jdszza/valoryapsen/README.md

# APSEN — Sistema de Contagem de Medicamentos

> **Projeto de Engenharia Mecatrônica — 3º ano** · Valory · APSEN Farmacêutica

Célula automatizada que monta Ordens de Saída (OS) de medicamento e valida cada
dispensa por **três fontes independentes**. Roda hoje inteira em Docker, com os
sensores e atuadores simulados; os três firmwares que vão substituir os
simuladores já têm contrato e transporte prontos do lado Python.

| Onde está o quê | |
|---|---|
| **Como o sistema funciona e como rodá-lo** | este arquivo |
| **Por que cada decisão foi tomada** (e as armadilhas) | `CLAUDE.md` |
| **Contrato serial adapter ↔ firmware** | [`docs/PROTOCOLO_SERIAL.md`](docs/PROTOCOLO_SERIAL.md) |
| **As estações de visão reais** | [`vision/README.md`](vision/README.md) |
| **Painel de bancada e display de 7"** | [`docs/BANCADA.md`](docs/BANCADA.md) |

---

## Índice

- [Visão geral](#visão-geral)
- [Arquitetura](#arquitetura) — serviços, os dois transportes, o estado dos firmwares
- [A célula por dentro](#a-célula-por-dentro) — layout, câmeras, Triple Check, fluxo
- [As 10 ordens padrão](#as-10-ordens-padrão)
- [Subir a stack](#subir-a-stack)
- [Rodar tudo integrado, passo a passo](#rodar-tudo-integrado-passo-a-passo) — a célula montada, com placas e câmeras de verdade
- [Portas seriais na célula montada](#portas-seriais-na-célula-montada) — ⚠️ leia antes de ligar as placas
- [Operar](#operar) — console, modo apresentação, injeção, reset, pré-voo
- [Roteiro de demonstração](#roteiro-de-demonstração)
- [Testes](#testes)
- [Painel de bancada](#painel-de-bancada)
- [Interfaces e segredos](#interfaces-e-segredos)
- [Endpoints](#endpoints)
- [Estrutura do repositório](#estrutura-do-repositório)
- [Variáveis de ambiente](#variáveis-de-ambiente)
- [Concorrência e segurança](#concorrência-e-segurança)

---

## Visão geral

Uma mesa CNC percorre o corredor entre **duas fileiras de 4 dispensers**, frente
a frente, coletando os medicamentos de cada OS. **Três câmeras** validam a
célula: uma sobre cada fileira (lendo o QR/DataMatrix do produto carregado em
cada slot) e uma sobre a mesa de coleta — a **câmera da balança** —, que conta
visualmente as unidades dispensadas. Uma célula de carga HX711 sob a mesa pesa
cada lote.

Depois de cada dispensa, o **Triple Check** compara as três fontes (contagem do
dispenser, câmera da mesa, balança). **Uma divergência já trava o sistema** até
um supervisor liberar.

Comunicação 100% REST/HTTP + WebSocket — **sem MQTT**. MySQL para persistência,
Plotly Dash para as interfaces.

### Duas metades, que sobem separado

| Metade | O que é | Como sobe | Portas |
|---|---|---|---|
| **Célula** | central, 4 adapters, 4 simuladores, ERP, dashboard, manutenção | `docker compose up` | 8000, 8050, 8051 |
| **Painel de bancada** | Flask + SQLite + display ESP32 por USB serial | `python app.py` na máquina da bancada | 5000 |

O painel **não** está no compose de propósito: ele é dono de uma porta serial, e
container Linux não enxerga a COM do host. Ver [`docs/BANCADA.md`](docs/BANCADA.md).

---

## Arquitetura

```
ERP Simulator (dispara 1 das 10 ordens padrão, com os_id novo)
  │ POST /api/v1/ordens
  ▼
┌────────────────────────────────────────────────────────────────────┐
│                     Central Computer  :8000                        │
│   Orquestrador (orchestrator.py)                                   │
│   • fila de OS (1 por vez, teto MAX_FILA_OS)                       │
│   • atribuição de slots por categoria / residual                   │
│   • rota CNC em serpentina (duas fileiras)                         │
│   • carga → visão dispenser → CNC → dispensa → visão mesa →        │
│     peso → Triple Check                                            │
│   • trava de erro: bloqueia até supervisor/admin liberar           │
│   REST + MySQL + WebSocket /ws + console /console                  │
└──────┬────────────────┬─────────────────┬───────────────┬──────────┘
       │                │                 │               │
┌──────▼──────┐  ┌──────▼──────┐  ┌──────▼──────┐  ┌──────▼──────┐
│  Dispenser  │  │    CNC      │  │   Vision    │  │   Weight    │
│  Adapter    │  │   Adapter   │  │   Adapter   │  │   Adapter   │
│   :8100     │  │    :8101    │  │    :8102    │  │    :8103    │
└──────┬──────┘  └──────┬──────┘  └──────┬──────┘  └──────┬──────┘
       │ http | serial  │ http | serial   │ http          │ http | serial
┌──────▼──────┐  ┌──────▼──────┐  ┌──────▼──────┐  ┌──────▼──────┐
│  Dispenser  │  │    CNC      │  │   Vision    │  │   Weight    │
│  Simulator  │  │  Simulator  │  │  Simulator  │  │  Simulator  │
│   :8201     │  │    :8200    │  │    :8202    │  │    :8203    │
│  8 slots    │  │ mesa CNC    │  │ 3 câmeras   │  │ HX711       │
└─────────────┘  └─────────────┘  └─────────────┘  └─────────────┘

Dashboard  :8050  ←─ polling /estado ──────── Central
Manutenção :8051  ←─ JWT + REST + WS ──────── Central
MySQL      :3306  ←─ pymysql (pool) ───────── Central
Painel     :5000  ─ GET (espelho de mão única) → Central
                   └─ USB serial → display ESP32 7"
```

### Serviços Docker (13)

| Serviço | Porta | Função |
|---|---|---|
| `mysql` | 3306 | MySQL 8 — 11 tabelas, 96 medicamentos no seed |
| `central-computer` | 8000 | Orquestrador, API REST, WebSocket, console |
| `dispenser-adapter` | 8100 | Bridge central ↔ dispensers |
| `cnc-adapter` | 8101 | Bridge central ↔ mesa CNC |
| `vision-adapter` | 8102 | Bridge central ↔ câmeras (simulador ou estações reais) |
| `weight-adapter` | 8103 | Bridge central ↔ balança HX711 |
| `dispenser-simulator` | 8201 | Simula os 8 dispensers (mecânico, sem CV) |
| `cnc-simulator` | 8200 | Simula o firmware da mesa |
| `vision-simulator` | 8202 | Simula as 3 câmeras (rollback das estações reais) |
| `weight-simulator` | 8203 | Simula a célula de carga sob a mesa |
| `erp-simulator` | — | O ERP do hospital: dispara 1 das 10 ordens por ciclo |
| `dashboard` | 8050 | Monitoramento read-only (Dash) |
| `manut_web` | 8051 | Manutenção e operação, com JWT (Dash) |

O **`porta-adapter`** (:8104, a ponte central ↔ porta NR-12) **não** está nesta
tabela de propósito: ele não tem serviço no compose. Não existe porta simulada,
e na célula montada ele roda no host, dono da COM do ESP RECEPTOR da porta,
que ele só LÊ (`porta-adapter\iniciar_host.bat`; `docs/PROTOCOLO_SERIAL.md` §10). Sem porta na célula
(`PORTA_NR12_HABILITADA=0`, o default) ninguém fala com ele.

**Ordem de subida.** Todos os serviços de aplicação têm healthcheck (menos o
`erp-simulator`, que é worker de laço sem porta) e as dependências usam
`condition: service_healthy`. O grafo é
`mysql → central → adapters → erp-simulator`, com os simuladores entrando ao
lado do central. O central **não** depende dos adapters — seria ciclo, e ele
tolera adapter fora do ar.

**Profiles.** Os três adapters seriais e os quatro simuladores ficam atrás do
profile `simulado` (`COMPOSE_PROFILES=simulado` no `.env`): na célula montada,
em Windows, eles não sobem em container (o `porta-adapter` nunca sobe: não
está no compose) — ver
[Portas seriais na célula montada](#portas-seriais-na-célula-montada).

### Os adapters têm DOIS transportes

Cada adapter fala com a ponta de baixo por HTTP (o simulador) **ou** por serial
(o firmware), e quem escolhe é uma env var. O default é `http`:

| Variável | Default | |
|---|---|---|
| `<SUB>_TRANSPORTE` | `http` | `http` = simulador, `serial` = firmware |
| `<SUB>_SERIAL_URL` | vazia | vazia = varre as portas e detecta pelo ping da placa |
| `<SUB>_SERIAL_BAUD` | `115200` | |
| `<SUB>_ACK_TIMEOUT_S` | `2` | prazo do ACK, **não** da conclusão |

`<SUB>` é `DISPENSER`, `CNC` ou `WEIGHT`. O `vision-adapter` não entra: a visão
continua por HTTP. O `porta-adapter` (porta NR-12, :8104) também não: ele só
tem serial, porque não há porta simulada — `PORTA_SERIAL_URL` é obrigatória e
não existe `PORTA_TRANSPORTE`.

A **perna de cima não muda**: mesmos endpoints `/comandos/*`, mesmos modelos,
mesmo payload de evento indo ao central sem interpretação. Por isso trocar o
simulador por firmware não toca em `central-computer/`. Contrato completo em
[`docs/PROTOCOLO_SERIAL.md`](docs/PROTOCOLO_SERIAL.md); o transporte é o
`serial_link.py` (cópia idêntica nos três adapters de transporte selecionável,
com teste que cobra a igualdade). O `porta-adapter` não tem cópia: em campo a
porta NR-12 fala texto e ele só LÊ (`leitor_linhas.py`, §10 do protocolo).

Há uma **segunda porta** no dispenser-adapter: as 8 telas TFT
(`dispenser_tft`, `DISPENSER_TFT_*`), espelho do que cada slot está fazendo.
Com o default (`http`) não há tela e o adapter é o de sempre.

**Onde a porta é aberta depende do sistema operacional do mini PC.** Em Linux
a porta entra no container pelo `devices:` do compose — o bloco está escrito e
**comentado** nos três serviços. **A célula montada roda em Windows**, e lá o
Docker Desktop não repassa COM para container: os três adapters seriais — e o
`porta-adapter`, que nem tem serviço no compose — rodam **fora do Docker**, no host, abrindo a COM direto com pyserial — a ponte
RFC2217 foi avaliada e preterida. O porquê, e o passo a passo, estão em
[Portas seriais na célula montada](#portas-seriais-na-célula-montada) e em
[`docs/DEPLOY_WINDOWS.md`](docs/DEPLOY_WINDOWS.md).

### Os firmwares das placas

Três subsistemas têm placa própria, e **elas não estão no mesmo ponto**:

| Subsistema | Pasta | Estado | Manual |
|---|---|---|---|
| `dispenser` + `dispenser_tft` | `dispenser/` | fala as duas vozes | [`dispenser/README.md`](dispenser/README.md) · [primeiro ensaio](dispenser/PRIMEIRO_ENSAIO.md) |
| `weight` | `weight/` | fala as duas vozes | [`weight/README.md`](weight/README.md) · [primeiro ensaio](weight/PRIMEIRO_ENSAIO.md) |
| `cnc` | `cnc/` | fala as duas vozes | [`cnc/README.md`](cnc/README.md) |

**"Duas vozes" é o que faz as duas conversas caberem na mesma porta USB.** Toda
linha de máquina tem um `{`; toda linha sem `{` é log do operador, e o adapter
extrai o JSON a partir do primeiro `{` — então log e JSON podem sair **grudados**
na mesma linha, que é o que os firmwares realmente fazem no boot. Nada do que o
terminal de bancada imprimia foi removido: é isso que mantém cada placa
utilizável sozinha, com o Monitor Serial, no dia em que o resto da planta
estiver fora do ar.

**A mesa CNC ainda não tem a segunda voz**, e ligar `CNC_TRANSPORTE=serial`
nela não dá erro na subida — dá um adapter que se anuncia conectado e uma
planta que não anda. Ela fica no default (`http`, o `cnc_simulator`) até lá; o
firmware que existe hoje é máquina de bancada, e é com ele que se gravam as dez
receitas.

### Fontes de verdade

Cada campo do estado tem **um** dono, e a linha entre os dois é o que impede a
telemetria de desfazer o fluxo:

| Dono | Manda em | Campos |
|---|---|---|
| **Simulador** (ou firmware) | hardware e estoque | `medicamento`, `sku`, `categoria`, `quantidade` |
| **Orquestrador** | fluxo da OS | `status` da etapa, `os_id` em execução |

O evento `status` do dispenser é **telemetria periódica** (a cada 15 s, para
todos os slots) e só pode tocar na primeira linha da tabela. Quando ele
encostava no fluxo, desfazia o reset de fim de OS a cada ciclo. Quem move o
fluxo são os eventos de **transição**: `carregado`, `dispensado`, `limpeza_ok`,
`erro`.

O mesmo vale para os dois lados do status de uma OS: `_estado["os_ativa"]`
(memória, para o WebSocket) e `ordens.status` (banco, para quem consulta por
HTTP) contam a mesma história para públicos diferentes, e **os dois precisam ser
escritos** — toda saída de `_processar_os` fecha em status terminal
(`concluida`, `erro` ou `cancelada`).

---

## A célula por dentro

### Layout físico

```
             x=0     x=120   x=240   x=360
              │       │       │       │
   fileira    D1      D2      D3      D4        y = -150 mm
   esquerda   ▔▔      ▔▔      ▔▔      ▔▔
  ─ ─ ─ ─ ─ ─ ─ ─ ─ ─ ─ ─ ─ ─ ─ ─ ─ ─ ─ ─ ─ ─   y =    0 mm  ← corredor da CNC
   ●HOME      ▁▁      ▁▁      ▁▁      ▁▁
   (-120,0)   D5      D6      D7      D8        y = +150 mm
   fileira direita
```

Os pares frente a frente são D1↔D5, D2↔D6, D3↔D7 e D4↔D8 — consequência da
numeração: o slot `i` e o slot `i + NUM_SLOTS/2` compartilham o X.

**A geometria tem um dono só.** Passo (120 mm), afastamento (150 mm), HOME e
`NUM_SLOTS` são constantes no topo de `orchestrator.py`, e `POSICOES` é derivado
delas. O `cnc-simulator` não guarda cópia: recebe `posicao_x`/`posicao_y` em
cada comando e só valida a faixa do id.

**Rota em serpentina** — desce uma fileira em X crescente, volta pela outra em X
decrescente. O ciclo é fechado (HOME → slots → HOME) e todos os pontos estão na
borda de um polígono convexo, então a ordem do contorno *é* o trajeto ótimo:
medido por força bruta nos 255 subconjuntos de 8 slots, acerta o ótimo em
255/255, contra um nearest-neighbor 4,1% pior em média e 40,4% no pior caso.

### As três câmeras

| Câmera | `camera` | Cobre | Valida | Bloqueia? |
|---|---|---|---|---|
| Fileira esquerda | `dispenser_esq` | D1–D4 | SKU do produto carregado | **sim**, se o SKU não bate |
| Fileira direita | `dispenser_dir` | D5–D8 | SKU do produto carregado | **sim**, se o SKU não bate |
| Mesa (**a da balança**) | `mesa` | mesa de coleta | contagem das unidades | **sim**, via Triple Check |

As duas de dispenser emitem os **mesmos tipos de evento**; o que separa uma da
outra é o campo `camera`. Quem escolhe a câmera é o simulador, derivando o lado
do próprio `slot_id` — o central manda só o slot. Falha de leitura (a câmera não
conseguiu ler) é **não-bloqueante**: gera alarme e a OS continua.

`PROB_FALHA_LEITURA_DISPENSER` e `PROB_DIVERGENCIA_DISPENSER` valem para as
duas; o sufixo `_ESQ`/`_DIR` sobrescreve uma delas (para simular uma lente
suja). A da mesa é uma só.

**As câmeras reais** são três estações de visão no host (donas das webcams USB),
e cada câmera escolhe a sua fonte no vision-adapter (`VISAO_MESA_FONTE`,
`VISAO_DISPENSER_FONTE`: `simulador` ou `estacao`):

| Estação | Pasta | Porta | Como fala com o vision-adapter |
|---|---|---|---|
| mesa | `vision/visao_mesa` | 8212 | fala o mesmo contrato do simulador: o adapter só troca o endereço (`VISION_SIM_URL`) |
| dispensers, esquerda (D1–D4) | `vision/visao_esq` (cópia de `vision/visao`) | 8301 | não recebe comando: lê o catálogo da OS no adapter e publica o veredito; o adapter o traduz em `leitura_dispenser_*` |
| dispensers, direita (D5–D8) | `vision/visao_dir` (idem) | 8302 | idem |

O vision-simulator continua no compose como rollback: voltar a ele é tirar as
variáveis do `.env`. Detalhes em [`vision/README.md`](vision/README.md) e em
[`docs/DEPLOY_WINDOWS.md`](docs/DEPLOY_WINDOWS.md).

### Triple Check

| Fonte | O que mede | Evento divergente |
|---|---|---|
| Dispenser | quantidade contada mecanicamente | `dispensado` com `quantidade_dispensada` ≠ alvo |
| Câmera da mesa | contagem por visão | `leitura_mesa_divergencia` |
| Balança HX711 | delta de peso do slot, em g | `peso_divergencia` |

**Uma divergência já trava.** A OS é suspensa (não abortada), um alarme
`trava_ativada` vai ao banco, `trava.ativa` sai pelo WebSocket e só admin ou
supervisor libera. O limiar é 1 porque os dois erros não custam o mesmo: parar
uma OS boa custa uma liberação; deixar passar uma ruim custa medicamento errado
no leito. Ajustável por `TRIPLE_CHECK_MIN_DIVERGENCIAS` (1–3) — acima de 1, o
que passa por baixo vira o alarme `divergencia_abaixo_do_limiar`.

**Fonte que não mediu ≠ fonte que divergiu.** Timeout, `leitura_mesa_falha` e
`erro_sensor` entram como *fonte indisponível* e não contam para o limiar: elas
não contradizem nada, apenas deixam de confirmar. Contá-las transformaria os ~2%
de falha de leitura em trava por ruído — e trava por ruído é trava desligada em
campo.

**A exceção: câmera da mesa contando a MENOS, sozinha, não trava.** A câmera é
fixa num poste e olha a caixa de coleta inclinada, e a visão não distingue
caixinha escondida atrás da parede da caixa de caixinha que não caiu — não há
critério de oclusão na estação. Contar a menos só conta como divergência se o
dispenser ou a balança também acusarem no mesmo slot; sozinha, a OS segue e
fica o alarme `contagem_camera_abaixo`. Contar a **mais** continua travando:
caixinha a mais não se esconde — é unidade extra ou objeto estranho.

> **Operar este sistema exige supervisor disponível.** Com
> `PROB_ERRO_MECANICO=0.01`, uma OS que usa a célula inteira move ~70 unidades:
> medido em execução contínua, **2 de 5 OS travaram**. O orquestrador é um loop
> único — enquanto a trava não sai, nenhuma outra OS anda e a fila enche por
> trás. Isso é a regra funcionando, não defeito.

### Fluxo de uma OS

```
1.  ERP dispara 1 das 10 ordens padrão → POST /api/v1/ordens
2.  Central atribui slots (categoria / residual aproveitável)
3.  Central planeja a rota em serpentina
4.  tara da balança (zera para esta OS)
5.  carregar TODOS os slots (comandos em paralelo)
6.  escanear TODOS os slots com a câmera da fileira (em paralelo)
    ↳ SKU errado → trava + re-scan depois da liberação
    ↳ falha de leitura → alarme, segue
7.  para cada slot na rota, SEQUENCIALMENTE (a mesa é uma só):
      mover CNC → dispensar → câmera da mesa → pesar → Triple Check
8.  homing
9.  OS marcada como concluída no MySQL
10. broadcast WebSocket para dashboard, manutenção e console
```

Os passos 5 e 6 saem em `gather` porque são de SLOTS diferentes; o passo 7 é
sequencial porque a mesa é única — paralelizar ali mandaria a CNC a dois lugares
ao mesmo tempo.

---

## As 10 ordens padrão

As OS **não são sorteadas item a item**. Existem dez ordens fixas em
`central-computer/os_templates.py`; o acaso que sobrou é **qual delas** dispara.
Para quem observa a planta o comportamento continua imprevisível; para quem
apresenta, o conteúdo de cada OS é conhecido de antemão.

| Template | Ordem | Itens | Perfil |
|---|---|---|---|
| `OS-URO-01` | Urologia — ronda noturna | 2 | a mais curta |
| `OS-DOR-01` | Reumatologia / Dor — lote matinal | 3 | |
| `OS-VITAM-01` | Vitaminas — suplementação ambulatorial | 3 | |
| `OS-GASTRO-01` | Gastroenterologia — leito 118 | 4 | meia célula |
| `OS-SNC-02` | Neurologia — leito 207 (reposição) | 4 | reaproveita residual da SNC-01 |
| `OS-CARDIO-01` | Cardiologia — leito 302 | 5 | |
| `OS-SNC-01` | Neurologia — leito 204 | 5 | |
| `OS-LACTO-01` | Intolerância a lactose — kit flora | 6 | |
| `OS-INFECTO-01` | Infectologia — esquema antibiótico | 6 | |
| `OS-GERAL-01` | Carro de emergência — célula cheia | 8 | rota completa |

Os 39 medicamentos citados são itens reais do catálogo. Seis aparecem em mais de
uma ordem, então disparar `OS-SNC-01` e logo depois `OS-SNC-02` reencontra slots
já carregados e o passo 1 do `atribuir_slots` os usa sem limpar.

**Template fixo, `os_id` único a cada disparo** —
`{template_id}-{AAAAMMDDTHHMMSS}-{6 hex}`, por exemplo
`OS-SNC-01-20260814T221104-A3F291`. `ordens.os_id` é UNIQUE e o central recusa
reenvio com 409; sem o sufixo, a segunda vez que uma ordem padrão fosse
disparada seria rejeitada.

Editar as ordens é mexer só na lista `TEMPLATES` (nome do medicamento como está
no catálogo, quantidade entre 2 e 15). A validação roda no import, no boot do
central e no boot do gerador; `GET /api/v1/ordens/templates` serve as dez com o
diagnóstico junto.

---

## Subir a stack

### Pré-requisitos

- Docker Engine ≥ 24 e Docker Compose v2 (`docker compose version`, sem hífen)
- ~2 GB de RAM
- Python 3.10+ (só para os testes e para o painel de bancada)

### Quickstart

```bash
git clone <url-do-repo> && cd valoryapsen
```

Crie o `.env` (modelo abaixo) com as **cinco obrigatórias**, e então suba os
**13 serviços** da planta simulada:

```bash
docker compose --profile simulado up -d --build
```

(ou `make up`, que faz o mesmo). O `--profile simulado` é o que garante os 13
— sem ele só 7 sobem, o subconjunto que roda em container na célula montada
com hardware de verdade (ver
[Portas seriais na célula montada](#portas-seriais-na-célula-montada), mais
adiante — pode ignorar por enquanto).

A primeira vez leva alguns minutos (build + seed do MySQL). A resposta rápida
para "subiu certo?" é o **pré-voo**: http://localhost:8000/console/prevoo.

### O `.env` da raiz

O compose usa `${VAR:?...}` nas obrigatórias: faltando alguma, ele **recusa
subir** e diz qual. Nenhum segredo tem default.

```bash
python -c "import secrets; print(secrets.token_hex(32))"   # gere a SECRET_KEY
```

```bash
cat > .env <<'FIM'
# ── OBRIGATÓRIAS ─────────────────────────────────────────────────────────────
SECRET_KEY=                 # 64 hex; assina os JWT
MYSQL_ROOT_PASS=
MYSQL_PASS=
SEED_ADMIN_SENHA=           # senha inicial do admin no app de manutenção
SEED_MANUT_SENHA=           # senha inicial do técnico

# ── Planta SIMULADA (desenvolvimento, CI, demonstração) ──────────────────────
# Liga o profile dos adapters seriais e dos simuladores: com esta linha,
# `docker compose up` sobe os 13 serviços. No mini PC da célula montada ela
# fica DE FORA — lá os adapters seriais rodam no host (docs/DEPLOY_WINDOWS.md).
COMPOSE_PROFILES=simulado

# ── Banco ────────────────────────────────────────────────────────────────────
# Credenciais lidas UMA vez, na criação do volume mysql_data. Trocar depois
# exige `docker compose down -v` — que apaga os dados.
MYSQL_USER=apsen
MYSQL_DB=apsen_db

# "dev" tolera SECRET_KEY fraca (só avisa). Qualquer outro valor, inclusive
# vazio, IMPEDE o boot com segredo fraco.
APSEN_ENV=prod

# ── Célula ───────────────────────────────────────────────────────────────────
NUM_SLOTS=8

# Origens de browser autorizadas. `*` não é aceito no central.
CORS_ORIGINS=http://localhost:8050,http://localhost:8051

# ── Demonstração (opcionais) ─────────────────────────────────────────────────
MODO_APRESENTACAO=0         # 1 zera TODA falha aleatória dos simuladores
FATOR_VELOCIDADE=1.0        # 0.5 = dobro da velocidade, 2.0 = metade

# ── Console de operação (opcional) ───────────────────────────────────────────
# Vazia = console DESABILITADO (toda rota /console* responde 503). Senha
# PRÓPRIA, independente do login do app de manutenção. Sem default embutido.
CONSOLE_SENHA=
CONSOLE_SESSAO_HORAS=8
# Estado de boot do switch "Visão no Triple Check" (1 = a visão trava).
VISAO_TRIPLE_CHECK_PADRAO=1
FIM
```

### Esperar ficar saudável

```bash
docker compose ps                       # STATUS deve ler "healthy" em todos
docker compose logs -f central-computer
```

Está pronto quando aparecer:

```
MySQL conectado e schema verificado. Medicamentos OK.
[TEMPLATES] 10 ordens padrão válidas contra o catálogo.
Computador Central APSEN v3.1 iniciado.
```

### Atalhos do Makefile

`make help` lista todos.

| Comando | O que faz |
|---|---|
| `make up` | `docker compose --profile simulado up -d` (recusa se faltar o `.env`) |
| `make build` | build incremental |
| `make rebuild` | **`down -v`** + build sem cache + `up -d` — ⚠️ **APAGA O BANCO** |
| `make down` | derruba containers e rede, **mantém** o banco |
| `make restart` | recria os containers, mantém o banco |
| `make ps` / `make logs` | estado / log agregado |
| `make log-central`, `make log-erp`, … | log de um serviço |
| `make shell-central` / `make shell-mysql` | shell no container |
| `make config` | valida o compose sem subir |
| `make test` / `make lint` | suíte / pyflakes |

> **`make rebuild` não é um `make build` mais forte.** Ele começa com
> `docker compose down -v`, e o `-v` remove o volume `mysql_data` — catálogo,
> usuários, ordens e histórico vão junto. Para reconstruir sem perder o banco:
> `docker compose build --no-cache && docker compose --profile simulado up -d`.

### Rebuild: o que recriar depois de mudar o quê

A pergunta que decide é **se o banco pode ser perdido**.

| Mudou | Comando | Banco |
|---|---|---|
| Só código Python | `docker compose --profile simulado up -d --build` | preservado |
| Um serviço só | `docker compose up -d --build central-computer` | preservado |
| `requirements.txt` | `docker compose build --no-cache <serviço>` + `--profile simulado up -d` | preservado |
| `.env` (variável de runtime) | `docker compose --profile simulado up -d` | preservado |
| `.env` (credencial do MySQL) | `docker compose down -v` + `--profile simulado up -d --build` | **APAGADO** |
| Schema de versão antiga quebrado | `docker compose down -v` + `--profile simulado up -d --build` | **APAGADO** |
| Nome ou `container_name` | `docker compose down` + `--profile simulado up -d --build` | preservado |

`console.html`, `console_login.html` e `console_prevoo.html` são lidos do disco a
cada requisição: editá-los vale com `docker compose restart central-computer`.

### Derrubar

```bash
docker compose stop     # pausa; mantém banco e containers
docker compose down     # remove containers e rede, MANTÉM o banco
docker compose down -v  # remove tudo, inclusive o banco
```

### Profiles: planta simulada × célula montada

Os três adapters com porta serial (`dispenser`, `cnc`, `weight`) e os quatro
simuladores estão atrás do profile `simulado`. Com `COMPOSE_PROFILES=simulado`
no `.env` — a linha está no modelo acima —, `docker compose up` sobe os 13
serviços, como sempre. **Sem a linha**, sobem só os que rodam em container na
célula montada (mysql, central, vision-adapter, vision-simulator, erp-simulator,
dashboard e manut_web): no mini PC Windows os adapters seriais rodam fora do
Docker. Ver [Portas seriais na célula montada](#portas-seriais-na-célula-montada)
e [`docs/DEPLOY_WINDOWS.md`](docs/DEPLOY_WINDOWS.md).

### Problemas comuns

| Sintoma | Causa | O que fazer |
|---|---|---|
| `compose: variable is not set` | falta variável no `.env` | a mensagem diz qual — o `:?` é intencional |
| central sai no boot com `ConfiguracaoInsegura` | `SECRET_KEY` fraca fora de `APSEN_ENV=dev` | gerar chave de 64 hex |
| central em restart loop, log `SchemaInvalido` | banco de versão anterior | `docker compose down -v` e subir de novo |
| `MySQL não disponível (n/30)` | MySQL ainda subindo | normal no primeiro boot; ~30 s |
| dashboard em branco | central ainda não `healthy` | `docker compose ps` |
| `/console` responde 503 | `CONSOLE_SENHA` vazia | definir no `.env` e reiniciar o central |
| OS recusada com 429 | fila no teto (`MAX_FILA_OS=5`) | ver `/api/v1/trava` — quase sempre há trava ativa |
| container órfão depois de renomear serviço | `container_name` mudou | `docker compose down` antes, ou `up -d --remove-orphans` |

---

## Rodar tudo integrado, passo a passo

O [Quickstart](#quickstart) sobe a planta **simulada**: 13 containers, nenhum
hardware. Esta seção sobe a **célula montada**, com as placas e as câmeras de
verdade, no mini PC Windows da bancada. São 15 processos: 7 em container e 8 no
host, porque o Docker Desktop do Windows não repassa porta COM nem webcam para
container.

| # | Processo | Onde | Porta | Dono de |
|---|---|---|---|---|
| 1 | `mysql`, `central-computer`, `vision-adapter`, `vision-simulator`, `erp-simulator`, `dashboard`, `manut_web` | Docker | 3306, 8000, 8102, 8202, —, 8050, 8051 | — |
| 2 | dispenser-adapter | host | 8100 | COM dos mecanismos + COM das telas TFT |
| 3 | cnc-adapter | host | 8101 | COM da mesa |
| 4 | weight-adapter | host | 8103 | COM da balança |
| 5 | porta-adapter | host | 8104 | COM do ESP RECEPTOR da porta NR-12 (só leitura) |
| 6 | painel de bancada | host | 5000 | COM do display de 7" |
| 7 | estação de visão da mesa | host | 8212 | webcam da mesa |
| 8 | estações de visão dos dispensers (esq, dir) | host | 8301, 8302 | webcams das duas fileiras |

O detalhe e o porquê de cada escolha estão em
[`docs/DEPLOY_WINDOWS.md`](docs/DEPLOY_WINDOWS.md). Aqui fica a ordem de fazer.
A **parte A** se faz uma vez, na montagem; a **parte B**, toda vez que a célula
for ligada.

### Parte A — preparação, uma vez por máquina

**A1. Instale no mini PC:**

- Docker Desktop, marcando *Start Docker Desktop when you sign in*;
- Python 3.11, com *Add python.exe to PATH*;
- Git;
- VS Code com PlatformIO, só se for gravar firmware nesta máquina.

**A2. Clone o repositório** num caminho sem espaços (os `.bat` e os venvs
preferem assim):

```bat
cd C:\
git clone <url-do-repo> apsen
cd C:\apsen
```

**A3. Grave os firmwares.** Cada placa tem o seu manual, com o passo a passo de
gravação e o primeiro boot:

| Placa | Manual |
|---|---|
| mecanismos dos dispensers + 8 telas TFT (duas placas) | [`dispenser/README.md`](dispenser/README.md) |
| mesa CNC | [`cnc/README.md`](cnc/README.md), seção "Passo a passo — do zero até a mesa andando" |
| balança HX711 | [`weight/README.md`](weight/README.md) |
| porta NR-12 (ESP da porta + ESP receptor) | [`porta/README.md`](porta/README.md) |
| display de 7" | [`docs/BANCADA.md`](docs/BANCADA.md) |

**A4. Descubra e FIXE a COM de cada placa.** Ligue as placas uma de cada vez,
abra o monitor serial a 115200 e leia o ping: `{"cmd":"ping","sub":"cnc"}` é a
mesa, `"sub":"weight"` a balança, `"sub":"dispenser"` os mecanismos,
`"sub":"dispenser_tft"` as telas; o display manda `{"cmd":"ping"}` sem `sub`.
A porta NR-12 não tem ping: a COM dela é a do ESP **receptor**, que mostra o
banner `=== RECEPTOR Serial2` ao resetar e as linhas `EVT:...` da porta ao passar
uma tag.
Fixe o número no Gerenciador de Dispositivos (*Portas (COM e LPT)* →
*Propriedades* → *Configurações de Porta* → *Avançado…* → *Número da Porta
COM*) e anote na tabela de [`docs/DEPLOY_WINDOWS.md`](docs/DEPLOY_WINDOWS.md),
seção "A tabela de COM por placa". **Feche o monitor serial** depois: no Windows
a porta é de um processo só.

**A5. Escreva cada COM no `.bat` do seu processo**, na primeira linha editável.
É o único lugar onde ela se escreve (o `.env` da raiz é do compose e esses
processos não o leem):

| Arquivo | Linha |
|---|---|
| `dispenser-adapter\iniciar_host.bat` | `DISPENSER_SERIAL_URL` e `DISPENSER_TFT_SERIAL_URL` |
| `cnc-adapter\iniciar_host.bat` | `CNC_SERIAL_URL` |
| `weight-adapter\iniciar_host.bat` | `WEIGHT_SERIAL_URL` |
| `porta-adapter\iniciar_host.bat` | `PORTA_SERIAL_URL` (sem default: vazia, o `.bat` avisa e sai) |
| `painel_operador\iniciar_backend.bat` | `APSEN_DISPLAY_PORTA` |

**A6. Crie os ambientes Python** — um por processo do host, porque cada um tem
as suas dependências (e os dois OpenCV da visão não convivem no mesmo venv):

```bat
for %d in (dispenser-adapter cnc-adapter weight-adapter porta-adapter) do (cd C:\apsen\%d && python -m venv .venv && .venv\Scripts\pip install -r requirements.txt)

cd C:\apsen\painel_operador\backend
python -m venv .venv
.venv\Scripts\pip install -r requirements.txt

cd C:\apsen\vision\visao
python -m venv .venv
.venv\Scripts\pip install -r requirements.txt

cd C:\apsen\vision\visao_mesa
python -m venv .venv
.venv\Scripts\pip install -r requirements.txt -r integracao_apsen\requirements.txt
```

O venv da estação da mesa precisa dos **dois** requirements: sem o segundo, o
servidor dela morre no import. E venv copiado de outra máquina não serve (ele
aponta para o Python de lá): apague a pasta `.venv` e recrie.

**A7. Guarde os segredos do painel no ambiente do Windows.** Gere cada um com
`python -c "import secrets; print(secrets.token_hex(32))"`:

```bat
setx APSEN_SECRET <chave gerada>
setx APSEN_API_TOKEN <outra chave gerada>
```

O `setx` só vale para janelas abertas **depois** dele. A liberação da trava pelo
painel é opcional e precisa de mais duas — `PAINEL_CENTRAL_USER` e
`PAINEL_CENTRAL_SENHA`, uma conta com role `supervisor` criada no app de
manutenção (aba Usuários) depois do passo B1.

**A8. Crie o `.env` da raiz** a partir do [modelo](#o-env-da-raiz), com duas
diferenças para a célula montada:

```bash
# NÃO coloque COMPOSE_PROFILES=simulado aqui: com ele os adapters e os
# simuladores sobem em container por cima dos do host, e a célula física fica
# parada com o dashboard todo verde.

# O central alcança os adapters do HOST por este nome:
DISPENSER_ADAPTER_URL=http://host.docker.internal:8100
CNC_ADAPTER_URL=http://host.docker.internal:8101
WEIGHT_ADAPTER_URL=http://host.docker.internal:8103
# A porta NR-12: o adapter dela também roda no host, e a célula passa a nascer
# PARADA até o estado da porta ser provado (porta muda é porta aberta) — o
# ritual de subida: tag → 10 s → tag (porta/README.md).
PORTA_ADAPTER_URL=http://host.docker.internal:8104
PORTA_NR12_HABILITADA=1

# As três câmeras reais (deixe estas linhas de fora até a parte A10 passar):
VISION_SIM_URL=http://host.docker.internal:8212
VISAO_MESA_FONTE=estacao
VISAO_DISPENSER_FONTE=estacao
VISAO_MESA_POSICOES=<medido na bancada, ex.: 1,2,3,4,5,6,7,8>

# Para usar o console e o pré-voo:
CONSOLE_SENHA=<uma senha>
```

**A9. Libere o firewall** para os containers alcançarem o host. Num prompt de
**Administrador**:

```bat
netsh advfirewall firewall add rule name="APSEN adapters e estacoes" dir=in action=allow protocol=TCP localport=8100,8101,8103,8104,8212,8301,8302 profile=private
```

**A10. Calibre e configure a visão.** É trabalho físico, com procedimento
próprio em [`docs/BANCADA_VISAO.md`](docs/BANCADA_VISAO.md):

1. Crie `vision\visao_mesa\integracao_apsen\.env` com os valores de
   [`docs/DEPLOY_WINDOWS.md`](docs/DEPLOY_WINDOWS.md) (".env da estação da
   mesa"): `ADAPTER_URL=http://127.0.0.1:8102`, `PORTA=8212`, `HOST=0.0.0.0`,
   `ACEITAR_INJECAO=0`, `VALIDADE_OS_H=24`, `T_ASSENTAMENTO_S=1.0`.
2. Calibre a mesa (M1–M5): fundo em modo `"caixa"`, `suavizacao` e
   `frames_validade` em 0, e meça `VISAO_MESA_POSICOES`.
3. Rode `vision\iniciar_dispensers.bat esq` uma vez para criar a pasta e
   feche; idem `dir`. Em cada pasta (`vision\visao_esq`, `vision\visao_dir`):
   `python src\camera.py` (grava a câmera por nome) e `python src\calibrar.py`
   (zonas 1–4 na esquerda, **5–8** na direita), e ponha no
   `config\parametros.json` o `backend.url` do lado —
   `http://127.0.0.1:8102/estacoes/esq` ou `.../estacoes/dir`.
4. Confira tudo de uma vez — os dois scripts dizem o que falta, com o que
   fazer, e saem com erro enquanto faltar algo:

```bat
vision\visao_mesa\.venv\Scripts\python vision\conferir_mesa.py
vision\visao\.venv\Scripts\python vision\conferir_dispensers.py esq
vision\visao\.venv\Scripts\python vision\conferir_dispensers.py dir
```

Enquanto a visão não estiver calibrada, a célula roda com as câmeras
SIMULADAS: basta deixar as linhas da visão fora do `.env` (A8). O resto da
célula não depende delas.

### Parte B — ligar a célula, toda vez

A ordem importa: os processos do host falam com o central, e o central precisa
estar de pé primeiro. Abra **uma janela por processo** — o log de cada porta
fica visível, e "fechou a janela" é um sintoma que qualquer um lê.

**B1. Containers.** Com o Docker Desktop aberto:

```bat
cd C:\apsen
set COMPOSE_PROFILES=
docker compose up -d --build
docker compose ps
```

O `set COMPOSE_PROFILES=` zera o profile `simulado` mesmo que ele tenha ficado no
`.env` (é o que o `make up-bancada` faz): sem isso, os adapters e os simuladores
subiriam em container por cima dos do host. O `--build` só é preciso na
primeira vez e depois de atualizar o código. Espere
os 7 serviços em `healthy` (no primeiro boot, ~1 min: o MySQL cria o banco e o
central semeia o catálogo).

**B2. Os quatro adapters**, cada um na sua janela:

```bat
C:\apsen\dispenser-adapter\iniciar_host.bat
C:\apsen\cnc-adapter\iniciar_host.bat
C:\apsen\weight-adapter\iniciar_host.bat
C:\apsen\porta-adapter\iniciar_host.bat
```

Cada um mostra a COM e o transporte ao subir. Confira que acharam a placa:
`http://localhost:8100/health` (e `8101`, `8103`, `8104`) — `serial` com
`"conectado": true`. No da porta, `checks.estado-porta` começa em
`"desconhecido — passe a tag"` — a porta não tem heartbeat e não responde a
pergunta nenhuma. Faça o ritual de subida (passe a tag, espere os 10 s, passe a
tag de novo): `"link_ok": true` e a célula faz homing e libera. Até lá, o
central mantém a célula parada.

**B3. O painel de bancada:**

```bat
C:\apsen\painel_operador\iniciar_backend.bat
```

Web em http://localhost:5000; o display de 7" sai de OFFLINE em alguns
segundos.

**B4. As três estações de visão** (pule se a visão ainda está simulada):

```bat
C:\apsen\vision\iniciar_mesa.bat
C:\apsen\vision\iniciar_dispensers.bat esq
C:\apsen\vision\iniciar_dispensers.bat dir
```

Cada `.bat` roda o seu conferidor e para em vermelho se algo estiver errado.
Passando, a estação fica num laço: se cair, ela registra a queda e sobe de novo
em 5 s.

**B5. Confira que os containers enxergam o host.** Um teste por porta — se der
timeout, é o firewall (A9):

```bat
docker compose exec central-computer python -c "import urllib.request;print(urllib.request.urlopen('http://host.docker.internal:8101/ping',timeout=3).read())"
docker compose exec vision-adapter python -c "import urllib.request;print(urllib.request.urlopen('http://host.docker.internal:8212/ping',timeout=3).read())"
```

**B6. Pré-voo.** Abra http://localhost:8000/console/prevoo (senha do
`CONSOLE_SENHA`). **Tudo verde é a condição para a primeira OS.** Cada item
vermelho ou amarelo diz o que fazer; o bloco **Visão** cobre as três estações,
a identidade da câmera da mesa e as posições medidas.

### Parte C — a primeira OS

1. Abra o dashboard em http://localhost:8050: ele mostra a bancada nas duas
   fileiras, a CNC no corredor e as três câmeras.
2. No console (http://localhost:8000/console), pause o gerador automático se
   quiser escolher as ordens, e dispare uma das dez ordens padrão.
3. Acompanhe: carregamento dos slots → conferência de SKU pelas câmeras dos
   dispensers → tara → para cada slot, mesa → dispensa → foto da mesa →
   pesagem → Triple Check → HOME. O painel (:5000) e o display espelham a OS.
4. **Se travar:** a faixa vermelha diz o slot e o motivo. Confira a bancada e
   libere — pelo console, pelo app de manutenção (http://localhost:8051, login
   `admin` com o `SEED_ADMIN_SENHA`) ou pelo display, com nome e PIN de
   supervisor.

Os detalhes de cada tela estão em [Operar](#operar), e um roteiro pronto de
apresentação em [Roteiro de demonstração](#roteiro-de-demonstração).

### Parte D — desligar

Na ordem inversa: **Ctrl+C** em cada janela do host (estações de visão,
painel, adapters — nas estações, responda **S** ao "Terminate batch job") e
depois `docker compose stop`. O banco fica preservado. **Nunca**
`docker compose down -v` sem querer apagar o banco.

### Subir sozinho no boot

Com tudo funcionando à mão, automatize a parte B pelo Agendador de Tarefas do
Windows (uma tarefa por `.bat`, gatilho *Ao iniciar a sessão*, na ordem
acima). Ver [`docs/DEPLOY_WINDOWS.md`](docs/DEPLOY_WINDOWS.md), seção "Subir no
boot".

### Quando uma parte não está pronta

| Situação | O que fazer |
|---|---|
| Visão ainda não calibrada | tire do `.env` as linhas `VISION_SIM_URL` e `VISAO_*_FONTE`, recrie o vision-adapter (`docker compose up -d vision-adapter`) e pule B4: as câmeras ficam simuladas |
| Só a câmera da mesa pronta | deixe `VISAO_DISPENSER_FONTE` fora do `.env` (ou `simulador`); e, sem câmeras de dispenser nenhuma, `VISAO_SKU_HABILITADA=0` pula a conferência de SKU |
| Nenhuma placa disponível (demonstração em outra máquina) | use a planta simulada: `COMPOSE_PROFILES=simulado` no `.env`, sem as linhas `*_ADAPTER_URL`, e **não** rode os `.bat` dos adapters ([Quickstart](#quickstart)) |

### Problemas da célula integrada

| Sintoma | Causa provável | O que fazer |
|---|---|---|
| adapter do host não sobe: porta 810x ocupada | o adapter de **container** está de pé | tire `COMPOSE_PROFILES=simulado` do `.env` e rode `set COMPOSE_PROFILES=` e `docker compose up -d --remove-orphans` |
| `/health` do adapter com `"conectado": false` | COM errada, monitor serial aberto, ou placa sem energia | confira o ping no monitor serial e **feche-o** antes de subir o adapter |
| `ACCESS_DENIED` numa COM "livre" | processo duplicado | `tasklist \| findstr python` e feche o que sobrou |
| central não alcança o adapter (pré-voo vermelho em 810x) | firewall, ou `*_ADAPTER_URL` faltando no `.env` | A9 e A8; teste com o comando de B5 |
| dashboard verde e a célula física parada | `COMPOSE_PROFILES=simulado` no `.env` do mini PC | tire a linha e suba de novo |
| display OFFLINE | monitor serial aberto na COM do display, ou `APSEN_DISPLAY_PORTA` errada | feche o monitor; confira o `.bat` do painel |
| célula parada com "LINK DA PORTA PERDIDO" | porta-adapter parado (ficou parado depois de cadastrar tag?), USB da porta solta, ou `PORTA_SERIAL_URL` errada | suba `porta-adapter\iniciar_host.bat` e confira `http://localhost:8104/health` (bloco `porta`, `"link_ok": true`) |
| log do dispenser-adapter: "firmware das telas antigo: ainda repassa a porta" | a placa das telas foi gravada antes de a porta ganhar USB própria | regrave `dispenser/telas_tft`; o evento é descartado até lá |
| estação de visão não sobe, conferidor vermelho | configuração da estação | faça o que o conferidor diz — ver A10 |
| pré-voo: "Quem responde pela câmera da mesa" vermelho | `VISION_SIM_URL` e `VISAO_MESA_FONTE` desencontrados no `.env` | corrija e `docker compose up -d vision-adapter` |

---

## Portas seriais na célula montada

> **Só se aplica a quem tem hardware de verdade.** Testando a planta simulada
> (o caminho da seção anterior, `docker compose --profile simulado up`)? Pule
> para [Operar](#operar) — nada aqui muda o comportamento com o simulador.

> ⚠️ **No mini PC, toda placa tem que ter o número da COM fixado e a variável
> de porta preenchida. A varredura automática é só para desenvolvimento sem
> hardware.** Seis portas, cada uma com o seu dono — nenhuma é descoberta por
> varredura, e o `porta-adapter` nem sobe sem a dele.

| Placa | Subsistema | Variável | Processo (no host) | Manual da placa |
|---|---|---|---|---|
| mecanismos dos 8 dispensers | `dispenser` | `DISPENSER_SERIAL_URL` | dispenser-adapter | [`dispenser/README.md`](dispenser/README.md) |
| as 8 telas TFT | `dispenser_tft` | `DISPENSER_TFT_SERIAL_URL` | dispenser-adapter (a segunda porta do mesmo processo) | [`dispenser/README.md`](dispenser/README.md) |
| mesa CNC | `cnc` | `CNC_SERIAL_URL` | cnc-adapter | [`cnc/README.md`](cnc/README.md) |
| balança HX711 | `weight` | `WEIGHT_SERIAL_URL` | weight-adapter | [`weight/README.md`](weight/README.md) |
| display de 7" | — | `APSEN_DISPLAY_PORTA` | painel_operador | [`docs/BANCADA.md`](docs/BANCADA.md) |
| ESP da porta NR-12 | `porta` | `PORTA_SERIAL_URL` (**obrigatória**) | porta-adapter (:8104) — USB PRÓPRIA no mini PC | [`porta/README.md`](porta/README.md) |

> **A porta NR-12 tem USB própria e adapter próprio.** A ESP dela (RC522 + dois
> fins de curso; cada porta é presa por um ímã simples, sem fechadura elétrica)
> é uma placa dedicada, como a balança e a CNC: o dono da COM dela é o
> `porta-adapter` (host, :8104), e ela não passa pela placa das telas — travar
> ou regravar as telas não cega a vigia da porta. Na mesma USB andam as duas
> vozes de sempre: JSON (`{`) é a máquina; linha sem `{` é a bancada — os
> comandos `R`, `S`, `C`, `L`, `E` do Monitor Serial. **Para cadastrar tag,
> pare o porta-adapter antes**: no Windows a COM abre em um programa por vez
> (e, com ele parado, a célula para — link perdido é porta aberta). Contrato em
> [`docs/PROTOCOLO_SERIAL.md`](docs/PROTOCOLO_SERIAL.md) §9.
>
> **A placa das telas TFT é só telas.** Não há mais fio entre as duas ESPs, e
> GPIO16/17 das duas ficaram livres.

> **A mesa CNC entra por aqui como as outras.** O firmware
> (`cnc/receitas_manuais`) fala as duas vozes desde a frente do ciclo por
> relógio: ele atende `mover`, `homing` e `estado_celula`, é endereçado por
> `dispenser_alvo` e REPORTA a posição alcançada. O que ficou pendente é de
> bancada — medir os prazos do cronograma e gravar as dez receitas —, e está no
> fim de [`cnc/README.md`](cnc/README.md).

### Onde escrever o número da COM

**Na primeira linha editável do `.bat` daquele processo.** São cinco `.bat`,
um por processo do host, todos no mesmo molde: abra, troque o número da COM,
salve, rode.

| Processo | Placa | Arquivo | Variável |
|---|---|---|---|
| dispenser-adapter | mecanismos dos 8 dispensers | [`dispenser-adapter/iniciar_host.bat`](dispenser-adapter/iniciar_host.bat) | `DISPENSER_SERIAL_URL` |
| " | as 8 telas TFT | o **mesmo** arquivo, a linha de baixo | `DISPENSER_TFT_SERIAL_URL` |
| cnc-adapter | mesa CNC | [`cnc-adapter/iniciar_host.bat`](cnc-adapter/iniciar_host.bat) | `CNC_SERIAL_URL` |
| weight-adapter | balança HX711 | [`weight-adapter/iniciar_host.bat`](weight-adapter/iniciar_host.bat) | `WEIGHT_SERIAL_URL` |
| porta-adapter | porta NR-12 | [`porta-adapter/iniciar_host.bat`](porta-adapter/iniciar_host.bat) | `PORTA_SERIAL_URL` |
| painel de bancada | display de 7" | [`painel_operador/iniciar_backend.bat`](painel_operador/iniciar_backend.bat) | `APSEN_DISPLAY_PORTA` |

Cada arquivo tem no topo o bloco *a única linha que você precisa editar*. Fora
a COM, ele já liga o transporte serial, aponta o `CENTRAL_URL` para
`http://localhost:8000` — `central-computer:8000` é nome DNS da rede Docker e
**não resolve no host**, a mesma armadilha do `BACKEND_URL` — e sobe o processo
na mesma porta HTTP que o compose publicava, para que o central, o dashboard e
o pré-voo não notem diferença. **Rodar o `.bat` é tudo que a bancada faz.**

Quem preferir não editar arquivo exporta a variável antes: os `.bat` só aplicam
o próprio default quando ela vem vazia (`if "%VAR%"=="" set VAR=...`).

```bat
set WEIGHT_SERIAL_URL=COM9
weight-adapter\iniciar_host.bat
```

Duas coisas que o `.bat` **não** é:

* **não é o `.env` da raiz.** O `.env` alimenta o **compose**, e na célula
  montada esses processos rodam fora do Docker — ninguém lê o `.env`
  deles. Escrever `CNC_SERIAL_URL=COM5` lá, no Windows, não chega a processo
  nenhum e **não dá erro**: o adapter do host sobe varrendo as portas, como se
  a variável estivesse vazia. (No caminho Linux, com o `devices:` do compose
  descomentado, aí sim quem lê é o container, e o lugar é o `.env`.)
* **não é o `setx` do Windows.** Ele continua valendo para segredos que não
  entram em arquivo versionado — `APSEN_SECRET`, `APSEN_API_TOKEN` —, e o
  `.bat` do painel checa os dois antes de subir.

**Se a porta HTTP do adapter estiver ocupada**, o adapter de *container* está de
pé: `docker compose stop <adapter>`, ou tire o `COMPOSE_PROFILES=simulado` do
`.env`.

**Por que a porta fixa é obrigatória.** Com a variável vazia, cada adapter
varre todas as portas procurando a sua placa, e em cada candidata gasta
`PROBE_ASSENTAR_S` (1,5 s) + `PROBE_ESPERA_S` (8 s) = **até 9,5 s**; o painel faz
o mesmo em `find_display_port`, e repete a cada 3 s, para sempre. A competição
não é por uma porta compartilhada — cada placa tem a sua. Ela existe porque,
**durante a busca, cada processo abre as portas dos outros** para descobrir se a
placa dele está ali: enquanto o dispenser-adapter segura por 9,5 s a COM da CNC
só para conferir, o cnc-adapter toma `ACCESS_DENIED` na própria porta. A conta é
**5 processos × até 9,5 s por porta sondada**, e o resultado não é um erro: é um
boot não-determinístico de dezenas de segundos, em que uma placa às vezes
simplesmente não é achada no ciclo. Fixar a porta elimina a varredura, e sem
varredura não há competição. A sondagem continua abrindo com **DTR/RTS
desligados** (nessa placa esses sinais são o circuito de reset do ESP32-S3) e
confirmando pelo ping — fixar o número não dispensa conferir a placa.

**Fixar a COM no Windows.** Gerenciador de Dispositivos → *Portas (COM e LPT)*
→ *Propriedades* → *Configurações de Porta* → *Avançado…* → *Número da Porta
COM*. O Windows deixa **entradas fantasma** de portas já usadas (aparecem como
"em uso"): *Exibir → Mostrar dispositivos ocultos* para vê-las e apagá-las.
Qual placa é qual: o ping de cada uma carrega o `sub` (`{"cmd":"ping","sub":"cnc"}`);
o display manda `{"cmd":"ping"}` sem `sub`.

**Só um processo pode abrir a porta — e agora são seis.** O lembrete que
[`docs/BANCADA.md`](docs/BANCADA.md) já traz para o display vale para as seis:
o Serial Monitor do PlatformIO aberto em qualquer uma delas derruba quem deveria
estar com ela, e o sintoma é só "desconectado" no `/health` do adapter (ou
`OFFLINE` no display). Feche-o antes de subir os processos.

**Onde cada processo roda, e o resto do deploy** — o que fica em container, as
variáveis de cada adapter no host (`CENTRAL_URL=http://localhost:8000`, e o
central os alcança por `http://host.docker.internal:81xx`), o profile
`simulado` do compose e como subir tudo no boot — está em
[`docs/DEPLOY_WINDOWS.md`](docs/DEPLOY_WINDOWS.md).

---

## Operar

### Console de operação — http://localhost:8000/console

A mesa de onde se escolhe **qual** das dez ordens entra e **quando**. Existe para
a hora da apresentação, quando o sorteio do ERP — que é o que dá naturalidade à
planta rodando sozinha — passa a atrapalhar quem precisa mostrar um caso
específico.

| Ação | Detalhe |
|---|---|
| Listar as 10 ordens | nome, categoria, itens, quantos slots ocupa |
| Disparar qualquer uma | um clique, sem confirmação — `os_id` novo a cada disparo |
| Pausar / retomar o automático | assume o controle sem competir com o ERP |
| Estado ao vivo | OS ativa, fila, trava (com motivo e slot) e os 8 dispensers |
| Liberar a trava | **com confirmação** |
| **Visão no Triple Check** | switch no topo, um clique — desligado, as câmeras não travam a OS |
| **Armar uma falha** | tipo + slot; dispara uma vez e se desarma sozinha |
| **Resetar a planta** | **com confirmação** |
| **Semear histórico** | **com confirmação** — dado de DEMONSTRAÇÃO |
| **Pré-voo** | tela à parte, em `/console/prevoo` |

**Acesso.** Rota discreta (fora do Swagger), senha `CONSOLE_SENHA` do `.env` —
própria do console, independente do JWT do app de manutenção. Sessão em cookie
`HttpOnly` assinado por HMAC, válida por `CONSOLE_SESSAO_HORAS` e restrita ao
path `/console`; trocar a senha invalida na hora as sessões abertas. Cinco erros
em um minuto bloqueiam a origem por um minuto.

> **Sem `CONSOLE_SENHA` o console não existe**: toda rota `/console*` responde
> **503** com a instrução de definir a variável. Não há senha default embutida —
> ela estaria versionada aqui e abriria o disparo de OS para quem lesse o
> repositório.

O disparo manual **é** o `POST /api/v1/ordens`: o console monta o corpo com
`os_templates.instanciar` e chama a mesma função do endpoint, então 409, 429 e
503 chegam à tela porque é o mesmo código respondendo.

**A pausa é um flag que o ERP consulta** (`GET /api/v1/gerador`), não um
`docker stop`: o container segue de pé e volta a produzir no instante em que o
console despausa. Não é persistida — restart do central retoma o automático.
Pausar **não** bloqueia o disparo manual.

**O switch "Visão no Triple Check" tira a visão do veredito numa emergência.**
Desligado, a câmera da mesa, as câmeras dos dispensers e as fotos VAZIA/FINAL
continuam medindo e registrando, mas o que disserem vira o alarme
`visao_ignorada` em vez de travar; balança, dispenser e porta NR-12 continuam
decidindo como sempre. Vale no próximo veredito, não libera trava já ativa
(desligue → libere pelo botão de sempre) e não é persistido: todo boot nasce em
`VISAO_TRIPLE_CHECK_PADRAO`.

### Modo apresentação

Dois controles globais no `.env`, válidos para o central e os quatro simuladores
de uma vez. São env vars: `docker compose --profile simulado up -d` basta, sem rebuild.

```bash
MODO_APRESENTACAO=1     # planta determinística: nenhuma falha aleatória
FATOR_VELOCIDADE=2.0    # metade da velocidade, para narrar cada etapa
```

`MODO_APRESENTACAO=1` zera **probabilidade de falha**, não aleatoriedade em
geral: erro mecânico, falhas e divergências das 3 câmeras, erro do HX711 e o
`RUIDO_G` da balança vão a zero; confiança da leitura, jitter de temperatura e
horas de uso continuam variando (é textura, não falha). O que ele **não**
desliga é a detecção — a balança segue divergindo quando a quantidade que caiu
na mesa não bate com a esperada.

`FATOR_VELOCIDADE` multiplica todo `T_*`, **divide** `VEL_MM_S` (velocidade é o
inverso de tempo) e escala os `TIMEOUT_*` do central por `max(1, fator)` —
desacelerar sem isso abortaria a OS por `timeout_carregamento` culpando o
dispenser, que fez exatamente o que se pediu. `INTERVALO_OS` do ERP não escala:
é a cadência com que se *quer* ordens.

### Injeção de falha sob demanda

Sem ela, o Triple Check só aparece quando o sorteio colabora. No console você
arma **um** gatilho (tipo + slot); ele dispara na próxima ocorrência aplicável e
se desarma sozinho.

| Tipo | Efeito | Trava? |
|---|---|---|
| `sku_dispenser` | a câmera da fileira lê um SKU que não bate | **sim** — e entra no laço de re-scan |
| `falha_leitura_dispenser` | a câmera não consegue ler | não — alarme, a OS continua |
| `divergencia_mesa` | a câmera da balança conta uma a mais | **sim** |
| `divergencia_peso` | o HX711 mede fora da tolerância | **sim** |
| `falha_mecanica_dispenser` | o dispenser solta uma unidade a menos | **sim**, pela balança |

O último é o mais completo de mostrar: a falha é FÍSICA e a balança a detecta
sozinha — uma unidade de 15 já é 6,7% contra 5% de tolerância. A trava nasce de
um erro real, não de um sensor mentindo.

**Funciona com `MODO_APRESENTACAO` ligado** — o modo desliga o acaso, a injeção
liga o que você escolheu; são controles independentes. Nada persiste, e o log
diz de forma inequívoca quando a falha foi provocada (o evento carrega
`falha_injetada: true`).

### Reset rápido

O botão **Resetar** devolve a bancada ao estado de boot em segundos, sem
`down -v`: esvazia a fila (as OS que esperavam são **canceladas** no banco),
libera a trava, desarma a injeção, manda `cmd_limpar` nos 8 slots e **espera
confirmação**, zera a balança e leva a CNC para HOME. Apagar o histórico é opção
à parte, e o default é **preservar**. Catálogo, usuários e log de manutenção
nunca são apagados.

> **Recusa (409) enquanto houver OS em execução.** Resetar por cima mandaria
> limpar um slot que está dispensando, zeraria a balança no meio de uma pesagem
> e abortaria a OS por uma divergência que ninguém provocou. Com a trava ativa,
> libere-a primeiro — o botão está ao lado.

### Histórico de demonstração

> ⚠️ **Dado fabricado.** Nada disto aconteceu na planta.

O botão **Semear** cria N ordens concluídas nos últimos D dias, com dispensas,
alarmes já resolvidos e curvas de temperatura — para o dashboard não abrir vazio
numa instalação nova. Tudo coerente: as OS saem das dez ordens padrão, o SKU vem
do catálogo real, os horários caem no turno e a duração cresce com o número de
slots. **Todo `os_id` semeado começa com `DEMO-`**, então dado de demonstração e
operação real nunca se confundem. Nunca roda sozinho — só pela rota do console.

### Pré-voo — http://localhost:8000/console/prevoo

A tela que se lê cinco minutos antes de apresentar. Responde "pronto" ou "N itens
impedem a apresentação" em cima, e a lista item a item abaixo.

| Grupo | Itens |
|---|---|
| Serviços | os 13 do compose — 11 sondados em `/ping`, o central por dentro, o ERP como informação |
| Banco | MySQL conectado, schema completo, catálogo populado, os 8 slots |
| Ordens | as 10 ordens válidas contra o catálogo; ocupação da fila |
| Célula | trava, posição da CNC, OS em execução, alarmes abertos |
| Modo | apresentação ou realista, fator de velocidade, falha armada, clientes WS |

**Todo item vermelho ou amarelo diz o que fazer** — é o que separa a tela de um
relatório. **Amarelo não derruba o veredito**: modo apresentação ligado ou CNC
fora de HOME são informações, não impedimentos. Responde em ~2 s mesmo com
serviço morto (as sondas correm em paralelo), que é justamente quando ela mais
importa.

### Tela de necessidades — primeira aba de :8051

A lista do que precisa de alguém agora, em ordem de **impacto**:

| # | O quê | Por quê aqui |
|---|---|---|
| 1 | trava do Triple Check | bloqueia a produção **agora** — o loop é único |
| 2 | fila no teto | a planta já está recusando ordens com 429 |
| 3 | alarmes abertos, agrupados por fonte | já falhou, ninguém fechou |
| 4 | componentes acima do limiar | vai falhar, ainda não falhou |
| 5 | dispensers com resíduo parado | estoque imobilizado |
| 6 | OS em erro nas últimas horas | já acabou — é diagnóstico |

Cada linha tem um botão que leva à aba onde se resolve. Os limiares (65 °C, 80%
de desgaste) são os mesmos com que as outras abas já pintam de vermelho. Com o
banco fora, a tela **avisa que a lista está incompleta** em vez de dizer que está
tudo em dia.

---

## Roteiro de demonstração

**1. Está vivo?**

```bash
curl http://localhost:8000/ping
curl http://localhost:8000/estado        # cnc, 8 dispensers, visão, peso, trava
curl http://localhost:8000/api/v1/fila   # {"tamanho":0,"capacidade":5,...}
```

**2. Uma OS de ponta a ponta.** O ERP posta sozinho a cada 90 s. Para não
esperar, abra o `/console`, escolha uma das 10 e dispare, com o dashboard aberto
em outra aba. Por curl:

```bash
curl -X POST http://localhost:8000/api/v1/ordens \
  -H "Content-Type: application/json" \
  -d '{"os_id":"OS-TESTE-001","descricao":"Teste manual","categoria":"snc",
       "medicamentos":[{"medicamento":"ALOIS 10MG","sku":"ALOIS 10MG CX C/7 CP","categoria":"snc","quantidade":5}]}'
```

Contrato: `200` aceita · `409` `os_duplicada` · `429` `fila_cheia` · `503`
`persistencia_indisponivel`.

```bash
docker compose logs -f central-computer | grep ORCH
curl http://localhost:8000/os/OS-TESTE-001
```

**3. A trava do Triple Check.** É o comportamento mais importante de mostrar.
Arme a falha no console (não espere o sorteio) e acompanhe:

```bash
curl http://localhost:8000/api/v1/trava     # {"ativa":true,"os_id":...,"motivo":...}
```

Liberar, pelos dois portões — o botão do console (com confirmação) ou o JWT:

```bash
TOKEN=$(curl -s -X POST http://localhost:8000/auth/login \
  -H "Content-Type: application/json" \
  -d '{"username":"admin","senha":"<SEED_ADMIN_SENHA>"}' \
  | python -c "import sys,json;print(json.load(sys.stdin)['token'])")

curl -X POST http://localhost:8000/api/v1/admin/liberar-trava \
  -H "Authorization: Bearer $TOKEN"
```

A OS retoma de onde parou. A role que libera é `admin` **ou** `supervisor`
(lida do banco a cada requisição, nunca do token); a gestão de usuários
continua só `admin`. Quando a chamada vem por uma conta de serviço — o painel
de bancada e o display de 7" autenticam o supervisor por PIN e falam com o
central com a conta deles —, o corpo opcional `{"em_nome_de": "<nome>"}` faz o
`liberado_por` gravado virar `"<conta> (em nome de <nome>)"`, e a liberação
entra em `log_manutencao` com esse nome. Sem o campo, grava só o username.

---

## Testes

Não precisam de Docker, MySQL, uvicorn nem porta serial: importam os módulos por
caminho e substituem as bordas.

```bash
python -m pip install -r tests/requirements-dev.txt
python -m pytest tests/ -q
```

O `tests/` é parte do comando, não detalhe: o repositório não tem `pytest.ini`,
e `pytest` sem argumento também coleta os testes próprios das estações de visão
(`vision/visao/tests/`), que importam `cv2` e `qrcode` — fora de
`tests/requirements-dev.txt` e fora desta suíte.

Vale conhecer os que vigiam invariantes em vez de comportamento — são eles que
pegam a regressão que nenhum outro pega:

| Teste | O que ele impede |
|---|---|
| `test_schema.py` | query referenciando tabela/coluna que o DDL não tem (varre por AST) |
| `test_db_pool.py` | função de banco voltando a abrir conexão fora do pool |
| `test_compose.py` | healthcheck removido, ciclo de dependência, porta duplicada, `devices:` ativo |
| `test_orchestrator.py` | banco chamado no event loop; serpentina pior que a permutação ótima |
| `test_adapters.py` | os quatro `_post_central` divergindo na política de retry |
| `test_serial_link.py` | serial bloqueando o event loop; as 3 cópias de `serial_link.py` divergindo |
| `test_protocolo_serial.py` | contrato do display divergindo entre C++, backend e simulador |
| `test_protocolo_placas.py` | contrato serial divergindo entre `docs/`, adapters e placas falsas |
| `test_balanca_serial.py` | firmware da balança divergindo do adapter (lê o `.ino` por texto; validado por mutação) |
| `test_dispenser_firmware.py` | as 2 cópias de `apsen_serial.h` divergindo; evento de bancada vazando para o central |
| `test_seguranca.py` | rota conferindo JWT sem revalidar no banco |
| `test_limites.py` | `?limite=` cru indo para o `LIMIT` do MySQL |

---

## Painel de bancada

`painel_operador/` — a tela de 7" com touch que o **operador de chão de fábrica**
usa, ao lado da célula, mais uma interface web. Lista as ordens, mostra o estoque
de cada dispenser, autentica por PIN, registra histórico e abre desvios.

**O espelho é de mão única.** O painel **lê** do central (`/os/historico`,
`/os/{os_id}`, `/dispensers/estado`, sem autenticação) e **não comanda** a
célula. O caminho de escrita óbvio seria `PUT /ordens/{os_id}/status`, e ele é
exatamente o errado: só grava a coluna do banco, sem falar com o orquestrador —
um botão "Iniciar" ali mudaria a linha enquanto a célula faz outra coisa. Um
espelho que escreve é um espelho que mente.

**A única exceção é liberar a trava do Triple Check**, feita por um Supervisor
autenticado por PIN (na web ou no display de 7"). Ela é deliberada, mora
sozinha em `backend/central_comandos.py` — nada mais nesse arquivo escreve no
central — e sai por uma conta de serviço própria
(`PAINEL_CENTRAL_USER`/`PAINEL_CENTRAL_SENHA`), nunca pelo login do operador.
Sem essas duas variáveis, só essa liberação fica desligada; o resto do painel
sobe normalmente.

Ele roda **fora do Docker**, porque é dono de uma porta USB, e
`PAINEL_CENTRAL=0` desliga a integração inteira: a bancada precisa funcionar com
o central desligado — em feira, em treinamento e no dia em que o Docker não sobe.

```bash
cd painel_operador/backend
python app.py          # :5000
```

Instalação, gravação do display ESP32-S3, protocolo serial, PIN, banco SQLite e
as armadilhas conhecidas estão em **[`docs/BANCADA.md`](docs/BANCADA.md)**.

---

## Interfaces e segredos

| Interface | URL | Acesso |
|---|---|---|
| Dashboard | http://localhost:8050 | público |
| Manutenção e operação | http://localhost:8051 | JWT |
| Console de operação | http://localhost:8000/console | `CONSOLE_SENHA` |
| Pré-voo | http://localhost:8000/console/prevoo | `CONSOLE_SENHA` |
| API + Swagger | http://localhost:8000/docs | REST/WS |
| Painel de bancada | http://localhost:5000 | PIN (hash) |
| API do painel | http://localhost:5000/api/* | `X-API-Token` |

**Usuários seed do app de manutenção:** `admin` (`SEED_ADMIN_SENHA`) e `manut1`
(`SEED_MANUT_SENHA`). Criados só na primeira inicialização do banco. **Troque as
duas após o primeiro login**, pela aba Usuários — elas ficam em claro no `.env`.

### Segredos

Nada de segredo entra no repositório. O compose lê tudo do `.env` (ignorado pelo
git) e **falha ao subir** se faltar algo.

| Variável | Para quê |
|---|---|
| `SECRET_KEY` | assina os JWT. 64 hex |
| `MYSQL_ROOT_PASS`, `MYSQL_PASS` | banco (lidas na criação do volume) |
| `SEED_ADMIN_SENHA`, `SEED_MANUT_SENHA` | senhas iniciais do app de manutenção |
| `APSEN_ENV` | `prod` (default) recusa segredo fraco; `dev` só avisa |
| `CONSOLE_SENHA` | console de operação. **Opcional** — vazia = console desabilitado (503) |
| `APSEN_SECRET` | sessão do painel de bancada. **Sem default** — sem ela o painel não sobe |
| `APSEN_API_TOKEN` | header `X-API-Token` das rotas `/api/*` do painel. **Sem default** — ausente, elas respondem 503 e o resto do painel sobe |

O central **se recusa a subir** com `SECRET_KEY` default, vazia ou com menos de
32 caracteres, a não ser com `APSEN_ENV=dev`. O valor default antigo está no
histórico público deste repositório: com ele qualquer pessoa forja um token
`role=admin` e libera a trava do Triple Check.

---

## Endpoints

```
GET  /ping                               health check (é o que o compose usa)
GET  /health                             diagnóstico: upstreams e, nos adapters,
                                         o estado da porta serial
GET  /estado                             estado completo em memória
GET  /os/ativa | /os/historico | /os/{id}
GET  /medicamentos                       catálogo (96 medicamentos)
GET  /dispensers/estado                  os 8 slots, no banco
GET  /alarmes                            alarmes ativos/resolvidos
WS   /ws                                 push de estado em tempo real

POST /api/v1/ordens                      nova OS — 409 os_duplicada
                                         | 429 fila_cheia | 503 persistencia_indisponivel
GET  /api/v1/fila                        ocupação da fila (backpressure)
GET  /api/v1/gerador                     flag de pausa do ERP
GET  /api/v1/ordens/templates            as 10 ordens + diagnóstico
GET  /api/v1/trava                       estado da trava
POST /api/v1/eventos/{dispenser|cnc|visao|peso}    eventos vindos dos adapters

POST /auth/login | GET /auth/me
POST /api/v1/admin/liberar-trava         admin/supervisor
GET  /manutencao/necessidades            lista priorizada (agregado)
GET  /manutencao/alarmes | PUT /manutencao/alarmes/{id}/resolver
POST /manutencao/dispensers/{id}/limpar
GET  /manutencao/log
GET  /api/v1/visao/historico
GET  /api/v1/relatorio/os/{os_id}?formato=csv|xlsx
```

### Contrato de entrada de uma OS

`POST /api/v1/ordens` é a única porta de entrada de ordem — o disparo manual do
console chama a mesma função. A regra é **nenhuma OS entra na fila sem linha no
banco**: a fila é o que dispensa medicamento, o banco é o que registra o que foi
dispensado, e aceitar uma sem a outra produz os dois piores resultados do
sistema.

| Status | Corpo | Quando | O gerador retenta? |
|---|---|---|---|
| `200` | `{"aceita": true, "posicao_fila": N}` | aceita e enfileirada | — |
| `409` | `{"erro": "os_duplicada", "os_id": ...}` | `os_id` já registrado (`INSERT IGNORE` não inseriu) | **não** — reenviar daria 409 para sempre, e reprocessar seria dose dobrada no leito |
| `429` | `{"erro": "fila_cheia", "os_id": ...}` | `MAX_FILA_OS` OS já esperando. **Nada é persistido** — a recusa vem ANTES do INSERT | **não** — a próxima OS já nasce com `os_id` novo |
| `503` | `{"erro": "persistencia_indisponivel", "os_id": ...}` | banco fora do ar; a OS **não** entra na fila | **não** — encheria o log enquanto o banco está fora |
| `422` | `{"erro": "os_personalizada_invalida", "problemas": [...]}` ou `{"erro": "dispenser_id_nao_permitido"}` | OS personalizada que não passa em `os_personalizada.validar`, ou `dispenser_id` num item de OS que não é personalizada. Nada é persistido | **não** — o mesmo corpo seria recusado de novo |

Os corpos seguem a forma `{"erro": ..., "os_id": ...}` e por isso são
`JSONResponse`: `HTTPException` embrulharia tudo em `detail`. A declaração
executável está no `responses=` do endpoint, em `central-computer/main.py`, e sai
no Swagger; `tests/test_api_ordens.py` prende os quatro casos.

#### OS personalizada (`template_id: "PERS"`)

Montada à mão no console: o operador escolhe **medicamento, dispenser e
quantidade** por linha. Entra pela mesma porta, na mesma fila e com o mesmo
teto; não vira modelo salvo.

```json
{
  "os_id": "PERS-20261021T143000-A1B2C3",
  "template_id": "PERS",
  "descricao": "Ordem personalizada",
  "categoria": "personalizada",
  "medicamentos": [
    {"medicamento": "ALOIS 10MG", "sku": "<do catálogo>", "categoria": "<do catálogo>",
     "quantidade": 4, "dispenser_id": 3}
  ]
}
```

- `template_id == "PERS"` é o que a marca; nenhuma ordem padrão usa esse id.
- 1 a 8 linhas (nunca mais que `NUM_SLOTS`), quantidade 1..10, nenhum dispenser
  e nenhum medicamento repetido, todo medicamento no catálogo. A conferência é
  de `receber_ordem` (`os_personalizada.validar`), antes da fila e do INSERT;
  catálogo fora é `503 catalogo_indisponivel`.
- `os_id` sai de `os_templates.novo_os_id("PERS")`; `sku`/`categoria` saem do
  catálogo no central.
- O slot é o do item (`orchestrator.atribuir_slots_fixos`); a ORDEM das paradas
  é da serpentina (`planejar_rota`). O `mover` vai com `receita: ""` — a placa
  acha a parada pelo `dispenser_alvo` e loga `-`.
- Em qualquer outra OS, item com `dispenser_id` é `422 dispenser_id_nao_permitido`:
  quem escolhe o slot é o central.

> Entre **não dispensar** e **dispensar sem rastro**, um sistema de medicação
> escolhe não dispensar. Com o banco fora, a OS dispensada não teria linha em
> `ordens`/`os_itens`: `atualizar_item_os` e `atualizar_status_ordem` não
> achariam o que atualizar e o relatório sairia vazio.

O console tem rotas próprias, **fora do Swagger** e atrás do cookie de sessão:

```
GET  /console | /console/login | /console/prevoo
POST /console/login | /console/logout
POST /console/api/disparar               chama o MESMO receber_ordem do POST /api/v1/ordens
POST /console/api/disparar-personalizada idem, com a OS montada linha a linha (PERS)
POST /console/api/gerador                pausa/retoma o ERP
POST /console/api/liberar-trava
GET  /console/api/injecao                tipos + gatilho armado
POST /console/api/injecao | /console/api/injecao/desarmar
POST /console/api/reset                  409 com OS em execução
POST /console/api/seed                   histórico de DEMONSTRAÇÃO
GET  /console/api/prevoo                 o relatório item a item
```

---

## Estrutura do repositório

```
valoryapsen/
├── README.md               # este arquivo
├── CLAUDE.md               # decisões de arquitetura e armadilhas
├── docs/
│   ├── PROTOCOLO_SERIAL.md # contrato adapter ↔ firmware (uma linha JSON por mensagem)
│   ├── BANCADA.md          # painel de bancada + display ESP32
│   └── DEPLOY_WINDOWS.md   # o mini PC da célula: o que roda onde, COM por placa, boot
├── central-computer/
│   ├── main.py             # FastAPI, handlers de evento, rotas do console
│   ├── orchestrator.py     # fila, atribuição de slots, rota, Triple Check, trava
│   ├── database.py         # MySQL — DDL, pool, seeds (fonte única do schema)
│   ├── os_templates.py     # as 10 ordens padrão
│   ├── os_personalizada.py # a OS montada no console: validação e corpo (puro)
│   ├── console.py          # senha, sessão HMAC, flag de pausa
│   ├── injecao.py          # gatilho de falha (um por vez, check-and-pop)
│   ├── necessidades.py     # a lista priorizada (pura)
│   ├── prevoo.py           # o relatório de pré-voo (puro)
│   ├── seed_demo.py        # histórico fabricado (puro)
│   ├── config.py  auth.py  console*.html
├── dispenser-adapter/      # :8100 — main.py + serial_link.py
├── cnc-adapter/            # :8101 — main.py + serial_link.py
├── weight-adapter/         # :8103 — main.py + serial_link.py
├── vision-adapter/         # :8102 — só HTTP; ponte com as estações reais + etiquetas.json
├── vision/                 # as estações de visão reais (código de fora, não editado aqui)
├── dispenser_simulator/    # :8201 — os 8 dispensers
├── cnc_simulator/          # :8200 — a mesa
├── vision-simulator/       # :8202 — as 3 câmeras
├── weight-simulator/       # :8203 — o HX711
├── erp-simulator/          # o ERP que emite as OS (sem porta)
├── dashboard/              # Dash read-only :8050
├── manut_web/              # Dash manutenção e operação :8051
├── dispenser/              # FIRMWARE — mecanismos + telas TFT (2 placas)
├── cnc/                    # FIRMWARE — mesa CoreXY, receitas na NVS
├── weight/                 # FIRMWARE — balança 4 × HX711
├── painel_operador/        # FORA do Docker — backend Flask + firmware do display
├── mysql/init.sql          # só charset/collation; o schema vem do database.py
├── tests/                  # pytest — sem Docker, sem MySQL, sem porta física
│   └── fakes/              # placas falsas: o firmware, por socket://
├── docker-compose.yml  Makefile  .gitignore
```

**O schema tem uma fonte só, e é o `database.py`.** O `init.sql` roda uma vez na
criação do volume; o `init_db()` roda em todo startup. Objeto que existisse só no
`init.sql` sumiria num `down` sem `-v` — e o código seguiria consultando o que
não existe.

---

## Variáveis de ambiente

> `MODO_APRESENTACAO` e `FATOR_VELOCIDADE` **mandam por cima**: com o modo
> ligado, toda probabilidade desta tabela vale zero, inclusive os overrides
> `_ESQ`/`_DIR` e o `RUIDO_G`.

### Central e simuladores (`.env` + `docker-compose.yml`)

| Variável | Padrão | Serviço |
|---|---|---|
| `MODO_APRESENTACAO` | `0` — `1` zera TODA falha aleatória | central + 4 simuladores |
| `FATOR_VELOCIDADE` | `1.0` (faixa 0.1–10) | central + 4 simuladores |
| `NUM_SLOTS` | `8` (par, 2 fileiras) | todos |
| `SECRET_KEY` / `APSEN_ENV` | obrigatória / `prod` | central |
| `CORS_ORIGINS` | `http://localhost:8050,http://localhost:8051` | central |
| `AUTH_CACHE_TTL_S` | `30` s de cache da revalidação de token | central |
| `MYSQL_POOL_MAX` | `8` conexões guardadas (1–64) | central |
| `CONSOLE_SENHA` / `CONSOLE_SESSAO_HORAS` | vazia (desabilita) / `8` h | central |
| `TRIPLE_CHECK_MIN_DIVERGENCIAS` | `1` (1–3) | central |
| `VISAO_SKU_HABILITADA` | `1` — `0` não manda o comando de SKU; os slots seguem sem conferência de produto | central |
| `VISAO_TRIPLE_CHECK_PADRAO` | `1` — estado de boot do switch "Visão no Triple Check" do console; `0` nasce com a visão informativa (não trava). Não é persistido: todo restart volta a este valor | central |
| `VISAO_MESA_POSICOES` | `1,2,3,4,5,6,7,8` — slots em que a câmera da mesa vê a caixa inteira; fora deles não há foto e o slot é conferido junto com o próximo visível. `HOME` na lista registra que ela vê a caixa inteira no HOME (premissa da conferência da caixa) | central |
| `VISAO_CAIXA_VAZIA` | `1` — confere a caixa de coleta no HOME: vazia antes da OS, cheia (contagem absoluta) depois; `0` pula as duas fotos | central |
| `VISAO_CAIXA_VAZIA_REPETIR_S` | `10` s entre as re-fotos enquanto a caixa não esvazia (vírgula aceita) | central |
| `TIMEOUT_CNC_CENTRO` | `30` s esperando a mesa chegar ao centro; a OS só conclui com ela lá | central |
| `VISION_SIM_URL` | `http://vision-simulator:8202` — na célula, a estação da mesa: `http://host.docker.internal:8212` | vision-adapter |
| `VISAO_MESA_FONTE` / `VISAO_DISPENSER_FONTE` | `simulador` — `estacao` = câmera real (descarta a telemetria simulada dela; nos dispensers, liga a ponte com as estações) | vision-adapter |
| `VISAO_DISP_ESQ_URL` / `_DIR_URL` | `http://host.docker.internal:8301` / `:8302` | vision-adapter |
| `VISAO_DISP_INTERVALO_CATALOGO_S` | `2` s — TEM de ser igual ao `backend.intervalo_catalogo` das estações | vision-adapter |
| `VISAO_DISP_ASSENTAMENTO_S` / `VISAO_DISP_PRAZO_S` | `2` s de folga depois do catálogo novo valer / `20` s de teto para emitir a leitura | vision-adapter |
| `VISAO_ETIQUETAS_ARQ` | `/app/etiquetas.json` — nome do central → QR/ArUco impressos | vision-adapter |
| `MAX_FILA_OS` | `5` OS esperando | central |
| `PORTA_NR12_HABILITADA` | `0` — `1` diz que a célula TEM porta NR-12: o central nasce parado até o estado dela ser provado (ritual: tag → 10 s → tag) | central |
| `PORTA_PARADA_MAX_S` | `3` (faixa 0,5–4) — quanto se espera a CNC e os dispensers confirmarem a parada (em campo a porta já autorizou sozinha: sem confirmação, é alarme) | central |
| `PORTA_JANELA_LIBERACAO_MS` | `10000` — janela do `porta_liberar` do firmware JSON (`porta_nr12`); em campo a janela é a gravada na porta (10 s) | central |
| `PORTA_SILENCIO_MAX_S` | `15` — nada da porta por esse tempo = link perdido (a célula para) | central |
| `PORTA_TIMEOUT_HOMING_S` | `90` — teto do homing da retomada | central |
| `PORTA_ADAPTER_URL` | `http://porta-adapter:8104` — na célula real, `http://host.docker.internal:8104` (o adapter roda no host) | central |
| `PORTA_SERIAL_URL` | **obrigatória** — a COM do ESP RECEPTOR da porta (só leitura); vazia, o serviço recusa subir | porta-adapter |
| `PORTA_SERIAL_BAUD` | `115200` | porta-adapter |
| `PORTA_ESTADO_REENVIO_S` | `5` — com o link ok, o `estado` sintetizado é reenviado ao central nesse intervalo (a porta não tem heartbeat) | porta-adapter |
| `PORTA_ESPERA_SENSORES_S` | `0.3` — quanto o `porta_aberta` espera a linha dos fins de curso que diz QUAL porta abriu | porta-adapter |
| `TIMEOUT_CARREGAMENTO` / `_POSICIONAMENTO` / `_DISPENSA` | `180` / `120` / `120` s | central |
| `TIMEOUT_VISAO_DISPENSER` / `_VISAO_MESA` / `_PESO` | `30` / `30` / `15` s | central |
| `BROADCAST_MIN_INTERVALO_MS` | `500` ms entre broadcasts periódicos | central |
| `CNC_AMOSTRAGEM_MOVENDO` | `0` (não grava trajetória; N = 1 em N) | central |
| `RETENCAO_DIAS` / `EXPURGO_INTERVALO_HORAS` | `30` d / `24` h | central |
| `<SUB>_TRANSPORTE` | `http` (`serial` = firmware) | dispenser/cnc/weight-adapter |
| `<SUB>_SERIAL_URL` / `_BAUD` / `_ACK_TIMEOUT_S` | vazia / `115200` / `2` s | dispenser/cnc/weight-adapter |
| `T_CARGA_UNID` / `T_DISPENSA_UNID` | `0.3` / `0.5` s por unidade | dispenser-sim |
| `PROB_ERRO_MECANICO` | `0.01` | dispenser-sim |
| `PROB_FALHA_LEITURA_DISPENSER` / `PROB_DIVERGENCIA_DISPENSER` | `0.02` — as duas fileiras | vision-sim |
| `T_SCAN_DISPENSER` | `1.5` s — as duas fileiras | vision-sim |
| `..._ESQ` / `..._DIR` | herdam o valor acima; sobrescrevem UMA câmera | vision-sim |
| `PROB_FALHA_LEITURA_MESA` / `PROB_DIVERGENCIA_MESA` / `T_SCAN_MESA` | `0.02` / `0.02` / `2.0` s | vision-sim |
| `TOLERANCIA_PERC` | `5.0` % | weight-sim |
| `PROB_ERRO_SENSOR` / `T_LEITURA` / `T_TARA` / `RUIDO_G` | `0.01` / `1.5` s / `0.5` s / `2.0` g | weight-sim |
| `VEL_MM_S` / `HOME_X` / `HOME_Y` | `80` mm/s / `-120` / `0` | cnc-sim |
| `INTERVALO_OS` | `90` s entre OS | erp-simulator |
| `ESPERA_FILA_CHEIA` / `MAX_ESPERAS_FILA` | `20` s / `15` esperas | erp-simulator |
| `RELOAD_CATALOGO_MIN` / `ESPERA_PAUSA` | `30` min / `10` s | erp-simulator |

### Painel de bancada (fora do Docker)

| Variável | Padrão | Para quê |
|---|---|---|
| `CENTRAL_URL` | `http://localhost:8000` | onde o central atende (a porta **publicada** — não o nome DNS do Docker) |
| `CENTRAL_TIMEOUT_S` / `CENTRAL_SYNC_S` | `3` / `5` s | teto de cada requisição / intervalo do espelho |
| `PAINEL_CENTRAL` | `1` | `0` desliga a integração inteira |
| `APSEN_DB` | `backend/apsen.db` | caminho do banco |
| `APSEN_SECRET` | **sem default** | chave de sessão; ausente ou fraca, o painel não sobe |
| `APSEN_API_TOKEN` | **sem default** | token das rotas `/api/*`; ausente, elas respondem 503 |
| `PAINEL_CENTRAL_USER` / `PAINEL_CENTRAL_SENHA` | **sem default** | conta de serviço (role `supervisor` no central) com que o painel libera a trava do Triple Check; ausentes, só a liberação fica desligada — ver `central_comandos.py` |
| `APSEN_DISPLAY_PORTA` | vazia (varre) | a COM do display de 7", **obrigatória na célula montada** — definida, abre só ela e não varre; ver [Portas seriais na célula montada](#portas-seriais-na-célula-montada) |
| `APSEN_DEBUG` | `0` | `1` liga o Werkzeug e **força o bind em 127.0.0.1** |
| `APSEN_HOST` / `APSEN_PORTA` | `0.0.0.0` / `5000` | |
| `APSEN_RELOADER` | `0` | deixe desligado com o display conectado |

---

## Concorrência e segurança

**Event loop nunca bloqueado.** Todo I/O de MySQL passa por `asyncio.to_thread`,
e o serial dos adapters roda numa thread leitora dedicada por porta — as duas
regras têm varredura por AST na suíte. Snapshot de estado é `copy.deepcopy` sob
o lock: a cópia rasa deixava os dicionários aninhados vivos durante a
serialização, fora do lock.

**Autenticação.** JWT + bcrypt, com **revalidação no banco a cada requisição**
(cache de `AUTH_CACHE_TTL_S`): o token não é a palavra final, usuário desativado
perde acesso na hora e a `role` que vale é a do banco. `SECRET_KEY` default
impede o boot. CORS é lista explícita, não `*`. `?limite=` passa por clamp antes
do `LIMIT`.

**Console e painel.** O console tem senha própria e sessão HMAC `HttpOnly`, e
fica inteiro desabilitado sem `CONSOLE_SENHA` — sem senha default embutida. No
painel de bancada, `APSEN_SECRET` sem default (o processo recusa subir), rotas
`/api/*` atrás de `X-API-Token`, PIN de operador em hash e conferido pelo
backend (o display não guarda credencial, nem no cartão SD), e `debug` só com
`APSEN_DEBUG=1` — e aí escutando apenas em `127.0.0.1`.

**Infra.** Healthcheck em todos os serviços de aplicação, `depends_on` por
`condition: service_healthy` (ordem de start não é prontidão), pool de conexões
MySQL com verificação de conexão ociosa, e retry com o **mesmo critério** nos
dois sentidos da ponte: retenta 5xx, 408 e 429; recusa determinística (409, 422)
não é retentada.

**Segurança operacional.** Triple Check com trava garante intervenção humana em
qualquer divergência; toda saída do ciclo de uma OS fecha em status terminal e
devolve os slots ao pool; OS não entra na fila sem linha no banco (entre não
dispensar e dispensar sem rastro, um sistema de medicação escolhe não
dispensar).
