jdszza/valoryapsen/docs/DEPLOY_WINDOWS.md

# Deploy no mini PC Windows da célula

> Como a célula montada sobe no mini PC HP com Windows: o que roda em container,
> o que roda no host, qual COM é de quem, as variáveis de cada processo, como
> subir no boot e as armadilhas que já custaram horas. O contrato de cada porta
> está em [PROTOCOLO_SERIAL.md](PROTOCOLO_SERIAL.md); o painel de bancada, em
> [BANCADA.md](BANCADA.md); o resumo e o porquê, no README, seção
> "Portas seriais na célula montada".

> **Antes de ligar as seis placas pela primeira vez: no mini PC, toda placa
> tem que ter o número da COM fixado no Windows e a variável de porta
> preenchida. A varredura automática é só para desenvolvimento sem hardware.**
> O porquê está na seção [Por que a porta fixa é obrigatória](#por-que-a-porta-fixa-é-obrigatória).

## O desenho

```
mini PC HP (Windows) ─┬─ COM_A  dispenser      (os 8 mecanismos)     ┐
                      ├─ COM_B  dispenser_tft  (as 8 telas TFT)      │ dispenser-adapter  (host)
                      ├─ COM_C  cnc            (a mesa)                 cnc-adapter        (host)
                      ├─ COM_D  weight         (a balança HX711)        weight-adapter     (host)
                      ├─ COM_E  display de 7"  (a bancada)              painel_operador    (host)
                      └─ COM_F  receptor da porta NR-12 (só leitura)    porta-adapter      (host) :8104

câmeras (USB) ─┬─ webcam da mesa          estação da mesa          (host) :8212
               ├─ webcam fileira esq.    estação dispensers esq   (host) :8301
               └─ webcam fileira dir.    estação dispensers dir   (host) :8302
                  as três falam HTTP com o vision-adapter, que fica em container
alimentação: fonte externa. O USB do mini PC carrega SÓ dados.
```

Seis portas, cada uma com o seu dono — o dispenser-adapter é dono de duas, e
cada um dos outros, de uma. Nenhum processo varre. A porta NR-12 tem USB
PRÓPRIA (COM_F) e não passa pela placa das telas: travar ou regravar as telas
não cega a vigia da porta, e vice-versa. Em campo, desde 22/10/2026, **COM_F é a
USB do ESP RECEPTOR**, que repassa as linhas de texto da ESP da porta; o
porta-adapter só lê (`PROTOCOLO_SERIAL.md` §10).

## O que roda onde

O Docker Desktop do Windows **não repassa porta COM para container**. Quem
precisa de uma COM roda fora do Docker — é a mesma decisão que o painel de
bancada já tinha, pelo mesmo motivo (BANCADA.md: *"Ele é dono de uma porta
serial USB, e um container Linux não enxerga a COM do host — isso é decisão,
não pendência"*).

| Processo | Onde | Por quê |
|---|---|---|
| `mysql`, `central-computer`, `dashboard`, `manut_web`, `erp-simulator` | container | não tocam em porta nenhuma |
| `vision-adapter`, `vision-simulator` | container | a visão é HTTP; o simulador continua subindo como rollback das câmeras reais |
| estação da mesa (`vision/visao_mesa`) | **host** | dona da webcam da mesa — o Docker Desktop não repassa USB |
| estações dos dispensers, esquerda e direita (`vision/visao`, duas pastas) | **host** | donas das duas webcams das fileiras |
| `dispenser-adapter` (duas COM: mecanismos + telas TFT) | **host** | dono de COM_A e COM_B |
| `cnc-adapter` | **host** | dono de COM_C |
| `weight-adapter` | **host** | dono de COM_D |
| `porta-adapter` | **host** | dono de COM_F (o receptor da porta), só leitura. Não tem serviço no compose: não há porta simulada |
| `painel_operador` (backend + display) | **host** | dono de COM_E, como já era |

No compose isso é o **profile** `simulado`: os três adapters seriais e os quatro
simuladores estão atrás dele. Com `COMPOSE_PROFILES=simulado` no `.env` (a
máquina de desenvolvimento e a demonstração), `docker compose up` sobe a planta
simulada inteira, como sempre. **No mini PC, deixe `COMPOSE_PROFILES` fora do
`.env`** (ou vazio): sobe só o que roda em container.

```bash
docker compose up -d --build        # no mini PC: 7 serviços, os de container
```

### A alternativa preterida: ponte RFC2217

Manter tudo em container e expor cada COM como socket TCP por uma ponte RFC2217
no host (`<SUB>_SERIAL_URL=rfc2217://host.docker.internal:400x`) foi avaliado
e descartado. O custo some do código — de dentro do adapter as duas montagens
são a mesma chamada — e é por isso que precisa ficar escrito:

1. **mais um processo por porta para supervisionar** — três pontes, cada uma
   podendo morrer sozinha, e nenhuma delas é serviço do compose;
2. **latência a mais** em todo comando e todo evento, num canal que já concorre
   com telemetria;
3. **"cabo caiu" e "ponte morreu" produzem o mesmo sintoma** — os dois viram
   "socket fechado", e quem lê o log não sabe se vai olhar o cabo ou reiniciar
   um processo do host;
4. **a perda da exclusividade de abertura.** No Windows a COM é exclusiva de um
   processo — o segundo a tentar toma `ACCESS_DENIED`, que é o erro certo. Dois
   processos abrem o mesmo socket TCP sem erro nenhum, e o resultado é o que o
   item 1 do contrato serial existe para impedir: duas partes escrevendo na
   mesma linha, bytes intercalados no meio de um JSON, e o outro lado
   descartando a linha inteira em silêncio.

## A tabela de COM por placa

Preencha ao montar a célula e **fixe os números no Windows** (ver abaixo).
Sem isto, a próxima troca de porta USB renumera tudo.

| Placa | Subsistema (`sub` do ping) | COM fixada | Variável (processo do host) |
|---|---|---|---|
| mecanismos dos 8 dispensers | `dispenser` | COM_A = `COM__` | `DISPENSER_SERIAL_URL` (dispenser-adapter) |
| as 8 telas TFT | `dispenser_tft` | COM_B = `COM__` | `DISPENSER_TFT_SERIAL_URL` (dispenser-adapter) |
| mesa CNC | `cnc` | COM_C = `COM__` | `CNC_SERIAL_URL` (cnc-adapter) |
| balança HX711 | `weight` | COM_D = `COM__` | `WEIGHT_SERIAL_URL` (weight-adapter) |
| display de 7" | (ping sem `sub`) | COM_E = `COM__` | `APSEN_DISPLAY_PORTA` (painel_operador) |
| ESP RECEPTOR da porta NR-12 | (sem ping: banner `=== RECEPTOR Serial2`) | COM_F = `COM__` | `PORTA_SERIAL_URL` (porta-adapter) — **obrigatória**: vazia, o serviço não sobe |

Qual placa está em qual COM: abra **uma** porta de cada vez com o monitor
serial do PlatformIO a 115200 e leia o ping — `{"cmd":"ping","sub":"cnc"}` é
a mesa; o display manda `{"cmd":"ping"}` sem `sub`. **O receptor da porta não
tem ping**: com o porta-adapter PARADO, o Monitor Serial na COM dele mostra o
banner `=== RECEPTOR Serial2` ao resetar o receptor, e as linhas `EVT:...` da
porta ao passar uma tag (`[aviso] Nenhum byte recebido` = confira TX17→RX16 e o
GND comum). **Feche o monitor antes de subir os processos** (ver Armadilhas).

### Fixar a COM no Windows

Gerenciador de Dispositivos → *Portas (COM e LPT)* → botão direito na porta →
*Propriedades* → aba *Configurações de Porta* → *Avançado…* → *Número da Porta
COM*. Escolha um número, e o mesmo conversor USB-serial mantém o número mesmo
trocando de tomada USB (o Windows amarra o número ao par VID/PID + serial do
conversor).

Duas armadilhas conhecidas dessa tela:

- **Entradas fantasma.** O Windows deixa registradas as portas de dispositivos
  já usados (aparecem como "em uso" na lista de *Número da Porta COM*). Para
  ver e apagar: no Gerenciador de Dispositivos, *Exibir → Mostrar dispositivos
  ocultos*; ou `set devmgr_show_nonpresent_devices=1` antes de abri-lo.
- **Conversores idênticos.** Placas com o mesmo chip (CH340, CP2102) têm o
  mesmo VID/PID; é por isso que a detecção **nunca** casa por VID/PID e sim
  pelo `sub` do ping — e é por isso que o número fixado tem que ser conferido
  contra o ping uma vez, na montagem.

## Por que a porta fixa é obrigatória

Com `<SUB>_SERIAL_URL` vazia, o `serial_link._conectar` de cada adapter **varre
todas as portas** procurando a sua placa, e em cada candidata gasta
`PROBE_ASSENTAR_S` (1,5 s) + `PROBE_ESPERA_S` (8 s) = **até 9,5 s**. O painel
faz o mesmo em `find_display_port` / `_probe_port`, e o `serial_worker` repete
a varredura a cada 3 s, para sempre.

A competição não é por uma porta compartilhada — cada placa tem a sua. A
competição existe porque, **durante a busca, cada processo abre as portas dos
outros** para descobrir se a placa dele está ali. Enquanto o dispenser-adapter
segura por 9,5 s a COM da CNC só para conferir, o cnc-adapter toma
`ACCESS_DENIED` na própria porta. Com cinco processos e seis portas isso não dá
erro: dá **boot não-determinístico de dezenas de segundos**, em que uma placa
às vezes simplesmente não é achada no ciclo.

A conta: 5 processos × até 9,5 s por porta sondada × até 5 portas cada = a
janela em que qualquer um deles pode estar segurando a porta de outro. Fixar a
porta elimina a varredura, e sem varredura não há competição.

O que NÃO muda com a porta fixa: a abertura continua com **DTR/RTS desligados**
antes de abrir (nessa placa esses sinais são o circuito de reset do ESP32-S3) e
a confirmação continua sendo o **ping** — fixar o número não dispensa conferir
que há a placa certa do outro lado.

## As variáveis de cada processo do host

Os adapters no host **não leem o `.env` da raiz** — ele é do compose. Cada um
recebe o ambiente do `.bat` (ou da tarefa agendada) que o inicia.

### Comum aos adapters

| Variável | Valor no mini PC | Por quê |
|---|---|---|
| `CENTRAL_URL` | `http://localhost:8000` | a porta **publicada** do central. `central-computer:8000` é nome DNS da rede Docker e não resolve no host (a mesma armadilha do `BACKEND_URL`) |
| `<SUB>_TRANSPORTE` | `serial` | o firmware, não o simulador |
| `<SUB>_SERIAL_URL` | `COMx` (a fixada) | **obrigatória** na célula montada |
| `<SUB>_SERIAL_BAUD` | `115200` | |
| `<SUB>_ACK_TIMEOUT_S` | `2` | prazo do ACK, não da conclusão |

`<SUB>` é `DISPENSER`, `CNC` ou `WEIGHT`; o dispenser-adapter leva também
`DISPENSER_TFT_TRANSPORTE=serial` e `DISPENSER_TFT_SERIAL_URL=COM_B`. O
porta-adapter só tem transporte serial — não existe `PORTA_TRANSPORTE` — e leva
`PORTA_SERIAL_URL=COM_F` — a COM do RECEPTOR (sem default no `.bat`: vazia, ele
avisa e sai) — e `PORTA_SERIAL_BAUD=115200`. Não há ACK nem heartbeat do lado
da porta: `PORTA_ACK_TIMEOUT_S` e `PORTA_HEARTBEAT_MAX_S` saíram com o firmware
de campo.

E o **central alcança os adapters do host** por `host.docker.internal`, o nome
que o Docker Desktop dá à máquina hospedeira. No `.env` do mini PC:

```bash
DISPENSER_ADAPTER_URL=http://host.docker.internal:8100
CNC_ADAPTER_URL=http://host.docker.internal:8101
WEIGHT_ADAPTER_URL=http://host.docker.internal:8103
PORTA_ADAPTER_URL=http://host.docker.internal:8104
PORTA_NR12_HABILITADA=1
# VISION_ADAPTER_URL fica no default: o vision-adapter continua em container.
```

O `central-computer` lê essas variáveis do ambiente (`config.py`); o compose as
declara com os nomes DNS de sempre como default, e o `.env` as sobrescreve.
`PORTA_NR12_HABILITADA=1` faz o central nascer com a célula PARADA até o estado
da porta ser provado — porta que nunca falou é porta aberta. Como a porta não
tem heartbeat nem responde a pergunta, a prova é o **ritual de subida**: passe a
tag (a porta libera), espere os 10 s (ou abra e feche), passe a tag de novo
(rearme) — a célula faz homing e retoma.

### Como subir cada adapter no host

**Uma vez por adapter**, crie o ambiente:

```bat
cd C:\apsen\cnc-adapter
python -m venv .venv
.venv\Scripts\activate
pip install -r requirements.txt
```

**Depois disso, só o `.bat`.** Cada processo do host tem o seu, com a COM na
primeira linha editável — e é o único lugar onde o número da porta se escreve
(README da raiz, [Onde escrever o número da COM](../README.md#onde-escrever-o-número-da-com)):

| Processo | Arquivo | Porta HTTP |
|---|---|---|
| dispenser-adapter (2 COM) | `dispenser-adapter\iniciar_host.bat` | 8100 |
| cnc-adapter | `cnc-adapter\iniciar_host.bat` | 8101 |
| weight-adapter | `weight-adapter\iniciar_host.bat` | 8103 |
| porta-adapter | `porta-adapter\iniciar_host.bat` | 8104 |
| painel de bancada | `painel_operador\iniciar_backend.bat` | 5000 |

O `.bat` já liga o transporte serial, aponta o `CENTRAL_URL` para a porta
publicada do central e sobe o uvicorn na mesma porta HTTP que o compose
publicava: nada muda para o central, o dashboard ou o pré-voo.

> ⚠️ **O `cnc-adapter` sobe, mas a mesa ainda não obedece.** O firmware
> (`cnc/receitas_manuais`) fala só com humano — não entende JSON. Com `serial`
> e a COM fixada o adapter abre a porta e se dá por conectado (URL fixa não
> passa pela sondagem por ping), mas nenhum comando é executado e o ACK nunca
> vem: `/comandos/mover` falha no `CNC_ACK_TIMEOUT_S` e a OS aborta com a placa
> aparecendo saudável no `/health`. O próprio `.bat` avisa isso ao subir. Para
> rodar a planta agora, `set CNC_TRANSPORTE=http` antes de chamá-lo.
> Ver [`../cnc/README.md`](../cnc/README.md).

### As três estações de visão

Rodam no host pelo mesmo motivo dos adapters: são donas de um dispositivo USB.
Todas falam com o vision-adapter (container) pela porta **publicada**,
`http://127.0.0.1:8102`, e o vision-adapter fala com elas por
`host.docker.internal`.

| Processo | Arquivo | Porta HTTP |
|---|---|---|
| estação da mesa | `vision\iniciar_mesa.bat` | 8212 |
| estação dispensers esquerda (D1–D4) | `vision\iniciar_dispensers.bat esq` | 8301 |
| estação dispensers direita (D5–D8) | `vision\iniciar_dispensers.bat dir` | 8302 |

**Nunca `vision\iniciar_visao.bat`**: ele sobe a estação na porta 8000, que é a
do central. E a estação da mesa sobe pelo `vision\iniciar_mesa.bat`, não pelo
`iniciar_estacao.bat` que veio dentro dela (que continua lá, intocado): o novo
roda `vision\conferir_mesa.py` antes de subir e reergue a estação se ela cair.

**Estação da mesa — o venv.** O `vision\visao_mesa\.venv` precisa dos DOIS
requirements — o da visão (opencv-contrib, numpy) e o da integração (fastapi,
uvicorn, requests). Sem o segundo, `python -m integracao_apsen.servidor` morre
no import:

```bash
cd vision\visao_mesa
python -m venv .venv
.venv\Scripts\activate
pip install -r requirements.txt -r integracao_apsen\requirements.txt
```

Venv criado em OUTRA máquina não serve: ele aponta para o Python de lá. O
`conferir_mesa.py` diz isso com a causa; apague a pasta e recrie.

**Estação da mesa — `vision\visao_mesa\integracao_apsen\.env`** (não versionado;
o `conferir_mesa.py` reprova se faltar ou se algum valor abaixo estiver
diferente):

```bash
ADAPTER_URL=http://127.0.0.1:8102
# 8212, e não a 8202 do default: a 8202 é publicada pelo vision-simulator, que
# continua no ar como rollback.
PORTA=8212
HOST=0.0.0.0
# Espera depois de o comando chegar, para a mesa parar de balançar. Comece com
# 1.0 e suba se os eventos vierem com falha "fora de foco" (ver o procedimento
# de bancada M3 em docs/BANCADA_VISAO.md).
T_ASSENTAMENTO_S=1.0
FRAMES_POR_CAPTURA=5
# SEMPRE 0. Ligado, a estação devolveria uma contagem SEM medir nem registrar o
# total, e a foto do slot seguinte veria os dois slots juntos — a trava cairia no
# slot errado. Com a câmera real, quem injeta a falha da demonstração é o
# vision-adapter, reescrevendo o evento verdadeiro.
ACEITAR_INJECAO=0
# O acumulado da OS vive só na memória da estação e expira neste prazo desde a
# última foto. Com o default (2 h), uma trava esperando supervisor no almoço
# apaga a conta, e a foto seguinte compararia a caixa INTEIRA com um slot.
VALIDADE_OS_H=24
```

**Estações dos dispensers.** `iniciar_dispensers.bat <esq|dir>` cria, na
primeira vez, `vision\visao_esq\` ou `vision\visao_dir\` como cópia de
`vision\visao\`; a cada execução espelha só o código (`src\`), sem tocar na
calibração (`config\`) nem no banco de eventos (`dados\`). O Python é o do
`vision\visao\.venv`, criado uma vez. Antes de operar, em cada pasta:
`python src\camera.py`, `python src\calibrar.py` com as zonas numeradas pelo
slot REAL (direita: 5 a 8), e conferir em `config\parametros.json`:
`backend.ativo=true`, `backend.intervalo_catalogo=2` e o `backend.url` **do
lado** — `http://127.0.0.1:8102/estacoes/esq` numa pasta,
`http://127.0.0.1:8102/estacoes/dir` na outra. A estação monta a URL como
`{backend.url}/api/visao/catalogo`, e é pela rota do lado que o vision-adapter
PROVA que aquela estação buscou o catálogo da OS corrente (o relógio sozinho só
supõe). O intervalo tem de ser igual ao `VISAO_DISP_INTERVALO_CATALOGO_S` do
vision-adapter.

O `.bat` roda `vision\conferir_dispensers.py <lado>` antes de subir e para, em
vermelho, se as zonas não foram calibradas nesta bancada (idênticas às do
modelo, ou numeradas fora do lado), se ninguém escolheu a câmera, se a câmera é
a mesma de outra estação ou se o `backend` está diferente do acima. A câmera é
a que o `camera.py` gravou, **por nome**: `CAMERA_ESQ`/`CAMERA_DIR` no `.bat`
ficam vazios, e preenchê-los é escape manual — um número ali vai direto para o
índice, e índice de webcam USB muda com a ordem de enumeração.

**O `.env` da raiz, na célula montada** (o do compose; não versionado):

```bash
VISION_SIM_URL=http://host.docker.internal:8212
VISAO_MESA_FONTE=estacao
VISAO_DISPENSER_FONTE=estacao
# Slots em que a câmera da mesa vê a caixa INTEIRA — medido na bancada
# (procedimento M4 em docs/BANCADA_VISAO.md). Sem a linha, todos.
VISAO_MESA_POSICOES=<medido na bancada>
```

Voltar ao simulador é tirar essas linhas: os defaults são os de antes.

### Consequências no compose

- os três adapters seriais e os quatro simuladores estão atrás do profile
  `simulado` — na célula montada, **não sobem** em container;
- o `erp-simulator` declara a dependência deles com `required: false`: com o
  profile ligado ela vale como sempre; sem o profile, o compose só avisa e sobe
  o ERP. Quem garante que os adapters do host já estão de pé quando a primeira
  OS sai é a ordem de boot do host (abaixo);
- o `/console/prevoo` continua sondando `:8100`, `:8101` e `:8103` — no host,
  agora —, e, com `PORTA_NR12_HABILITADA=1`, também o porta-adapter, no
  endereço de `PORTA_ADAPTER_URL` (`:8104`). É a tela que diz se os processos
  do host subiram;
- o `porta-adapter` não está no compose em profile nenhum: não há porta
  simulada, e ele só existe no host.

## Subir no boot

Nove processos precisam subir sozinhos, e **antes** de o compose emitir a
primeira OS. Na ordem:

1. Docker Desktop (inicia com o Windows; marque *Start Docker Desktop when you
   sign in*) e `docker compose up -d` — os containers com `restart:
   unless-stopped` voltam sozinhos;
2. os quatro adapters do host — `dispenser-adapter`, `cnc-adapter`,
   `weight-adapter` e `porta-adapter\iniciar_host.bat` (com a COM_F em
   `PORTA_SERIAL_URL`). Enquanto o porta-adapter não sobe, o central mantém a
   célula parada: link perdido é porta aberta — subi-lo depois do Docker é a
   ordem natural, e nenhuma OS começa antes do `porta_link_ok`. Com o
   adapter no ar, o estado da porta ainda é DESCONHECIDO: faça o ritual de
   subida (tag → 10 s → tag) para a célula fazer homing e liberar;
3. o painel de bancada (`painel_operador\iniciar_backend.bat`);
4. as três estações de visão (`vision\iniciar_mesa.bat`,
   `vision\iniciar_dispensers.bat esq` e `vision\iniciar_dispensers.bat dir`).
   Depois do Docker: as dos dispensers buscam o catálogo no vision-adapter, e
   sem ele sobem com o catálogo local de reserva até a primeira busca dar certo.
   O vision-adapter não espera por elas para servir: o `lifespan` só loga a
   espera, em segundo plano.

**As três estações se reerguem sozinhas.** Os dois `.bat` da visão rodam a
estação num laço: se ela sair — falha de câmera, ESC na janela, qualquer
código —, a linha vai para o log de reinícios e ela sobe de novo em 5 s:

| estação | log de reinícios |
|---|---|
| mesa | `vision\visao_mesa\dados\reinicios.log` |
| dispensers esq / dir | `vision\visao_<lado>\logs\reinicios.log` |

Reiniciar a estação da mesa com OS rodando custa uma conferência, não uma trava:
o vision-adapter nota que ela perdeu o acumulado da OS e marca a foto seguinte
como `ressincronizar`. Para encerrar uma estação de vez: Ctrl+C na janela e
responda S.

Use o **Agendador de Tarefas** (uma tarefa por processo, gatilho *Ao iniciar a
sessão*, *Executar somente quando o usuário estiver conectado*, com o `.bat` de
cada um e o diretório de trabalho certo), ou um único `.bat` na pasta *Inicializar*
que chame os cinco em janelas separadas (`start "cnc-adapter" cmd /k ...`).
Janela separada é melhor que serviço do Windows aqui: o log de cada porta fica
visível, e "fechou a janela" é um sintoma que qualquer um da bancada lê.

`restart: unless-stopped` não existe para processo do host: um adapter que morra
**não volta sozinho** (as estações de visão voltam — o laço do `.bat` é o
supervisor delas). Enquanto não houver supervisor de processo, o sintoma no
pré-voo é `:810x` vermelho — e o `.bat` com `cmd /k` deixa o traceback na tela.

## Firewall: o container alcançando o host

O central e o vision-adapter, em container, alcançam os processos do host por
`host.docker.internal`, e para o Windows isso é tráfego de **entrada** nas
portas do host. Nenhuma regra estava documentada para os adapters
(`:8100`, `:8101`, `:8103`, `:8104`), então a mesma regra cobre as estações
(`:8212`, `:8301`, `:8302`). Como Administrador:

```bat
netsh advfirewall firewall add rule name="APSEN adapters e estacoes" dir=in action=allow protocol=TCP localport=8100,8101,8103,8104,8212,8301,8302 profile=private
```

Teste de dentro do container (um por porta — troque `8212` por `8301`/`8302`):

```bash
docker compose exec vision-adapter python -c "import urllib.request;print(urllib.request.urlopen('http://host.docker.internal:8212/ping',timeout=3).read())"
```

As estações dos dispensers não têm `/ping`: para elas o caminho é
`/api/saude`. Se o teste der timeout com a regra criada, confira o perfil da
interface `vEthernet (WSL)` em *Configurações → Rede*: o Windows às vezes a
classifica como **pública**, e a regra acima vale só para o perfil privado.

## Armadilhas conhecidas

**Só um processo pode abrir a porta — e agora são seis portas.** O Serial
Monitor do PlatformIO (ou do Arduino IDE, ou um `simulador_serial.py`
esquecido) aberto em qualquer uma delas derruba quem deveria estar com ela, e o
sintoma é só "desconectado" no `/health` do adapter (ou `OFFLINE` no display).
Feche todos antes de subir os processos; para regravar um firmware, derrube o
processo dono daquela COM primeiro.

**Cadastrar tag da porta é na USB DA PORTA, com notebook.** Em campo a COM_F é
a do ESP RECEPTOR, e o cadastro (`R`/`S`/`C`/`L`) é feito pelo Monitor Serial
na USB da ESP da PORTA, na bancada — o mini PC e o porta-adapter não
participam (`porta/README.md`). (Com o firmware anterior, `porta_nr12`, os
comandos iam pela mesma USB que o adapter usava, e cadastrar exigia pará-lo.)

**A porta parada travada é um ponto cego.** A ESP da porta não tem linha de
vida: travada, ou com o fio TX2→RX2 rompido, ela fica tão muda quanto uma porta
fechada que ninguém tocou, e nada avisa. Antes de começar, um teste de tag
confirma que o caminho está vivo.

**`ACCESS_DENIED` numa porta que "está livre".** Quase sempre é processo
duplicado: fechar a janela nem sempre mata o Python. `tasklist | findstr python`
antes de procurar bug.

**O número da COM mudou sozinho.** Ou a porta não foi fixada, ou a placa foi
ligada por outro conversor. Confira o ping com o monitor serial e fixe de novo.

**`CENTRAL_URL=http://central-computer:8000` no host.** Não resolve: é nome da
rede Docker. No host é `http://localhost:8000`. O mesmo vale ao contrário: o
central em container só alcança o host por `host.docker.internal`.

**`APSEN_RELOADER=1` com hardware.** O reloader do Flask roda dois processos, e
os dois disputam COM_E. Nunca na bancada.

**`COMPOSE_PROFILES=simulado` no `.env` do mini PC.** Sobe os simuladores e os
adapters em container por cima dos do host: o central passa a mandar comando
para `dispenser-adapter:8100` (o container, que fala com o simulador) e a
célula física fica parada com tudo "verde" no dashboard. No mini PC a variável
fica de fora.
