jdszza/valoryapsen/docs/PROTOCOLO_SERIAL.md

# Protocolo serial APSEN — adapters ↔ firmware

Este arquivo é o CONTRATO que os três firmwares vão implementar, e é contra ele
que `tests/test_protocolo_placas.py` compara o código Python dos dois lados (os
adapters e as placas falsas de `tests/fakes/`). Firmware que discorde daqui não
falha com erro: ele fica mudo, e o sintoma chega como OS abortada por timeout
num slot que o operador vai procurar na bancada.

Uma porta por firmware, uma linha JSON por mensagem:

| adapter | firmware | porta | subsistema (`sub`) | código |
|---|---|---|---|---|
| `dispenser-adapter` | os 8 dispensers (mecanismos)| uma | `dispenser` | [`dispenser/servos_hub/`](../dispenser/README.md) |
| `dispenser-adapter` | as 8 telas TFT | uma (a SEGUNDA porta do mesmo adapter) | `dispenser_tft` | [`dispenser/telas_tft/`](../dispenser/README.md) |
| `cnc-adapter` | a mesa CNC | uma | `cnc` | — |
| `weight-adapter` | a balança HX711 | uma | `weight` | [`weight/balanca2_3/`](../weight/README.md) |
| `porta-adapter` | a porta NR-12 (RC522 + fins de curso; porta presa por ímã) | uma — USB do ESP RECEPTOR, só leitura (seção 10) | — (texto, não JSON) | [`porta/nr12_oficial/` + `porta/receptor_esp32/`](../porta/README.md) |

Três dos quatro firmwares estão escritos. A balança foi a primeira
(`weight/balanca2_3/`, manual em `weight/README.md`) e as duas placas do
dispenser vieram depois (`dispenser/`, manual em `dispenser/README.md`). **A
mesa CNC continua sem código no repositório**, e para ela este documento segue
sendo o que alguém vai ler para escrevê-la.

O contrato **não mudou** quando o firmware apareceu: ele deixou de ser promessa,
que é coisa diferente. Quem confronta as cópias é `tests/test_protocolo_placas.py`
(documento × adapter × placa falsa) e, do lado do firmware,
`tests/test_balanca_serial.py` e `tests/test_dispenser_firmware.py`.

O `vision-adapter` **não** entra: a visão continua por HTTP. E `dispenser` e
`dispenser_tft` são **duas portas físicas do mesmo adapter**: acionar os 8
mecanismos, desenhar 8 telas e manter a serial não cabe num ESP só, e quem já
vê todo comando que desce e todo evento que sobe do slot é o dispenser-adapter
— ver a seção 6. A porta NR-12 é o caso oposto, e de propósito: placa própria,
USB própria e adapter próprio (`porta-adapter`, HTTP 8104), para que travar ou
regravar a placa das telas não cegue a vigia da porta — ver a seção 9.
**Em campo, desde 22/10/2026, a porta não fala este contrato**: ela fala linhas
de texto, decide a tag sozinha e o PC só LÊ — ver a seção 10, que é o contrato
da porta de hoje. A seção 9 descreve o firmware JSON anterior.

---

## 1. Enquadramento

* **Uma linha JSON por mensagem**, terminada em `\n`. Nada de framing binário.
* **Teto de 1024 bytes por linha**, nos dois sentidos. O firmware lê para um
  buffer fixo; linha maior é DESCARTADA de propósito e logada — nunca partida em
  duas, porque meia linha é JSON inválido e a mensagem sumiria sem rastro. O
  teto sai da ORIGEM do dado: a maior mensagem do contrato é o evento `peso_ok`
  (~450 B com todos os campos).
* **Lixo antes do `{` não mata a mensagem.** O firmware imprime log e JSON no
  mesmo Serial e eles saem grudados (`Iniciando HX711...{"cmd":"ping",...}`).
  Os dois lados extraem o JSON a partir do primeiro `{`; o que vier antes é log.
* **Linha sem JSON válido é log**, nunca exceção.
* `115200` baud, 8N1.
* Codificação UTF-8 (nomes de medicamento têm acento).

## 2. Mensagens de serviço — iguais nos três subsistemas

| direção | mensagem | quando |
|---|---|---|
| placa → adapter | `{"cmd":"ping","sub":"<subsistema>"}` | no boot e periodicamente |
| adapter → placa | `{"resp":"pong","epoch":<unix>,"sessao":<unix>}` | resposta ao ping |
| adapter → placa | `{"cmd":"<nome>","cmd_id":<n>,"sessao":<unix>,...campos}` | comando |
| placa → adapter | `{"resp":"ok","cmd_id":<n>}` | ACK positivo |
| placa → adapter | `{"resp":"erro","cmd_id":<n>,"msg":"..."}` | ACK negativo |
| placa → adapter | `{"evento":{...payload...}}` | resultado e telemetria |

**Quem inicia o ping é sempre a placa.** É assim que a porta é identificada: com
`<SUB>_SERIAL_URL` vazia, o adapter varre as portas e aceita a primeira que
emitir o ping DAQUELE `sub`. A detecção **não** usa VID/PID — o VID/PID de um
conversor USB-serial é o mesmo em placas de fabricantes diferentes, e casar por
ele acha a placa errada, que aqui significa mandar `dispensar` para a balança.

O `epoch` do pong é como a placa acerta o relógio sem NTP.

`sessao` é o epoch de BOOT do processo do adapter, e ela não muda enquanto ele
vive. Ver "`sessao` — o contador nasce de novo, e a placa precisa saber".

### ACK não é conclusão

O ACK diz que a placa **aceitou** o comando, não que o executou. Um `mover` leva
segundos; um `dispensar` leva mais. O resultado chega **depois**, como `evento`
assíncrono, e é ele que o orquestrador espera (`aguardar_evento`).

* prazo de ACK: curto e configurável (`<SUB>_ACK_TIMEOUT_S`, default **2 s**);
  é só dele que o endpoint `/comandos/*` depende para responder;
* prazo de CONCLUSÃO: continua no orquestrador (`TIMEOUT_CARREGAMENTO`,
  `TIMEOUT_DISPENSA`, `TIMEOUT_PESO`, ...), e não muda com o transporte.

### `cmd_id` — todo comando leva, e repetição é IGNORADA pela placa

O adapter gera um inteiro **monotônico por porta**, a partir de 1. A placa guarda
o último `cmd_id` executado **por subsistema** e, ao receber um `cmd_id` menor ou
igual, responde o ACK de novo **sem executar**.

Com ACK perdido, a reação natural de qualquer camada é reenviar — e reenviar
`dispensar` é dose dobrada no leito. O `serial_link.py` não reenvia nada, nem por
engano nem por configuração, mas o `cmd_id` existe para que a ponta de lá
sobreviva a um reenvio de qualquer origem (um restart do adapter, um operador
repetindo a ação, uma versão futura que decida retentar). É a parte do protocolo
que não dá para acrescentar depois sem trocar as duas pontas ao mesmo tempo.

### `sessao` — o contador nasce de novo, e a placa precisa saber

O `cmd_id` é monotônico **dentro de uma sessão do adapter**: ele nasce em 1 a
cada `LinkSerial` novo. A regra de idempotência acima, sozinha, transforma isso
num modo de falhar: um restart de 2 a 5 s do processo (o `.bat` da bancada
reinicia sozinho) faz o contador voltar a 1 com a placa ainda em
`ultimoCmdId = 47`, e **todo comando até 47 recebe ACK POSITIVO sem executar**.

Com o ciclo por relógio o sintoma mudou de lugar: não é só timeout — o central
segue o cronograma e dispara o `dispensar` de um `mover` que a mesa nunca fez.

Por isso o adapter manda `sessao` — o epoch de boot do processo dele — no pong
**e em todo comando**. A placa guarda a última que viu e, quando ela MUDA, zera
`ultimoCmdId`.

Três detalhes que são contrato, não implementação:

* **a comparação é de DIFERENÇA, não de ordem.** Relógio do host que ande para
  trás (NTP, fuso, máquina sem RTC) continua sendo uma sessão nova, que é o que
  importa;
* **`sessao` ausente ou zero significa "ainda não sei"**, e a primeira que a
  placa vê é adotada sem zerar nada. Zerar na primeira faria todo boot da placa
  descartar o primeiro comando legítimo;
* **a adoção vem ANTES da checagem de idempotência**, no caminho do comando. O
  pong também a carrega, mas o primeiro comando depois de um restart pode chegar
  antes do primeiro pong — e é justamente ele que não pode ser respondido como
  repetido.

A heurística anterior continua no firmware como rede de segurança: silêncio de
mais de `SESSAO_SILENCIO_MS` (10 s) sem pong também zera o contador. Ela cobre o
adapter que ficou fora por muito tempo; o que ela **não** cobre é o restart
rápido, que é o comum — 2 s de queda não chegam perto de três pings perdidos.

### Telemetria periódica não pode encher o canal

O dispenser emite status dos 8 slots a cada 15 s e a balança tem leitura
contínua. Num canal de 115200 baud compartilhado com os ACKs que o adapter está
esperando, despejo periódico compete com o caminho crítico. Portanto:

* a placa manda **transição na hora** e periódico com intervalo configurável;
* o adapter **descarta telemetria repetida idêntica** (comparação ignorando
  `ts`) em vez de encaminhá-la ao central — mesma regra que o central já aplica
  no broadcast do WebSocket. Os tipos sujeitos ao filtro são `telemetria`,
  `status`, `movendo` e `retornando`; transição nunca é filtrada.

### `injetar_falha`

Atravessa o adapter **sem interpretação**, até a placa — exatamente como já
atravessa até o simulador. É o que mantém a demonstração de falhas do console
funcionando com hardware real. A placa trata o valor num ramo isolado, antes de
qualquer sorteio, e valor desconhecido é ignorado **com aviso**.

---

## 3. `dispenser` — os 8 dispensers

**Firmware escrito:** `dispenser/servos_hub/servos_hub.ino` (ESP32 + PCA9685 +
8 servos + 8 TCRT5000). O [`dispenser/README.md`](../dispenser/README.md) é o
manual dele — as duas vozes na mesma porta, a contagem por IR, o terminal de
calibração que continua valendo e os pontos a confirmar na bancada. O que está
aqui é o contrato; o que está lá é a placa.

### Comandos (adapter → placa)

| `cmd` | campos | efeito |
|---|---|---|
| `carregar` | `dispenser_id`, `medicamento`, `sku`, `categoria`, `quantidade`, `os_id` | carrega o slot |
| `dispensar` | `dispenser_id`, `os_id`, `injetar_falha` (opcional), `quantidade` (opcional) | dispensa a carga do slot — `quantidade` só na RETOMADA depois de um `parar` |
| `limpar` | `dispenser_id`, `solicitado_por` | esvazia o slot |
| `parar` | `motivo` (opcional) | a dispensa em curso termina a unidade atual e para (porta NR-12, §9) |

### Eventos (placa → adapter, dentro de `{"evento":{...}}`)

| `tipo` | campos principais |
|---|---|
| `carregado` | `dispenser_id`, `os_id`, `medicamento`, `sku`, `categoria`, `quantidade_total`, `quantidade_residual`, `via_residual`, `ts` |
| `dispensado` | `dispenser_id`, `os_id`, `medicamento`, `quantidade_dispensada`, `quantidade_alvo`, `falha_mecanica`, `motivo_falha`, `quantidade_residual`, `falha_injetada`, `ts` |
| `limpeza_ok` | `dispenser_id`, `medicamento_limpo`, `solicitado_por`, `ts` |
| `dispensado_parcial` | `dispenser_id`, `os_id`, `medicamento`, `quantidade_confirmada`, `quantidade_pedida`, `quantidade_residual`, `ts` |
| `erro` | `dispenser_id`, `os_id`, `codigo_erro`, `descricao`, `ts` |
| `telemetria` | `dispenser_id`, `componente`, `tipo_leitura`, `valor_c`, `unidade`, `ts` |
| `status` | `dispenser_id`, `status`, `os_id`, `medicamento`, `quantidade`, ... `ts` |

**`limpeza_ok` NÃO carrega `os_id`**, e isso é contrato, não esquecimento:
limpeza é operação de slot, não de OS. A chave de espera do orquestrador é
`limpeza:{dispenser_id}`, sem prefixo de OS (ver CLAUDE.md, "Eventos de limpeza
não têm `os_id`").

`erro` com `codigo_erro: "limpeza_em_operacao"` é a recusa de limpar um slot que
está carregando ou dispensando.

### `parar` — termina a unidade, para, e diz quantas caíram

É o comando da porta NR-12 aberta (§9): o central para a célula inteira, e o
dispenser que estiver no meio de uma dispensa **termina a unidade atual e
para** — o braço completa o ciclo e o pulso do IR daquela unidade é esperado no
prazo de sempre. Parar o braço no meio deixaria uma caixa presa na boca do
dispenser, contada por ninguém.

* com dispensa em curso: ACK na hora, e depois `dispensado_parcial` com
  `quantidade_confirmada` (o que o IR contou) e `quantidade_pedida`. O slot
  **continua da OS**, PRONTO, com o restante como alvo;
* sem dispensa em curso: **só o ACK** — não há o que parar;
* `cmd_id` repetido: ACK de novo, sem executar, como todo comando.

`parar` é aceito COM slot em operação, ao contrário dos outros três: ele quase
sempre chega no meio de um `dispensar`, pelo `serialPoll` de dentro do laço. Se
a última unidade já tinha saído quando ele chegou, a dispensa termina normal e o
que sai é o `dispensado` de sempre.

Na retomada, o central manda `dispensar` com `quantidade` = pedida − confirmada.
`dispensado_parcial` **não é falha**: não vira alarme, e o Triple Check do slot
compara o TOTAL das duas partes.

---

## 4. `cnc` — a mesa CNC

**Firmware escrito:** `cnc/receitas_manuais/receitas_manuais.ino` (ESP32 +
CoreXY). O [`cnc/README.md`](../cnc/README.md) é o manual dele — as duas vozes
da porta, as receitas de bancada, os trajetos medidos e o que falta conferir na
bancada. O que está aqui é o contrato; o que está lá é a placa.

**O central agenda, a mesa avisa, ninguém espera o aviso.** É a frase que
resume o modelo, e ela inverte o que este documento dizia antes. O ciclo
`mover` → `dispensar` não é mais um handshake: o central calcula QUANDO cada
peça acontece e dispara na hora marcada, tenha o evento chegado ou não. O
evento da placa serve para **registrar** — a posição medida, a contagem — e, no
máximo, para **cancelar**. Ver "Por que o relógio e não a confirmação", abaixo.

### Comandos (adapter → placa)

| `cmd` | campos | efeito |
|---|---|---|
| `mover` | `dispenser_alvo`, `os_id`, `receita`, `ciclo_atual`, `total_ciclos` | move a mesa até o slot |
| `homing` | `os_id`, `posicao_x` (opcional), `posicao_y` (opcional) | volta ao HOME |
| `estado_celula` | `trava_ativa`, `trava_slot_id` (opcional), `os_id` (opcional), `trava_resumo` (opcional) | trava do Triple Check |
| `parar` | `motivo` (opcional) | para o movimento em curso ONDE ESTÁ, sem homing (porta NR-12, §9) |
| `centro` | `os_id` | leva a mesa ao centro operacional — fim de OS, depois da conferência final da caixa |

**`centro` é a voz de máquina do `C` humano, e a posição é uma só.** O terminal
de bancada já tinha `C` (e `CENTRO`), que vai ao centro operacional gravado na
NVS (`CENTRO_X_MM`/`CENTRO_Y_MM`, ajustado por `NOVOCENTRO`). O comando de
máquina chama a MESMA função de movimento (`ir_ao_centro()`): dois centros — um
para o humano, outro para o central — concordariam só até o primeiro
`NOVOCENTRO`. O nome no JSON é `centro`, e não a letra, pela regra de todo o
vocabulário de máquina (`mover`, `homing`, `parar`): a letra é do humano, e as
duas vozes se separam pelo `{`, não pelo nome.

Ele segue as regras do `mover`, campo a campo:

* **ACK idempotente** — `cmd_id` repetido responde ACK de novo e NÃO move
  (§2): o central pode reenviar `centro` pelo console ("reenviar centro"), e um
  reenvio por ACK perdido não pode virar dois movimentos;
* **recusa antes do ACK** — `travado` com a trava ativa, `sem_homing` sem
  homing bem-sucedido nesta energização (centro sem referência é um ponto que
  não existe), `fora_do_envelope` se o centro gravado caiu fora dos limites,
  `limit_disparado` com fim de curso já acionado. ACK negativo E evento `erro`,
  sempre os dois. Mesa já andando: só ACK negativo, como o `mover`;
* **`parar` vale no meio** — o mesmo passo do `sync_move` confere a flag: a mesa
  fica onde parou, sem origem, e nenhum evento sai;
* **chegada é `posicionado` com `destino: "centro"`** e `dispenser_alvo: 0` (não
  existe dispenser 0); falha depois do ACK é `erro` com `dispenser_alvo: 0` e o
  `codigo_erro` do vocabulário fechado abaixo;
* **NÃO emite `concluido`.** `concluido` é o fim de um homing, e a mesa no centro
  não está no HOME. Quem decide que a OS acabou é o central, ao receber a
  chegada ao centro (CLAUDE.md, "A caixa é conferida duas vezes no HOME").

**`parar` é o caminho de parada da trava SEM o retorno ao HOME.** A flag é
conferida no mesmo passo do `sync_move` que confere a trava, e o ACK sai na
hora — é ele que o central espera para autorizar a porta. Interrompido, o
`mover` não emite evento (quem parou foi o central) e a placa **perde a
origem**: `ja_fez_homing` vai a `false`, e todo `mover` seguinte é recusado com
`sem_homing` até o homing que o central manda na RETOMADA, com a porta fechada
e rearmada. Mover a mesa até o HOME com alguém com a mão na célula seria o
contrário do que a porta existe para garantir. Com a mesa parada, `parar` é só o
ACK.

**A coordenada NÃO vem no comando — o endereço é o dispenser.** O roteiro é
medido na bancada e gravado na placa, waypoint a waypoint, indexado pelo
DISPENSER; o firmware valida a faixa (`1 <= dispenser_alvo <= NUM_SLOTS`) e vai
ao waypoint dele. Em troca, é a placa que REPORTA onde parou, no `posicionado`,
e é essa medida que o central registra.

O waypoint é por dispenser e não por posição na receita porque a rota é decidida
no central em tempo de execução (serpentina) e muda quando um slot sai da OS:
"vá ao ponto 3" seria outro dispenser no dia seguinte, a mesa iria ao lugar
errado, e o sintoma chegaria como divergência de SKU num slot só —
indistinguível de uma falha mecânica.

`receita` é a letra A–J do slot da NVS **ou vazia** (OS personalizada, montada
no console): ela diz QUAL ordem está em execução, vai para o log da placa (vazia
sai como `-`), e **não** é usada para achar a posição. Vazia é "OS sem receita",
nunca uma letra emprestada de outra ordem — o log mentiria qual roteiro rodou.

### Eventos (placa → adapter)

| `tipo` | campos principais |
|---|---|
| `posicionado` | `os_id`, `dispenser_alvo`, `destino`, `posicao_x`, `posicao_y`, `ciclo_atual`, `total_ciclos`, `ts` |
| `concluido` | `os_id`, `posicao_x`, `posicao_y`, `ts` |
| `erro` | `os_id`, `dispenser_alvo`, `codigo_erro`, `descricao`, `ts` |
| `telemetria` | `componente`, `tipo_leitura`, `valor`, `unidade`, `ts` |

Os três primeiros são transição, e os três viram linha em `cnc_eventos` no
central (CLAUDE.md, "Só transição vira linha").

`destino` diz para ONDE a mesa foi: `"dispenser"` na chegada de um `mover`,
`"centro"` na do `centro`. Ele existe nos dois para o `posicionado` ter UMA forma
só — o central roteia pela chave, e um evento com dois formatos é um campo que
some sem erro do lado que não o esperava. `dispenser_alvo: 0` acompanha o
`centro` (no `posicionado` e no `erro`) porque não existe dispenser 0.

**`estado_celula` PRODUZ evento na mesa**, e é a diferença dela para a placa das
telas, onde o mesmo comando só pinta. A tabela acima não dizia isso, e o
silêncio custou dois defeitos que ficaram de pé com a suíte verde.

Na transição para TRAVADA, e só na transição:

| a mesa estava… | o que sai |
|---|---|
| andando | `erro` com `codigo_erro: travado`, e depois o retorno ao HOME |
| parada | só o retorno ao HOME |

Com um `mover` em curso, quem emite o `erro` é o próprio comando interrompido —
é lá que se sabe qual OS e qual dispenser esperavam a chegada. A mesa vai ao HOME
nos dois casos porque é onde o supervisor espera encontrá-la para mexer na
bancada.

**O retorno ao HOME segue a regra do `homing`:** falhou, sai `erro` com
`homing_falhou` e **não** sai `concluido`. Um `concluido` ali afirmaria que a
mesa está no HOME quando ela está onde o eixo travou — e, pior que no `cmdHoming`,
`ja_fez_homing` fica `false` e todo `mover` seguinte é recusado com `sem_homing`:
o supervisor libera a trava e a OS SEGUINTE aborta com um erro que aponta para o
lugar errado.

**O `concluido` do retorno leva o `os_id` da OS que travou**, e quem decide o
que fazer com isso é o central: ele NÃO fecha OS travada (CLAUDE.md, a guarda em
`_handle_evento_cnc`). A mesa reporta o que ela fez; ela não diz o que a OS
virou.

A LIBERAÇÃO não produz evento nenhum e não refaz homing: a mesa já está no HOME
desde a ativação, e um segundo homing custaria segundos no exato momento em que
o supervisor acabou de liberar a produção.

**Nada de periódico durante o movimento — no SERIAL.** `movendo` e `retornando`
continuam existindo no `cnc_simulator`, que fala HTTP e alimenta a trajetória
ao vivo do dashboard; o FIRMWARE não os emite, e a diferença não é
esquecimento. Uma linha de ~200 B a 115200 baud custa ~17 ms, o curso mais
longo da célula dura ~2,0 s, e o central dispara o `dispensar` por relógio:
cada linha emitida no caminho empurra a chegada real para **depois** da hora
agendada — ou seja, comprimido caindo com a mesa ainda em trânsito. Por HTTP,
com uma conexão por evento, esse custo não existe.

| `tipo` | campos principais | quem emite |
|---|---|---|
| `movendo` | `os_id`, `dispenser_alvo`, `posicao_x`, `posicao_y`, `passo`, `total_passos`, `progresso_pct`, `ts` | só o `cnc_simulator` (HTTP) |
| `retornando` | `os_id`, `posicao_x`, `posicao_y`, `ts` | só o `cnc_simulator` (HTTP) |

### `codigo_erro` — vocabulário FECHADO

Todo evento `erro` da mesa carrega um destes, e nenhum outro. A lista é fechada
porque quem lê o outro lado é código: o central agrupa alarme por `codigo_erro`,
e a tela de necessidades manda o técnico à peça a partir dele. Um código
inventado na hora não dá erro em lugar nenhum — vira uma linha que ninguém sabe
ler.

| `codigo_erro` | comando | quando |
|---|---|---|
| `dispenser_invalido` | `mover` | `dispenser_alvo` fora de 1..`NUM_SLOTS` |
| `fora_do_envelope` | `mover`, `centro` | o waypoint calibrado (ou o centro gravado) caiu fora dos limites da mesa |
| `sem_homing` | `mover`, `centro` | origem nunca estabelecida — mande `homing` antes |
| `limit_disparado` | `mover`, `centro` | fim de curso acionado, antes ou durante o movimento |
| `travado` | `mover`, `centro` | trava do Triple Check ativa |
| `homing_falhou` | `homing` | um dos eixos não achou o fim de curso no prazo |
| `receita_desconhecida` | `mover` | **só o `cnc_simulator`** — a receita não está entre as gravadas |

`receita_desconhecida` é o único código que não vem do firmware, e a exceção
está aqui em vez de escondida: a placa ACEITA qualquer `receita` (ela é log, não
endereço — quem acha a posição é o waypoint do dispensador), enquanto o
simulador a valida para encenar, na demonstração, a ordem cujo roteiro ninguém
gravou. Os dois lados emitem `dispenser_invalido` para a mesma condição.

**Recusa é ACK negativo E evento `erro`, sempre os dois** — e eles vão para
leitores diferentes. O ACK negativo vira 502 no adapter e chega ao orquestrador
como `cmd_mover` falso: é ele que cancela o cronograma ANTES da hora do
`dispensar`. O evento vira alarme e linha de histórico, com o código que diz
onde ir. Só o ACK deixaria a recusa sem rastro; só o evento deixaria o central
seguindo o relógio até despejar medicamento numa mesa que não chegou.

A única falha que acontece DEPOIS do ACK positivo é o fim de curso disparando
com a mesa andando — aí não há ACK a corrigir, e o evento é o aviso. Tudo que
dá para conferir antes é conferido antes, por isso.

`homing` que estoura o prazo **não** emite `concluido`: emite `erro` com
`homing_falhou` e a placa fica sem origem, recusando todo `mover` seguinte. Um
`concluido` ali afirmaria que a mesa está no HOME, e ela está onde o eixo
travou.

### Por que o relógio e não a confirmação

O modelo anterior era um handshake: o `dispensar` só saía depois de o
`posicionado` chegar, e o ciclo só fechava com o `dispensado`. Ele foi trocado,
e o que se ganhou é previsibilidade — o tempo de uma OS passa a ser a soma de um
cronograma que o central calcula, em vez de depender de quantos eventos se
perderam no caminho.

**O que custa, e este parágrafo existe para que o custo não seja redescoberto
daqui a seis meses:**

* **Um `dispensado` que não chega não para nada na hora.** O prazo vence, o
  ciclo é marcado `sem_confirmacao`, e a OS segue para o próximo slot. Quem
  reconcilia é o Triple Check no fim de cada ciclo, onde o dispenser entra como
  **fonte que não mediu** — não como fonte que divergiu. Com limiar 1, basta
  uma das outras duas discordar para a OS travar.
* **A ausência do `posicionado` não cancela nada.** É a parte que quem mexer
  aqui vai querer "consertar", pondo um `await` de volta no meio do ciclo — e
  isso é o handshake de volta. Um evento perdido no encaminhamento (o
  `_post_central` do adapter desiste depois de 3 tentativas) chega ao central
  idêntico à mesa parada. Tratar os dois como iguais aborta OS com o hardware
  intacto, que é o custo que o modelo antigo pagava.
* **O que veta é só um `erro` EXPLÍCITO**, ou o ACK negativo do `mover`. São as
  duas únicas defesas antes do `dispensar`, e é por isso que o firmware recusa
  com ACK negativo em vez de apenas emitir evento.
* **O cronograma tem de acompanhar a máquina.** `DISPENSA_S_POR_UNIDADE` no
  central e o `(qty + 1) × 1000 ms` do `WP()` no firmware descrevem o MESMO
  mecanismo físico visto de dois lugares. Ajustar um só faz o central cortar a
  dispensa no meio: a OS termina "completa" com menos comprimido no leito, que
  é o pior desfecho possível desta frente.

---

## 5. `weight` — a balança HX711

**Firmware escrito:** `weight/balanca2_3/balanca2_3.ino`
(ESP32 + 4 × HX711), o primeiro desta célula a sair do papel. O
[`weight/README.md`](../weight/README.md) é o manual dele — tabela de eventos,
comandos aceitos pela serial, os dois comandos que o PC **não** pode mandar, e
o aviso do DTR. O que está aqui é o contrato; o que está lá é a placa.

A balança é uma **balança de bancada antes de ser um periférico da célula**:
ela conta por peso, calibra canal a canal e sempre foi configurada pelo Monitor
Serial. Daí a seção ter duas famílias de mensagem, e a linha entre elas ser o
destino: o que é da OS sobe ao central, o que é da bancada para no adapter.

### Comandos (adapter → placa)

| `cmd` | campos | efeito |
|---|---|---|
| `tara` | `os_id` | zera a balança |
| `pesar` | `os_id`, `slot_id`, `quantidade_esperada`, `quantidade_real`, `peso_unitario_g`, `injetar_falha` (opcional) | lê o peso e calcula o desvio |

**O comando leva DUAS quantidades, e confundi-las inverte o teste:**
`quantidade_esperada` é o alvo da OS (base do peso ESPERADO, e portanto do
desvio); `quantidade_real` é o que o dispenser reportou ter soltado (base do peso
que a mesa efetivamente ganha). A divergência emerge da diferença entre as duas —
é o que uma célula de carga mede na vida real. `quantidade_real` ausente cai na
esperada, preservando o contrato antigo.

**`tara` move o zero LÓGICO da mesa, e não toca no hardware.** O offset do HX711
é calibração, gravada na NVS, e só muda com o operador presente — é o
`tara_canais` da bancada. Tarar o hardware no meio de uma OS levaria junto o
peso que já estava na mesa, e a balança passaria a mentir para sempre, sem erro
em lugar nenhum.

**O `pesar` espera a mesa parar antes de medir** (até 3 s), e essa espera cabe
DEPOIS do ACK: o relógio que corre nela é o `TIMEOUT_PESO` do orquestrador
(15 s), nunca o `ack_timeout_s` (2 s). É a razão de o ACK existir separado.

### Comandos de bancada (só no serial)

Estes **não estão em `_ROTAS_SIM`** e **não existem no `weight-simulator`** —
são da PLACA, e só existem quando há placa. Uma entrada em `_ROTAS_SIM`
prometeria as duas pernas, e a perna HTTP daria 404 no transporte que é o
default. O adapter os expõe em `POST /bancada/*` e responde **503** com o
transporte `http`.

Eles existem porque, com `WEIGHT_TRANSPORTE=serial`, o adapter é o **dono** da
porta: ninguém mais abre o Monitor Serial. Sem eles, definir o peso unitário
passaria a exigir parar o adapter.

| `cmd` | campos | efeito | equivale a digitar |
|---|---|---|---|
| `peso_unitario` | `valor_g` | define o peso de uma unidade e grava na NVS | `g<valor>` |
| `tara_recipiente` | — | mede o pote vazio e o desconta da contagem | `k` |
| `tara_canais` | — | zera os offsets do HX711 (**calibração**, grava na NVS) | `t` |
| `contar` | — | espera estabilizar e conta por peso | `x` |
| `config` | — | publica a configuração gravada | `C` |
| `stream` | `on` (bool, ausente = liga) | liga/desliga o stream periódico de peso | `j` |

**O PC nunca manda `u` nem `c0`..`c3`.** Esses dois são interativos: o firmware
bloqueia em `readSerialLine()` por até 15 s esperando alguém digitar, e durante
esse tempo a placa não lê comando nem responde ACK. O equivalente não
bloqueante de `u` é `peso_unitario`; calibrar canal é operação de bancada, com
peso padrão na mão, e não tem equivalente remoto de propósito.

### Eventos (placa → adapter)

| `tipo` | campos principais |
|---|---|
| `tara_ok` | `os_id`, `peso_tara_g`, `ts` |
| `peso_ok` | `os_id`, `slot_id`, `quantidade_esperada`, `quantidade_real`, `peso_unitario_g`, `peso_esperado_g`, `peso_medido_g`, `peso_acumulado_g`, `desvio_g`, `desvio_pct`, `tolerancia_pct`, `dentro_tolerancia`, `falha_injetada`, `ts` |
| `peso_divergencia` | os mesmos campos do peso_ok acima |
| `erro_sensor` | `os_id`, `slot_id`, `descricao`, `ts` |
| `telemetria` | `componente`, `temperatura_c`, `peso_atual_g`, `ts` |
| `boot` | `fw`, `canais_ativos`, `uw_g`, `ts` |
| `peso` | `total_g`, `canais_g`, `sat`, `estavel`, `ts` |
| `contagem` | `total_g`, `liquido_g`, `exata`, `contagem`, `status`, `aceite`, `ts` |
| `cfg` | `uw_g`, `tara_g`, `tol_g`, `min`, `max`, `sreads`, `sthres_g`, `ts` |
| `estado` | `estado`, `ts` |
| `tara_balanca` | `alvo`, `valor_g`, `ts` |
| `erro_balanca` | `msg`, `cmd`, `ts` |

`peso_ok` é a maior mensagem do contrato e é ela que dimensiona
`MAX_LINHA_BYTES`.

**Os cinco primeiros sobem ao central. Os sete últimos PARAM no adapter** e
saem por `GET /balanca` (`_EVENTOS_BANCADA` em `weight-adapter/main.py`). O
central não tem endpoint para eles e não decide nada com eles; despejá-los em
`/api/v1/eventos/peso` misturaria duas conversas num histórico que hoje é só de
pesagem de OS — e como o evento atravessa sem interpretação, o central gravaria
o buraco sem erro. É a mesma divisão que a seção 6 faz com os eventos das telas.

O corolário é o que torna a lista verificável: um `tipo` fora de
`_EVENTOS_BANCADA` **é** encaminhado. Esquecer de acrescentar um evento novo
falha para o lado visível — uma linha estranha no central —, nunca para o mudo.

**`boot` é o único evento que muda o comportamento do adapter.** Ele marca a
tara como não confiável (`/balanca`, `tara_confiavel`), e o motivo é o item 7
deste documento ao contrário: abrir a porta **não** reinicia a placa, porque
DTR/RTS saem desligados antes do `open()`. Então um `boot` que chega aqui é um
boot que ninguém pediu — queda de energia, botão de reset, ou outro processo
abrindo a porta —, e o `setup()` da balança **tara sozinho** depois de 5 s: se
havia peso na mesa, a tara levou o peso junto. Não bloqueia nada; quem decide é
quem lê. Um `POST /comandos/tara` aceito devolve a confiança, porque é
exatamente o ato que o boot invalidou.

**Vocabulário fechado**, e ele é do firmware:

* `estado` ∈ `IDLE`, `AWAITING_TARA`, `AWAITING_DEPOSIT`, `TRANSIENT`,
  `COUNTING`, `DONE` (o `CountState` do sketch);
* `status` da contagem ∈ `OK`, `UNDER_TOLERANCE`, `OVER_TOLERANCE`, `UNSTABLE`,
  `INVALID_WEIGHT`, `NO_UNIT_WEIGHT` (o `CountResult`);
* `alvo` da tara ∈ `canais` (hardware) ou `recipiente` (o pote).

Nome divergente aqui não dá erro: dá uma tela que nunca sai de "desconhecido".

**`canais_g` traz `null` no canal inativo**, e não zero — zero é uma leitura, e
a bancada tem um canal desligado de propósito. Pela mesma razão todo float é
protegido contra `NaN`/`inf` na origem: emiti-los como `nan` faria o
`json.loads` do adapter descartar a linha INTEIRA, e um campo estragado levaria
junto os quinze que estavam certos.

**Só o stream é periódico**, a 5 Hz. `contagem`, `cfg`, `estado` e
`tara_balanca` saem na transição, como manda a seção 2 — e `estado` sai de
`setCountState()`, o único lugar do firmware que atribui `countState`.

---

## 6. `dispenser_tft` — as 8 telas TFT

**A segunda placa do dispenser-adapter, numa segunda porta.** Acionar os 8
mecanismos, desenhar 8 telas e manter a serial não cabe num ESP só: são DUAS
placas, em DUAS portas — `dispenser` (os mecanismos, a seção 3, sem mudança) e
`dispenser_tft` (as telas). O dono das duas é o **mesmo** `dispenser-adapter`,
com dois `LinkSerial` (`DISPENSER_TFT_TRANSPORTE`, `DISPENSER_TFT_SERIAL_URL`,
`DISPENSER_TFT_SERIAL_BAUD`, `DISPENSER_TFT_ACK_TIMEOUT_S`). Não entra serviço
novo: este adapter é um tradutor, e já vê todo comando que desce e todo evento
que sobe do slot — ou seja, já tem em mãos tudo que as telas precisam mostrar.
Um tft-adapter separado obrigaria o central a mandar a mesma informação duas
vezes, e duas cópias divergem.

Com `DISPENSER_TFT_TRANSPORTE=http` (o default) não há tela nenhuma e o
adapter se comporta exatamente como antes desta placa existir.

**Firmware escrito:** `dispenser/telas_tft/telas_tft.ino`. Ele compartilha com
a placa dos mecanismos o núcleo do protocolo (`apsen_serial.h`, cópia idêntica
nas duas pastas, com teste cobrando a igualdade) e não implementa nada além do
que esta seção descreve. O painel é o da bancada — oito ST7735 de 128×160 —
e cada slot carregado mostra a **imagem da caixa** do medicamento; ver
[`dispenser/README.md`](../dispenser/README.md).

**O `slot` continua levando o NOME, e a placa o traduz para o número da
imagem.** A tabela nome → número é `dispenser/telas_tft/catalogo_imagens.h`,
ao lado de `imagens.h`: a ordem das imagens é um fato daquela pasta, e um
campo `imagem` calculado no adapter seria um segundo lugar guardando o mesmo
fato — divergir ali não dá erro, dá a caixa de outro medicamento na tela. A
comparação ignora maiúsculas e espaços, e só isso; nome sem imagem vira tela
de texto, nunca uma caixa aproximada.

### Comandos (adapter → placa)

| `cmd` | campos | efeito |
|---|---|---|
| `slot` | `dispenser_id`, `medicamento`, `sku`, `categoria`, `quantidade_alvo`, `quantidade_dispensada`, `quantidade_residual`, `status`, `os_id` | redesenha a tela do slot |
| `estado_celula` | `trava_ativa`, `trava_slot_id`, `os_id`, `trava_resumo`, `pausa_porta` (opcional), `pausa_resumo` (opcional) | há trava na célula, e de que slot é; e se a porta NR-12 parou a célula (§9) |

**`slot` sai na transição, e só nela:** ao aceitar `carregar`/`dispensar`/
`limpar` (estado que o adapter acabou de comandar) e ao receber `carregado`,
`dispensado`, `limpeza_ok` e `erro` da placa dos mecanismos — antes de
encaminhá-los ao central. Não há laço periódico: o canal é 115200 e a regra de
não competir com o caminho crítico é a da seção 2.

**`estado_celula` vai SÓ para esta placa.** A placa dos mecanismos não tem
tela e não precisa saber da trava — quem para a dispensa é o orquestrador, não
ela. `trava_slot_id` pode vir nulo (trava sem slot), mas a chave vem sempre.

**`trava_resumo` tem TETO DE 48 CARACTERES** e sai da CATEGORIA da divergência
("divergência de peso", "contagem divergente", "SKU errado", "dispenser
divergente"), nunca da string formatada. O motivo completo do central passa de
240 caracteres e **não viaja**: mandá-lo acoplaria o formato de mensagem do
central à largura de uma tela e criaria um segundo ponto de truncamento para
algo cosmético. O motivo completo é do display de 7" e da web, onde o
supervisor decide; a tela do slot responde uma pergunta só: *é este slot?*

**Falha da placa das telas NUNCA muda o caminho do dispenser.** Não recusa
comando, não atrasa ACK, não impede o encaminhamento do evento ao central. O
adapter loga e segue. Tela errada é cosmética; dispensa atrasada não é.

**Esta placa não carrega mais a porta NR-12.** A porta tem USB e adapter
próprios (§9): a placa das telas não tem UART com ela, não repassa linha
nenhuma, não responde o ping dela e não vigia o heartbeat dela. Um `porta_*`
que chegue aqui é um comando como qualquer outro fora desta tabela — **ACK
negativo** `comando desconhecido`. O que fica é só a FAIXA da pausa
(`pausa_porta`/`pausa_resumo` no `estado_celula`): é o central avisando as
telas de que a célula parou, não a porta passando por esta placa.

### Tabela de pintura

É o que o firmware das telas implementa, e nada além disso:

| estado recebido | a tela do slot mostra |
|---|---|
| `trava_ativa=false`, medicamento com imagem | a caixa do medicamento, tela cheia; faixa **D{n} ERRO** se `status=erro` |
| `trava_ativa=false`, sem imagem | texto: D{n} · status · nome (ou **VAZIO**) · dispensada/alvo |
| `trava_ativa=true` e `trava_slot_id` == meu id | fundo vermelho + **AGUARDE SUPERVISOR** + `trava_resumo` |
| `trava_ativa=true` e outro slot | a mesma tela, com a faixa **PARADO — D{n}** no topo |
| `pausa_porta=true` (e não é a trava DESTE slot) | o conteúdo esmaecido, com a faixa vermelha `pausa_resumo` no topo |

`pausa_resumo` é a faixa do central (`MAQUINA PARADA - PORTA FRENTE ABERTA`,
`PORTAS FECHADAS - PASSE A TAG PARA RETOMAR`, `LINK DA PORTA PERDIDO`), em
ASCII e no mesmo teto de 48 do `trava_resumo`. Os dois campos da pausa só vêm
quando há pausa, ou no aviso da retomada (`pausa_porta: false`); ausentes, a
placa trata como "sem pausa" — e o aviso de trava sem porta sai byte a byte
como antes.

### Eventos (placa → adapter, dentro de `{"evento":{...}}`)

| `tipo` | campos principais |
|---|---|
| `telemetria` | `telas_ok`, `brilho_pct`, `ts` |
| `erro` | `dispenser_id`, `codigo_erro`, `descricao`, `ts` |

**Nenhum dos dois vai ao central.** Ele não tem endpoint de tela e não decide
nada com isso; despejá-los em `/api/v1/eventos/dispenser` misturaria duas
placas num histórico que hoje é de uma. Ficam no adapter: log e `/health`, que
passa a publicar o estado das DUAS portas, separadas por subsistema
(`serial` e `serial_tft`), no formato de `link.estado()`.

---

## 7. Execução: onde a porta é aberta

O código **não sabe** em qual sistema operacional está: ele chama
`serial.serial_for_url()`, que aceita `/dev/ttyUSB0`, `COM4`, `socket://h:p`,
`rfc2217://h:p` e `loop://` com a mesma API.

* **A célula montada roda num mini PC Windows.** O Docker Desktop não repassa
  porta COM para container, então os adapters seriais rodam **fora do
  Docker**, no host, abrindo a COM direto com pyserial — como o painel de
  bancada já fazia, pelo mesmo motivo. No compose os três que têm simulador
  (e os simuladores que substituem) estão atrás do profile `simulado`; o
  `porta-adapter` nem entra no compose, porque não há porta simulada. **Toda placa tem a COM fixada
  no Windows e a `<SUB>_SERIAL_URL` preenchida**: a varredura é só para
  desenvolvimento sem hardware, porque cada processo varrendo abre as portas
  dos outros por até 9,5 s cada e derruba o dono de verdade. O passo a passo
  está em `docs/DEPLOY_WINDOWS.md` e no README, seção "Portas seriais na célula
  montada".
* **Alvo Linux (se um dia houver).** As portas entram nos containers pelo
  `devices:` do compose (`/dev/ttyUSB0:/dev/ttyUSB0`). Nenhuma peça nova, o
  kernel garante dono único da porta, e o mapeamento fica declarado no mesmo
  arquivo onde o resto da topologia já está. O bloco está escrito e COMENTADO
  nos três serviços — e só vale para alvo Linux: ligar um device que não existe
  impede o serviço de subir, e o default é HTTP.
* **A ponte RFC2217 foi avaliada e preterida.** Ela manteria tudo em container
  expondo cada COM como socket TCP (`rfc2217://host:porta`), e o custo some do
  código — de dentro do adapter as duas montagens são a mesma chamada. Por isso
  fica escrito: mais um processo por porta para vigiar; latência a mais
  em todo comando e evento; "cabo caiu" e "ponte morreu" com o mesmo sintoma; e
  a perda da exclusividade de abertura — no Windows a COM é exclusiva de um
  processo (o segundo toma `ACCESS_DENIED`, que é o erro certo), e dois
  processos abrem o mesmo socket TCP sem erro nenhum, que é o que o item 1 do
  enquadramento existe para impedir.

### Configuração, por adapter

| variável | default | o que é |
|---|---|---|
| `<SUB>_TRANSPORTE` | `http` | `http` (simulador) ou `serial` (firmware) |
| `<SUB>_SERIAL_URL` | vazia | URL da porta; **vazia = varre e detecta pelo ping** |
| `<SUB>_SERIAL_BAUD` | `115200` | |
| `<SUB>_ACK_TIMEOUT_S` | `2` | prazo do ACK, não da conclusão |

`<SUB>` é `CNC`, `DISPENSER`, `WEIGHT` ou `DISPENSER_TFT` — as duas últimas no
mesmo `dispenser-adapter`, uma por porta. Para a balança, que é a que já tem
placa, isso quer dizer `WEIGHT_TRANSPORTE=serial` e `WEIGHT_SERIAL_URL=COM<n>`
com a COM fixada no Windows (`weight/README.md`). Com `http`, o comportamento é
EXATAMENTE o de antes desta feature — é o default justamente para que a suíte, o
CI e a demonstração em Docker não mudem de resultado (para as telas, `http`
significa "sem telas").

A porta NR-12 é a exceção da tabela: o `porta-adapter` **só** tem transporte
serial — não há simulador de porta, e fingir um ACK faria o central autorizar
uma porta imaginária. Não existe `PORTA_TRANSPORTE`; `PORTA_SERIAL_URL` é
**obrigatória** (vazia, o serviço recusa subir), e `PORTA_SERIAL_BAUD`/
`PORTA_ACK_TIMEOUT_S` seguiam os defaults acima no firmware JSON (seção 9). Em
campo (seção 10) a COM é a do ESP receptor, nada desce por ela, e não há ACK:
`PORTA_ACK_TIMEOUT_S` e `PORTA_HEARTBEAT_MAX_S` deixaram de existir.

## 8. Sem placa: as placas falsas

`tests/fakes/placa_dispenser.py`, `placa_dispenser_tft.py`, `placa_cnc.py`,
`placa_weight.py` e `placa_porta.py` falam este contrato inteiro por
`socket://`, cada uma na sua porta: respondem ping,
aceitam comando, devolvem ACK, ignoram `cmd_id` repetido e emitem os eventos
com atraso configurável (inclusive zero). Elas são o que permite exercitar o transporte sem hardware — e são também
o documento executável contra o qual o firmware foi escrito. É o mesmo papel
que `painel_operador/firmware/simulador_serial.py` já cumpre para o display.

Para os três subsistemas que já têm placa, a comparação fechou o círculo:
`tests/test_balanca_serial.py` e `tests/test_dispenser_firmware.py` confrontam
o FIRMWARE com a placa falsa e com este documento, campo por campo. Os dois
leem C++ por texto — não há AST para ele —, e por isso cada extrator tem um
piso de quantos símbolos precisa achar: um extrator que pare de casar deixaria
tudo verde para sempre, inclusive com o protocolo quebrado.

---

## 9. `porta` — a porta NR-12

> **Não é o que está gravado em campo.** Esta seção descreve o firmware JSON
> `porta/porta_nr12/` — USB própria, ping/pong, ACK, e o central autorizando a
> abertura. Desde 22/10/2026 a porta em campo é o `porta/nr12_oficial/` com o
> ESP receptor `porta/receptor_esp32/`, e o contrato dela é a **seção 10**. A
> seção 9 fica como está: a placa falsa `tests/fakes/placa_porta.py` e
> `tests/test_porta_firmware.py` ainda confrontam o firmware JSON, que continua
> no repositório.

**Duas portas físicas da célula, uma ESP, e uma USB só dela no mini PC.** A ESP
da porta (RC522 + dois fins de curso + LED "pode abrir") é uma placa DEDICADA,
como a balança e a CNC: USB própria, `sub: "porta"`, e um adapter só dela — o
**`porta-adapter`** (host, HTTP 8104), dono da COM em `PORTA_SERIAL_URL`.

```
ESP da porta ──USB (COMx)──> porta-adapter :8104 ──REST──> central
             <──────────────               <──────
```

**Ela não passa por placa nenhuma.** Houve um desenho em que a porta falava por
UART com a placa das 8 telas TFT e as telas repassavam pela USB delas ao
dispenser-adapter; ele saiu. Com a porta independente, travar ou regravar a
placa das telas não cega a vigia da porta, e a porta tem o seu `/health` e a
sua COM. A placa das telas voltou a ser só telas (seção 6).

**Duas vozes na MESMA USB, separadas pelo `{`** — a regra que o
`apsen_serial.h` aplica em todas as placas:

* linha com `{` é a voz de MÁQUINA: todo evento deste contrato, todo ACK e todo
  comando do central;
* linha sem `{` é a voz de BANCADA: os comandos de um caractere `R`/`S`/`C`/`L`/`E`
  (cadastro de tag e diagnóstico dos fins de curso) que chegam do Monitor
  Serial, e os logs para humano que a placa imprime. Nenhum log da placa leva
  `{` — um `{` num log viraria linha de máquina.

O adapter **nunca** envia linha sem `{`: um `R` vindo do PC poria a porta em
modo registro. E as duas vozes não convivem com dois programas: no Windows a COM
abre em um processo por vez, então cadastrar tag pelo Monitor Serial exige
PARAR o `porta-adapter` antes (`porta/README.md`).

As duas portas são **ES1 = `teto`** (abastecer remédio) e **ES2 = `frente`** (a
caixa sobre a balança). A célula só está FECHADA com as duas fechadas.

**Não há fechadura elétrica.** Cada porta é presa por um ímã simples, e o fim de
curso é o único sensor dela: quem puxa, abre — a qualquer momento. O que o
protocolo controla não é a abertura, é a AUTORIZAÇÃO dela. `porta_liberar`
acende o LED "pode abrir" da placa; aberta com ele aceso, a abertura é
autorizada; aberta antes (ou sem tag), é sem autorização — alarme, e a célula
para do mesmo jeito.

**Firmware:** `porta/porta_nr12/porta_nr12.ino`, com a 4ª cópia de
`apsen_serial.h` — a mesma voz de máquina das outras placas, na mesma USB
(`Serial`) que a bancada. Manual em [`porta/README.md`](../porta/README.md).

### Quem decide o quê

| decisão | quem decide | por quê |
|---|---|---|
| a TAG é válida | a porta (lista local na NVS) | o cadastro é físico, feito na bancada pelo Monitor Serial na USB da porta, com o `porta-adapter` parado |
| a abertura é AUTORIZADA (LED "pode abrir") | o central | só ele sabe se a máquina parou; o LED só acende depois de a CNC e os dispensers confirmarem a parada |
| a máquina PARA | o central, na hora | qualquer porta aberta, pedido de acesso ou link perdido |
| a máquina RETOMA | o central, no `rearme` | fechar a porta não religa nada: a tag é o comando deliberado |

**Sem resposta do central, a abertura não é autorizada.** A porta pede
(`pedido_acesso`), o central para tudo e só então manda `porta_liberar`. A porta espera essa resposta
por `ESPERA_CENTRAL_MS` (5 s) e, sem ela, volta a FECHADA. O número **tem de ser
maior** que `PORTA_PARADA_MAX_S` do central (teto 4 s) mais o trajeto: é um
limite superior, como o `CNC_TETO_TRAJETO_S` — não um fato duplicado.

### Ping, pong e sessão — como nas outras placas

Nada aqui é novo; é a seção 2 aplicada a mais uma placa:

* **a porta inicia o ping** (`{"cmd":"ping","sub":"porta"}`), no boot e a cada
  3 s, e quem responde o `pong` — com `epoch` e `sessao` — é o `porta-adapter`.
  O relógio da porta vem desse `epoch`, e a idempotência do `cmd_id` vem dessa
  `sessao`, exatamente como na balança e na CNC;
* **cabo trocado é detectado como nas outras placas.** O `porta-adapter` abre
  SÓ a COM de `PORTA_SERIAL_URL` (não varre: sem ela, recusa subir) e o
  `serial_link` confere o `sub` de todo ping que chega. Ping de outro `sub`
  nessa COM — a balança ligada no lugar da porta, por exemplo — vira UMA linha
  de ERRO "cabo trocado?" no log do adapter. E a célula não anda: a placa errada
  não emite o `estado` da porta, então o link nunca é declarado ok, e link
  perdido é porta aberta;
* **comando fora deste contrato é ACK negativo** (`comando desconhecido`), nunca
  silêncio.

Todo evento desta seção leva **`"origem":"porta"`**. Hoje ele é redundante — a
COM já diz de quem é a linha —, e fica assim mesmo: o central já filtra por ele,
ele não custa nada, e tirá-lo obrigaria a mudar a rota e o firmware juntos por
ganho nenhum. Os dois de vigia (`porta_link_*`) também o levam: falam da porta,
embora quem os escreva seja o `porta-adapter`.

### Comandos (adapter → placa)

| `cmd` | campos | efeito |
|---|---|---|
| `porta_liberar` | `janela_ms` | autoriza a abertura pela janela e acende o LED "pode abrir" (só em AGUARDANDO_CENTRAL) |
| `porta_negar` | `motivo` | o central recusou o acesso; a porta volta a FECHADA, sem rearme pendente |
| `porta_estado` | — | pede um `estado` imediato (usado na reconexão) |

ACK idempotente como em todo o resto: `cmd_id` repetido é respondido sem
executar. `porta_liberar` fora de AGUARDANDO_CENTRAL é **ACK negativo**
(`sem_pedido_pendente`): autorizar uma porta que não pediu nada seria acender o
"pode abrir" por um comando atrasado.

### Eventos (placa → adapter, dentro de `{"evento":{...}}`)

| `tipo` | campos principais |
|---|---|
| `estado` | `origem`, `teto`, `frente`, `estado`, `aguardando_rearme`, `ts` |
| `pedido_acesso` | `origem`, `uid`, `ts` |
| `tag_negada` | `origem`, `uid`, `ts` |
| `liberada` | `origem`, `janela_ms`, `ts` |
| `liberacao_expirada` | `origem`, `motivo`, `ts` |
| `porta_aberta` | `origem`, `porta`, `autorizada`, `ts` |
| `porta_fechada` | `origem`, `ts` |
| `rearme` | `origem`, `uid`, `ts` |
| `boot` | `origem`, `teto`, `frente`, `ts` |
| `porta_link_perdido` | `origem`, `ts` |
| `porta_link_ok` | `origem`, `ts` |

**Vocabulário fechado:**

* `teto` / `frente` ∈ `aberta`, `fechada` — fio rompido lê `aberta` (falha
  segura);
* `estado` ∈ `FECHADA`, `AGUARDANDO_CENTRAL`, `LIBERADA`, `ABERTA_AUTORIZADA`,
  `ABERTA_SEM_AUTORIZACAO`;
* `porta` ∈ `teto`, `frente`;
* `motivo` da `liberacao_expirada` ∈ `janela_expirou` (liberada e ninguém
  abriu — entra em rearme pendente), `central_nao_respondeu` (nem liberar nem
  negar em `ESPERA_CENTRAL_MS`), ou o `motivo` recebido no `porta_negar`;
* `uid` em hexadecimal maiúsculo, sem separador (`04A1B2C3`) — o formato que o
  sketch de bancada já imprimia.

**`estado` é o heartbeat**, a cada 500 ms, e sai também na hora em toda
transição. `porta_aberta` sai **uma vez por porta**, na transição: se a segunda
abre com a primeira já aberta, sai outra. `porta_fechada` só quando as DUAS
fecharam.

**`porta_link_perdido` e `porta_link_ok` são do `porta-adapter`, não da
porta.** Quem perdeu o link não tem como avisar que o perdeu, então quem vigia
é o lado de cá do cabo. O adapter declara o link **perdido** — UMA vez por
queda — quando:

* a USB da porta caiu (cabo solto, placa reiniciando, COM sumida); ou
* nenhum `estado` chegou há mais de `PORTA_HEARTBEAT_MAX_S` (**2,5 s**, cinco
  heartbeats): a USB está de pé e a placa parou de falar.

E declara o link **ok** só com o primeiro `estado` que chegar depois da volta —
nunca com a USB reaberta sozinha. Ao reabrir a USB, o adapter manda
`porta_estado` para não esperar o próximo heartbeat; o `porta_link_ok` sobe
**antes** do `estado` que o provou. Quem decide o que fazer com isso é o
central: **link perdido é porta aberta**, e a célula para.

**A relação de tempos que continua valendo:** `ESPERA_CENTRAL_MS` da porta
(5 s, gravado na placa) **>** `PORTA_PARADA_MAX_S_TETO` do central (4 s) mais o
trajeto. Mudar o transporte não mexeu em nenhum dos dois números.

### O que o adapter faz com isso

O `porta-adapter` repassa ao central em `POST /api/v1/eventos/porta` — rota
irmã de `/api/v1/eventos/dispenser`, com a mesma política de retry do
`_post_central` dos outros adapters —, **sem interpretar** o conteúdo e na
ordem em que chegou. Comandos descem por `POST /comandos/porta/liberar`
(`janela_ms`), `/comandos/porta/negar` (`motivo`) e `/comandos/porta/estado`:
ACK negativo da porta é 502, porta inalcançável é 503 — os mesmos de todo
adapter. Duas exceções ao "sem interpretar", e as duas são de TRANSPORTE:

* o heartbeat repetido idêntico (ignorando `ts`) não sobe a cada 500 ms: sobe na
  mudança e, no máximo, a cada `PORTA_ESTADO_REENVIO_S` (5 s) como sinal de
  vida — é ele que deixa o central notar um adapter morto;
* o link é UM estado só, somado de duas fontes (a USB da porta e a idade do
  último `estado`), e só a TRANSIÇÃO sobe: `porta_link_perdido` uma vez,
  `porta_link_ok` só depois do primeiro `estado` que chegar com o link de volta.

Ao reabrir a USB da porta, o adapter manda `porta_estado` — sem ele, a placa só
falaria no próximo heartbeat, e o `porta_link_ok` esperaria por nada.

## 10. Porta NR-12 em campo: nr12_oficial + receptor (só leitura)

**Este é O contrato da porta desde 22/10/2026.** O firmware da porta mudou fora
do repositório, e as cópias fiéis do que está gravado nas placas estão em
`porta/nr12_oficial/nr12_oficial.ino` (a ESP da porta) e
`porta/receptor_esp32/receptor_esp32.ino` (a ESP que repassa à USB). As duas
**não são editadas por este repositório**: `tests/test_porta_texto.py` fixa o
sha256 de cada uma e confere o adapter contra elas.

```
ESP da PORTA (nr12_oficial)  ──TX2(17)→RX2(16)──►  ESP RECEPTOR (receptor_esp32)  ──USB (COMx)──►  porta-adapter :8104  ──REST──►  central
RC522 + ES1 teto + ES2 frente                      repassa as linhas, idênticas
decide a tag SOZINHA                               (o fio de volta TX17 só serve
                                                    ao teste manual `T` do receptor)
```

**O PC só LÊ. Nenhum byte desce** — nem à porta, nem ao receptor: não há
`porta_liberar`, `porta_negar`, `porta_estado`, ping, pong, ACK nem `cmd_id`. O
`porta-adapter` abre a COM do receptor (DTR/RTS desligados antes do `open`, a
mesma regra do `serial_link`: abrir do jeito padrão reinicia a ESP), lê linha a
linha e TRADUZ cada linha nos eventos do vocabulário de sempre (seção 9,
"Eventos"), que sobem a `POST /api/v1/eventos/porta` como antes. O central quase
não mudou: ganhou a flag `autorizada_pela_porta` (abaixo).

### Formato das linhas

Toda linha de máquina da porta é

```
EVT:<CODIGO>[;UID=<HEX>] | <texto humano>
```

Só o que vem **antes** de ` | ` é máquina; o texto é para quem lê o Monitor
Serial e pode mudar sem quebrar nada. O `UID` é hexadecimal maiúsculo sem
separador (`04A1B2C3`), o mesmo da seção 9. O adapter tolera espaços, CR e lixo
imprimível ANTES de `EVT:` (o filtro de ruído do receptor descarta só byte não
imprimível) e normaliza o UID para maiúsculas.

Depois de **todo** `ALERTA_*` (e depois do boot) a porta imprime, na mesma volta
do `loop()`, a linha dos fins de curso:

```
   ES1(D4)=FECHADO  ES2(D18)=ABERTO
```

**ES1 = `teto`, ES2 = `frente`.** `FECHADO`/`ABERTO` viram `fechada`/`aberta`.
É ela que diz QUAL porta abriu: o `EVT:ALERTA_*` não diz.

### Tradução: linha → estado da porta → eventos ao central

| linha da porta | estado da porta depois | sobe ao central (nesta ordem) |
|---|---|---|
| `EVT:BOOT_OK` | FECHADA, sem rearme, teto e frente fechadas | `boot` (teto, frente) → `estado` |
| `EVT:ALERTA_SEM_AUTORIZACAO` | ABERTA_SEM_AUTORIZACAO (qual porta: a linha ES) | `porta_aberta` (autorizada false, porta) — um por porta aberta → `estado` |
| `EVT:PAUSA` | LIBERADA, sem rearme, teto e frente fechadas (a porta só libera com as duas fechadas) | `pedido_acesso` (uid, autorizada_pela_porta true) → `liberada` (janela_ms 10000) → `estado` |
| `EVT:ALERTA_PORTA_ABERTA` | ABERTA_AUTORIZADA (qual porta: a linha ES) | `porta_aberta` (autorizada true, porta) — um por porta aberta → `estado` |
| `EVT:LIBERACAO_EXPIRADA` | FECHADA, rearme pendente, teto e frente fechadas | `liberacao_expirada` (motivo janela_expirou) → `estado` |
| `EVT:PORTA_FECHADA` | FECHADA, rearme pendente, teto e frente fechadas | `porta_fechada` → `estado` |
| `EVT:REARME_OK` | FECHADA, sem rearme, teto e frente fechadas | `estado` → `rearme` (uid) |
| `EVT:TAG_NEGADA` | não muda | `tag_negada` (uid) |
| `EVT:REG_INICIO`, `EVT:REG_SALVA`, `EVT:REG_JA_EXISTE`, `EVT:REG_ERRO`, `EVT:REG_CANCELADO`, `EVT:REG_FIM` | não muda | nada — é bancada: log e `/health` |
| linha ES (`ES1(D4)=… ES2(D18)=…`) | teto = ES1, frente = ES2 | completa o `porta_aberta` pendente; `estado` se mudou |

Quatro detalhes que a tabela não mostra:

* **A segunda porta que abre com a primeira já aberta não gera linha.** Nos
  estados ABERTA_* o `nr12_oficial` só olha se as duas fecharam; a segunda
  abertura é muda, e o central só sabe dela pelo `PORTA_FECHADA`. A célula já
  está parada por causa da primeira, então nada de segurança se perde — só a
  linha do histórico.

* **`REARME_OK` sobe o `estado` ANTES do `rearme`.** `_bloqueio_da_retomada`
  confere que a porta está em FECHADA e sem rearme pendente; com o `rearme`
  primeiro, o central o recusaria por um estado velho.
* **O `porta_aberta` espera a linha ES** por até `PORTA_ESPERA_SENSORES_S`
  (0,3 s) — ela sai na mesma volta do `loop()`, a poucos ms. Com as duas portas
  abertas, sobem DOIS `porta_aberta`. Sem a linha no prazo, sobe UM com
  `porta: null`, e o central abre o alarme na fonte `porta` ("porta não
  identificada") em vez de `porta_None`.
* **`liberada` leva `janela_ms: 10000`**, que é o `JANELA_LIBERACAO_MS` gravado
  na porta. O adapter não a mede; ele a declara, para o histórico ter o número.

### O que o receptor imprime sozinho — e o adapter ignora

O receptor repassa cada linha IDÊNTICA, e por conta própria imprime só:

* o banner do boot: `=== RECEPTOR Serial2 | segundo ESP32 ===`,
  `Serial2: RX=GPIO16 (pull-up ON)  TX=GPIO17  baud=115200`,
  `Aguardando mensagens do ESP32 da porta...`, `Comandos: X (hex on/off) | …`;
* as respostas dos comandos de bancada dele, todas começando com `>> `;
* `[linha longa sem fim] …` — linha de mais de 400 bytes sem `\n`, despejada
  crua; e
* `[aviso] Nenhum byte recebido no Serial2 ate agora. …` a cada 5 s, **enquanto
  nada tiver chegado desde o boot do receptor**. Esse o adapter não ignora: ele
  vira o diagnóstico `receptor_sem_dados` no `/health` — o fio porta→receptor
  (TX17→RX16, GND comum) sem dado nenhum.

Nada disso sobe ao central. Qualquer outra linha também não: log DEBUG e um
contador de linhas desconhecidas no `/health`.

### Link, estado sintetizado e estado desconhecido

**A porta não tem heartbeat.** Ela fica MUDA enquanto nada acontece, e a vigia
antiga ("nenhum `estado` em 2,5 s = link perdido") pararia a célula a cada
2,5 s. Por isso:

* **link ok = a USB do receptor aberta E o estado da porta conhecido.** O
  `porta_link_ok` sobe na transição, ANTES dos eventos da linha que a provou;
  a USB que cai sobe `porta_link_perdido` UMA vez e o adapter esquece o estado;
* **o `estado` é SINTETIZADO pelo adapter**, a partir do modelo dele (`estado`,
  `aguardando_rearme`, `teto`, `frente`, e `"fonte": "adapter"`). Sobe depois de
  cada transição e é reenviado a cada `PORTA_ESTADO_REENVIO_S` (5 s) enquanto o
  link está ok — é isso que satisfaz a vigia de silêncio do central
  (`PORTA_SILENCIO_MAX_S`), que existe para notar o ADAPTER morto;
* **o estado começa DESCONHECIDO.** Não há como perguntar à porta. Ao subir o
  adapter — ou ao voltar a USB do receptor — nada sobe até chegar uma linha
  que PROVE o estado: `BOOT_OK`, `PAUSA`, `LIBERACAO_EXPIRADA`, `PORTA_FECHADA`,
  `REARME_OK` ou um `ALERTA_*`. `TAG_NEGADA` e `REG_*` não provam nada, e com o
  estado desconhecido também não sobem.

Com `PORTA_NR12_HABILITADA=1` o central nasce em pausa por link perdido ("porta
que nunca falou é porta aberta"), então o **ritual de subida** é:

1. **passar a tag** — `EVT:PAUSA` prova as duas portas fechadas, e o link fica ok;
2. **esperar os 10 s** (`LIBERACAO_EXPIRADA`) **ou abrir e fechar** (`PORTA_FECHADA`)
   — a porta entra em rearme pendente;
3. **passar a tag de novo** — `EVT:REARME_OK`; a célula faz homing e retoma.

Reiniciar a ESP da porta (`EVT:BOOT_OK`, com as duas fechadas) também prova o
estado, e retoma sozinho pela regra de sempre do link perdido sem porta aberta
no meio.

### O ponto cego

**ESP da porta travada, ou o fio TX2→RX2 rompido, COM a porta parada, NÃO é
detectável.** Silêncio é o normal desta porta, e o próximo evento real (uma tag,
uma abertura) também não chega — a célula seguiria rodando com uma porta que
ninguém escuta. A USB do receptor de pé não prova nada sobre a porta: o receptor
continua vivo e calado. Não há como fechar isso sem regravar a porta; a correção
futura (fora deste escopo) é ela emitir uma linha de vida periódica — por
exemplo `EVT:VIVO` a cada segundo — e o adapter voltar a vigiar a idade dela.
Enquanto isso, **um teste de tag antes de começar** confirma que o caminho
inteiro está vivo.

### A autorização é da PORTA

A tag cadastrada acende o LED "pode abrir" e manda `EVT:PAUSA` **ao mesmo
tempo**: o central não tem mais como segurar a autorização até a máquina
confirmar a parada, porque não manda nada à porta. Ele recebe
`pedido_acesso` com **`autorizada_pela_porta: true`**, entra em pausa e PARA
(CNC e dispensers, em `gather`) — e não manda `porta_liberar` nem
`porta_negar`. Parada não confirmada em `PORTA_PARADA_MAX_S` vira o alarme
`maquina_nao_confirmou_parada`, dizendo que a porta já tinha autorizado a
abertura. Pausa, retomada, rearme, histórico, alarmes e faixa seguem iguais.

O único `/comandos/porta/*` que o central ainda chama é `porta/estado`, no
rearme recusado: o adapter o atende **reenviando o `estado` do modelo**, sem
tocar na serial (503 com o estado desconhecido). `porta/liberar` e `porta/negar`
respondem **409** — se o central voltar a chamá-los, o erro aparece em vez de um
ACK falso.

**Cadastro de tag** (`R`/`S`/`C`/`L`) é na USB **da porta**, com notebook e
Monitor Serial, na bancada: as tags moram na NVS dela. O mini PC e o
`porta-adapter` não participam.
