jdszza/valoryapsen/docs/APSEN_Referencia_APIs.docx

Sistema APSEN

Referência de APIs e rotas

Célula automatizada de contagem e dispensação de medicamentos — Valory / APSEN Farmacêutica.

12 serviços HTTP · 192 rotas documentadas

Gerado a partir do código do repositório valoryapsen em 18/10/2026 (commit ab59406 + alterações locais), extraindo o OpenAPI de cada serviço FastAPI e o mapa de rotas do painel Flask.

# Sumário

Se o sumário aparecer vazio, clique com o botão direito sobre ele e escolha "Atualizar campo".

# 1. Visão geral

Toda a comunicação entre os serviços é REST/HTTP (JSON), mais um WebSocket do central para as telas. As placas ESP32 falam serial com os adapters, que traduzem para REST — a parte serial está em docs/PROTOCOLO_SERIAL.md e não faz parte deste documento.

O fluxo de uma ação física é sempre o mesmo: o central chama POST /comandos/* no adapter; o adapter repassa à placa (ou ao simulador, via /executar/*) e responde assim que ela ACEITA o comando; o resultado chega depois, como evento assíncrono que o adapter envia ao central em POST /api/v1/eventos/<subsistema>.

Serviço | Porta | Onde roda | Tecnologia | Rotas
Computador Central (central-computer) | 8000 | Container Docker | FastAPI | 61
Dispenser Adapter | 8100 | Host Windows (serial) ou container com profile simulado | FastAPI | 11
CNC Adapter | 8101 | Host Windows (serial) ou container com profile simulado | FastAPI | 8
Vision Adapter | 8102 | Container Docker | FastAPI | 9
Weight Adapter | 8103 | Host Windows (serial) ou container com profile simulado | FastAPI | 12
CNC Simulator | 8200 | Container (profile simulado) | FastAPI | 7
Dispenser Simulator | 8201 | Container (profile simulado) | FastAPI | 8
Vision Simulator | 8202 | Container Docker | FastAPI | 4
Weight Simulator | 8203 | Container (profile simulado / balanca-simulada) | FastAPI | 5
Estação de visão da mesa (visao_mesa) | 8212 | Host Windows (dona da webcam) | FastAPI | 4
Estações de visão dos dispensers (visao) | 8301 (esq, D1–D4) / 8302 (dir, D5–D8) | Host Windows (donas das webcams) | http.server (biblioteca padrão) | 6
Painel de bancada (painel_operador) | 5000 | Host Windows da bancada (dono da serial do display 7") | Flask + SQLite (waitress) | 57

## Serviços sem API REST

Serviço | Porta | O que é
dashboard | 8050 | Painel Dash read-only. Consome GET /estado, /log/eventos, /os/historico e /alarmes do central.
manut_web | 8051 | App de manutenção (Dash). Fala com o central server-side, com JWT.
erp-simulator | — | Worker sem porta: dispara as ordens padrão em POST /api/v1/ordens e respeita /api/v1/fila e /api/v1/gerador.
mysql | 3306 (127.0.0.1) | Banco do central. Schema definido em central-computer/database.py.

## Convenções

Autenticação do central: JWT Bearer obtido em POST /auth/login (8 h). A role é revalidada no banco a cada requisição. Rotas de leitura, eventos dos adapters e o fluxo de OS não exigem token (rede interna).

Console de operação: Rotas /console* usam cookie de sessão próprio (CONSOLE_SENHA). Sem a variável, respondem 503. Não aparecem no Swagger (include_in_schema=False).

Painel de bancada: Páginas web exigem login (nome + PIN) e permissão por perfil; o bloco /api/* exige o header X-API-Token (APSEN_API_TOKEN) e responde 503 se o token não estiver configurado.

Erros comuns: 422 = corpo ou parâmetro inválido (FastAPI); 502 = a placa recusou o comando (ACK negativo); 503 = placa/serviço inalcançável; 409 = conflito de estado (ex.: OS duplicada, slot em operação); 429 = fila de OS cheia.

Swagger ao vivo: Cada serviço FastAPI publica o seu em http://localhost:<porta>/docs (spec em /openapi.json). Ele é gerado do código em execução — reconstrua o container antes de conferir.

Eventos: Os corpos de POST /eventos e /api/v1/eventos/* aceitam campos adicionais além dos listados: o payload da placa atravessa o adapter sem interpretação.

# 2. Computador Central (central-computer)

Orquestrador: recebe as OS do ERP, decide slots e rota, comanda os adapters, aplica o Triple Check, persiste no MySQL e publica o estado ao vivo (WebSocket /ws).

Porta: 8000

Onde roda: Container Docker

Tecnologia: FastAPI

Base URL: http://localhost:8000

Swagger: http://localhost:8000/docs

Método | Rota | Grupo
POST | /api/v1/ordens | Ordens de Serviço
GET | /api/v1/fila | Ordens de Serviço
GET | /api/v1/gerador | Ordens de Serviço
GET | /api/v1/ordens/templates | Ordens de Serviço
GET | /os/ativa | Ordens de Serviço
GET | /os/historico | Ordens de Serviço
GET | /os/{os_id} | Ordens de Serviço
GET | /api/v1/relatorio/os/{os_id} | Ordens de Serviço
PUT | /ordens/{os_id}/status | Ordens de Serviço
POST | /api/v1/eventos/dispenser | Eventos dos Adapters
POST | /api/v1/eventos/cnc | Eventos dos Adapters
POST | /api/v1/eventos/porta | Eventos dos Adapters
POST | /api/v1/eventos/visao | Eventos dos Adapters
POST | /api/v1/eventos/peso | Eventos dos Adapters
GET | /ping | Saúde
GET | /estado | Estado e Telemetria
GET | /api/v1/visao/historico | Estado e Telemetria
GET | /dispensas | Estado e Telemetria
GET | /dispensers/estado | Estado e Telemetria
GET | /cnc/historico | Estado e Telemetria
GET | /alarmes | Estado e Telemetria
GET | /log/eventos | Estado e Telemetria
GET | /medicamentos | Catálogo
GET | /medicamentos/categorias | Catálogo
POST | /auth/login | Autenticação
GET | /auth/me | Autenticação
GET | /manutencao/necessidades | Manutenção
GET | /manutencao/sensores | Manutenção
GET | /manutencao/sensores/{componente} | Manutenção
GET | /manutencao/log | Manutenção
POST | /manutencao/log | Manutenção
GET | /manutencao/alarmes | Manutenção
PUT | /manutencao/alarmes/{alarme_id}/resolver | Manutenção
POST | /manutencao/dispensers/{dispenser_id}/limpar | Manutenção
GET | /api/v1/porta | Porta NR-12
GET | /api/v1/porta/historico | Porta NR-12
GET | /api/v1/caixa | Caixa de coleta
GET | /api/v1/trava | Triple Check
POST | /api/v1/admin/liberar-trava | Triple Check
GET | /manutencao/usuarios | Usuários
POST | /manutencao/usuarios | Usuários
PUT | /manutencao/usuarios/{username} | Usuários
PUT | /manutencao/usuarios/{username}/desativar | Usuários
PUT | /manutencao/usuarios/{username}/ativar | Usuários
GET | /console | Console de operação (fora do Swagger)
GET | /console/login | Console de operação (fora do Swagger)
POST | /console/login | Console de operação (fora do Swagger)
POST | /console/logout | Console de operação (fora do Swagger)
POST | /console/api/disparar | Console de operação (fora do Swagger)
POST | /console/api/gerador | Console de operação (fora do Swagger)
POST | /console/api/liberar-trava | Console de operação (fora do Swagger)
POST | /console/api/cancelar-espera-caixa | Console de operação (fora do Swagger)
POST | /console/api/reenviar-centro | Console de operação (fora do Swagger)
GET | /console/api/injecao | Console de operação (fora do Swagger)
POST | /console/api/injecao | Console de operação (fora do Swagger)
POST | /console/api/injecao/desarmar | Console de operação (fora do Swagger)
POST | /console/api/reset | Console de operação (fora do Swagger)
POST | /console/api/seed | Console de operação (fora do Swagger)
GET | /console/prevoo | Console de operação (fora do Swagger)
GET | /console/api/prevoo | Console de operação (fora do Swagger)
WS | /ws | WebSocket

## Ordens de Serviço

### POST /api/v1/ordens

Recebe nova OS do erp-simulator.

Autenticação: Nenhuma

Corpo JSON (NovaOSReq)

Campo | Tipo | Obrig. | Padrão
os_id | string | sim
descricao | string | não
categoria | string | não
medicamentos | array de qualquer | sim
template_id | string | não

Respostas

Código | Significado
200 | Sucesso.
409 | OS já registrada (os_duplicada). O reenvio NÃO é reprocessado.
429 | Fila cheia (fila_cheia). Nada é persistido — a recusa vem ANTES do INSERT.
503 | Banco indisponível (persistencia_indisponivel). A OS não entra na fila.
422 | Corpo ou parâmetros inválidos (validação do FastAPI).

### GET /api/v1/fila

Ocupação da fila de OS — endpoint de backpressure do erp-simulator.

Autenticação: Nenhuma

Respostas

Código | Significado
200 | Sucesso.

### GET /api/v1/gerador

Interruptor do erp-simulator — ele consulta ANTES de cada envio.

Autenticação: Nenhuma

Respostas

Código | Significado
200 | Sucesso.

### GET /api/v1/ordens/templates

As 10 Ordens de Saída padrão, com os itens enriquecidos pelo catálogo.

Autenticação: Nenhuma

Respostas

Código | Significado
200 | Sucesso.

### GET /os/ativa

OS em execução no momento (ou a próxima da fila, se nenhuma estiver rodando).

Autenticação: Nenhuma

Respostas

Código | Significado
200 | Sucesso.

### GET /os/historico

Histórico das últimas OS, mais recentes primeiro. limite é limitado à faixa 1..500.

Autenticação: Nenhuma

Parâmetros

Nome | Em | Tipo | Obrig. | Padrão
limite | query | integer | não | 50

Respostas

Código | Significado
200 | Sucesso.
422 | Corpo ou parâmetros inválidos (validação do FastAPI).

### GET /os/{os_id}

Detalhe de uma OS: cabeçalho, itens e quantidades esperadas/reais.

Autenticação: Nenhuma

Parâmetros

Nome | Em | Tipo | Obrig. | Padrão
os_id | caminho | string | sim

Respostas

Código | Significado
200 | Sucesso.
404 | OS não encontrada.
422 | Corpo ou parâmetros inválidos (validação do FastAPI).

### GET /api/v1/relatorio/os/{os_id}

Exporta relatório completo de uma OS em CSV ou XLSX.

Autenticação: JWT Bearer (qualquer usuário ativo)

Parâmetros

Nome | Em | Tipo | Obrig. | Padrão
os_id | caminho | string | sim
formato | query | string | não | "csv"

Respostas

Código | Significado
200 | CSV (default) ou XLSX, conforme formato.
401 | Token ausente ou inválido.
404 | OS não encontrada.
422 | Corpo ou parâmetros inválidos (validação do FastAPI).

### PUT /ordens/{os_id}/status

Altera o status gravado de uma OS no banco. Não fala com o orquestrador — é correção administrativa de registro.

Autenticação: JWT Bearer (qualquer usuário ativo)

Parâmetros

Nome | Em | Tipo | Obrig. | Padrão
os_id | caminho | string | sim

Corpo JSON (StatusOSReq)

Campo | Tipo | Obrig. | Padrão
status | string | sim

Respostas

Código | Significado
200 | Sucesso.
422 | Corpo ou parâmetros inválidos (validação do FastAPI).

## Eventos dos Adapters

### POST /api/v1/eventos/dispenser

Recebe eventos normalizados do dispenser-adapter.

Autenticação: Nenhuma

Corpo JSON (EventoDispenserReq)

Campo | Tipo | Obrig. | Padrão
tipo | string | sim
dispenser_id | integer | null | não
os_id | string | null | não

Aceita campos adicionais, repassados sem interpretação.

Respostas

Código | Significado
200 | Sucesso.
422 | Corpo ou parâmetros inválidos (validação do FastAPI).

### POST /api/v1/eventos/cnc

Recebe eventos normalizados do cnc-adapter.

Autenticação: Nenhuma

Corpo JSON (EventoCNCReq)

Campo | Tipo | Obrig. | Padrão
tipo | string | sim
os_id | string | null | não
dispenser_alvo | integer | null | não

Aceita campos adicionais, repassados sem interpretação.

Respostas

Código | Significado
200 | Sucesso.
422 | Corpo ou parâmetros inválidos (validação do FastAPI).

### POST /api/v1/eventos/porta

Eventos da porta NR-12 — rota irmã da dos dispensers (§9 do protocolo).

Autenticação: Nenhuma

Corpo JSON (EventoPortaReq)

Campo | Tipo | Obrig. | Padrão
tipo | string | sim
origem | string | null | não

Aceita campos adicionais, repassados sem interpretação.

Respostas

Código | Significado
200 | Sucesso.
422 | Corpo ou parâmetros inválidos (validação do FastAPI).

### POST /api/v1/eventos/visao

Recebe resultados de captura do vision-adapter (câmera dispenser e câmera mesa).

Autenticação: Nenhuma

Corpo JSON (EventoVisionReq)

Campo | Tipo | Obrig. | Padrão
tipo | string | sim
camera | string | sim
slot_id | integer | null | não
os_id | string | null | não

Aceita campos adicionais, repassados sem interpretação.

Respostas

Código | Significado
200 | Sucesso.
422 | Corpo ou parâmetros inválidos (validação do FastAPI).

### POST /api/v1/eventos/peso

Recebe leituras de pesagem do weight-adapter (balança HX711).

Autenticação: Nenhuma

Corpo JSON (EventoPesoReq)

Campo | Tipo | Obrig. | Padrão
tipo | string | sim
os_id | string | null | não
slot_id | integer | null | não

Aceita campos adicionais, repassados sem interpretação.

Respostas

Código | Significado
200 | Sucesso.
422 | Corpo ou parâmetros inválidos (validação do FastAPI).

## Saúde

### GET /ping

Liveness: o processo está de pé. É o healthcheck do compose — não consulta banco nem adapters.

Autenticação: Nenhuma

Respostas

Código | Significado
200 | Sucesso.

## Estado e Telemetria

### GET /estado

Snapshot completo do estado da célula em memória (OS ativa, dispensers, CNC, visão, peso, trava, porta, fila, alarmes ativos). Mesmo payload publicado pelo WebSocket /ws.

Autenticação: Nenhuma

Respostas

Código | Significado
200 | Sucesso.

### GET /api/v1/visao/historico

Retorna histórico de leituras de visão computacional. Filtra por os_id se fornecido.

Autenticação: Nenhuma

Parâmetros

Nome | Em | Tipo | Obrig. | Padrão
os_id | query | string | não
limite | query | integer | não | 100

Respostas

Código | Significado
200 | Sucesso.
422 | Corpo ou parâmetros inválidos (validação do FastAPI).

### GET /dispensas

Registros de dispensa (slot, medicamento, quantidade), com filtro opcional por OS.

Autenticação: Nenhuma

Parâmetros

Nome | Em | Tipo | Obrig. | Padrão
os_id | query | string | não
limite | query | integer | não | 100

Respostas

Código | Significado
200 | Sucesso.
422 | Corpo ou parâmetros inválidos (validação do FastAPI).

### GET /dispensers/estado

Estado de cada slot de dispenser (medicamento, quantidade, status, OS dona). É a fonte do espelho do painel de bancada.

Autenticação: Nenhuma

Respostas

Código | Significado
200 | Sucesso.

### GET /cnc/historico

Eventos de transição da mesa CNC (posicionado, concluído, erro).

Autenticação: Nenhuma

Parâmetros

Nome | Em | Tipo | Obrig. | Padrão
limite | query | integer | não | 50

Respostas

Código | Significado
200 | Sucesso.
422 | Corpo ou parâmetros inválidos (validação do FastAPI).

### GET /alarmes

Alarmes, filtráveis por resolvido/não resolvido.

Autenticação: Nenhuma

Parâmetros

Nome | Em | Tipo | Obrig. | Padrão
resolvido | query | boolean | não | false
limite | query | integer | não | 50

Respostas

Código | Significado
200 | Sucesso.
422 | Corpo ou parâmetros inválidos (validação do FastAPI).

### GET /log/eventos

Últimos eventos recebidos dos adapters (log em memória lido pelo dashboard).

Autenticação: Nenhuma

Parâmetros

Nome | Em | Tipo | Obrig. | Padrão
limite | query | integer | não | 50

Respostas

Código | Significado
200 | Sucesso.
422 | Corpo ou parâmetros inválidos (validação do FastAPI).

## Catálogo

### GET /medicamentos

Catálogo de medicamentos (nome, SKU, categoria, peso unitário), com filtro opcional por categoria.

Autenticação: Nenhuma

Parâmetros

Nome | Em | Tipo | Obrig. | Padrão
categoria | query | string | não

Respostas

Código | Significado
200 | Sucesso.
422 | Corpo ou parâmetros inválidos (validação do FastAPI).

### GET /medicamentos/categorias

Lista das categorias existentes no catálogo.

Autenticação: Nenhuma

Respostas

Código | Significado
200 | Sucesso.

## Autenticação

### POST /auth/login

Emite o JWT de 8h. Com freio de força bruta, o mesmo do console.

Autenticação: Nenhuma

Corpo JSON (LoginReq)

Campo | Tipo | Obrig. | Padrão
username | string | sim
senha | string | sim

Respostas

Código | Significado
200 | Sucesso.
401 | Credenciais inválidas.
429 | Tentativas demais desta origem para este usuário.
422 | Corpo ou parâmetros inválidos (validação do FastAPI).

### GET /auth/me

Dados do usuário autenticado (username, nome e role revalidada no banco).

Autenticação: JWT Bearer (qualquer usuário ativo)

Respostas

Código | Significado
200 | Sucesso.

## Manutenção

### GET /manutencao/necessidades

O que precisa de atenção, numa lista priorizada. Ver necessidades.py.

Autenticação: JWT Bearer (qualquer usuário ativo)

Respostas

Código | Significado
200 | Sucesso.

### GET /manutencao/sensores

Última leitura de cada sensor/componente (temperatura, desgaste, horas de uso).

Autenticação: JWT Bearer (qualquer usuário ativo)

Respostas

Código | Significado
200 | Sucesso.

### GET /manutencao/sensores/{componente}

Série histórica de um componente, por tipo de leitura.

Autenticação: JWT Bearer (qualquer usuário ativo)

Parâmetros

Nome | Em | Tipo | Obrig. | Padrão
componente | caminho | string | sim
tipo | query | string | não | "temperatura"
limite | query | integer | não | 60

Respostas

Código | Significado
200 | Sucesso.
422 | Corpo ou parâmetros inválidos (validação do FastAPI).

### GET /manutencao/log

Log de manutenção: quem mexeu no equipamento, quando e o quê.

Autenticação: JWT Bearer (qualquer usuário ativo)

Parâmetros

Nome | Em | Tipo | Obrig. | Padrão
limite | query | integer | não | 100

Respostas

Código | Significado
200 | Sucesso.
422 | Corpo ou parâmetros inválidos (validação do FastAPI).

### POST /manutencao/log

Registra uma intervenção de manutenção no log, em nome do técnico autenticado.

Autenticação: JWT Bearer (qualquer usuário ativo)

Corpo JSON (ManutencaoReq)

Campo | Tipo | Obrig. | Padrão
tipo | string | sim
componente | string | sim
descricao | string | sim

Respostas

Código | Significado
200 | Sucesso.
422 | Corpo ou parâmetros inválidos (validação do FastAPI).

### GET /manutencao/alarmes

Alarmes para o app de manutenção, filtráveis por resolvido.

Autenticação: JWT Bearer (qualquer usuário ativo)

Parâmetros

Nome | Em | Tipo | Obrig. | Padrão
resolvido | query | boolean | não | false
limite | query | integer | não | 100

Respostas

Código | Significado
200 | Sucesso.
422 | Corpo ou parâmetros inválidos (validação do FastAPI).

### PUT /manutencao/alarmes/{alarme_id}/resolver

Marca um alarme como resolvido (o badge de alarmes ativos é recalculado na hora).

Autenticação: JWT Bearer (qualquer usuário ativo)

Parâmetros

Nome | Em | Tipo | Obrig. | Padrão
alarme_id | caminho | integer | sim

Respostas

Código | Significado
200 | Sucesso.
422 | Corpo ou parâmetros inválidos (validação do FastAPI).

### POST /manutencao/dispensers/{dispenser_id}/limpar

Envia comando de limpeza ao dispenser-adapter. Bloqueado se slot está em operação.

Autenticação: JWT Bearer (qualquer usuário ativo)

Parâmetros

Nome | Em | Tipo | Obrig. | Padrão
dispenser_id | caminho | integer | sim

Respostas

Código | Significado
200 | Sucesso.
400 | dispenser_id fora da faixa de slots da célula.
401 | Token ausente, inválido, ou usuário desativado no banco.
409 | OS em andamento, ou slot em operação física (carregando/dispensando).
503 | Dispenser-adapter indisponível.
422 | Corpo ou parâmetros inválidos (validação do FastAPI).

## Porta NR-12

### GET /api/v1/porta

Estado da porta NR-12 e da pausa da célula, e a FAIXA que o operador vê.

Autenticação: Nenhuma

Respostas

Código | Significado
200 | Sucesso.

### GET /api/v1/porta/historico

Histórico de eventos da porta NR-12 (pedido, liberação, abertura, fechamento, rearme, tag negada, link).

Autenticação: Nenhuma

Parâmetros

Nome | Em | Tipo | Obrig. | Padrão
limite | query | integer | não | 100

Respostas

Código | Significado
200 | Sucesso.
422 | Corpo ou parâmetros inválidos (validação do FastAPI).

## Caixa de coleta

### GET /api/v1/caixa

A etapa da caixa de coleta no HOME e a FAIXA que o operador vê.

Autenticação: Nenhuma

Respostas

Código | Significado
200 | Sucesso.

## Triple Check

### GET /api/v1/trava

Retorna estado atual da trava de Triple Check.

Autenticação: Nenhuma

Respostas

Código | Significado
200 | Sucesso.

### POST /api/v1/admin/liberar-trava

Libera a trava de Triple Check. Exige role admin ou supervisor. A OS retoma de onde parou após a liberação.

Autenticação: JWT Bearer — role admin ou supervisor

Corpo JSON (LiberarTravaReq) — opcional

Campo | Tipo | Obrig. | Padrão
em_nome_de | string | null | não

Respostas

Código | Significado
200 | Sucesso.
401 | Token ausente, inválido, ou usuário desativado no banco.
403 | Requer role admin ou supervisor (a role vem do banco, não do token).
409 | Nenhuma trava ativa no momento.
422 | Corpo ou parâmetros inválidos (validação do FastAPI).

## Usuários

### GET /manutencao/usuarios

Lista os usuários do app de manutenção.

Autenticação: JWT Bearer — role admin

Respostas

Código | Significado
200 | Sucesso.

### POST /manutencao/usuarios

Cria usuário. Role deve ser admin, supervisor ou manutencao (outra = 400).

Autenticação: JWT Bearer — role admin

Corpo JSON (UsuarioReq)

Campo | Tipo | Obrig. | Padrão
username | string | sim
senha | string | sim
nome_completo | string | sim
role | string | não | "manutencao"

Respostas

Código | Significado
200 | Sucesso.
400 | role fora de ROLES_VALIDAS — nada é gravado.
422 | Corpo ou parâmetros inválidos (validação do FastAPI).

### PUT /manutencao/usuarios/{username}

Edita nome, senha ou role de um usuário. Invalida o cache de autenticação na hora.

Autenticação: JWT Bearer — role admin

Parâmetros

Nome | Em | Tipo | Obrig. | Padrão
username | caminho | string | sim

Corpo JSON (UsuarioUpdateReq)

Campo | Tipo | Obrig. | Padrão
nome_completo | string | null | não
role | string | null | não
nova_senha | string | null | não

Respostas

Código | Significado
200 | Sucesso.
422 | Corpo ou parâmetros inválidos (validação do FastAPI).

### PUT /manutencao/usuarios/{username}/desativar

Desativa o usuário — o acesso cai na próxima requisição, sem esperar o token expirar.

Autenticação: JWT Bearer — role admin

Parâmetros

Nome | Em | Tipo | Obrig. | Padrão
username | caminho | string | sim

Respostas

Código | Significado
200 | Sucesso.
422 | Corpo ou parâmetros inválidos (validação do FastAPI).

### PUT /manutencao/usuarios/{username}/ativar

Reativa um usuário desativado.

Autenticação: JWT Bearer — role admin

Parâmetros

Nome | Em | Tipo | Obrig. | Padrão
username | caminho | string | sim

Respostas

Código | Significado
200 | Sucesso.
422 | Corpo ou parâmetros inválidos (validação do FastAPI).

## Console de operação (fora do Swagger)

### GET /console

Página HTML do console de operação (exige sessão do console).

Autenticação: Cookie de sessão do console (CONSOLE_SENHA)

### GET /console/login

Página de login do console.

Autenticação: Nenhuma (é o login)

### POST /console/login

Confere a senha e emite o cookie de sessão.

Autenticação: Nenhuma (é o login)

### POST /console/logout

Encerra a sessão do console (apaga o cookie).

Autenticação: Cookie de sessão do console (CONSOLE_SENHA)

### POST /console/api/disparar

Dispara UMA das ordens padrão, pelo mesmo caminho do erp-simulator.

Autenticação: Cookie de sessão do console (CONSOLE_SENHA)

Corpo JSON

Campo | Tipo | Obrig. | Padrão
template_id | string | sim

### POST /console/api/gerador

Pausa ou retoma o erp-simulator (ver GET /api/v1/gerador).

Autenticação: Cookie de sessão do console (CONSOLE_SENHA)

Corpo JSON

Campo | Tipo | Obrig. | Padrão
pausado | boolean | sim

### POST /console/api/liberar-trava

Libera a trava do Triple Check sem passar pelo app de manutenção.

Autenticação: Cookie de sessão do console (CONSOLE_SENHA)

### POST /console/api/cancelar-espera-caixa

Encerra a OS que espera a caixa de coleta esvaziar — cancelada.

Autenticação: Cookie de sessão do console (CONSOLE_SENHA)

### POST /console/api/reenviar-centro

Manda de novo a mesa ao centro, depois de um cnc_nao_chegou_ao_centro.

Autenticação: Cookie de sessão do console (CONSOLE_SENHA)

### GET /console/api/injecao

Tipos que dá para armar + o gatilho em vigor.

Autenticação: Cookie de sessão do console (CONSOLE_SENHA)

### POST /console/api/injecao

Arma a próxima falha. Substitui o gatilho anterior, se houver.

Autenticação: Cookie de sessão do console (CONSOLE_SENHA)

Corpo JSON

Campo | Tipo | Obrig. | Padrão
tipo | string | sim
slot_id | integer | sim

### POST /console/api/injecao/desarmar

Desarma sem consumir. 409 quando não havia nada armado.

Autenticação: Cookie de sessão do console (CONSOLE_SENHA)

### POST /console/api/reset

Devolve a bancada ao estado de boot, comandando limpeza REAL nos slots.

Autenticação: Cookie de sessão do console (CONSOLE_SENHA)

Corpo JSON

Campo | Tipo | Obrig. | Padrão
limpar_historico | boolean | não | false

### POST /console/api/seed

Semeia histórico de DEMONSTRAÇÃO — ordens, dispensas, alarmes, leituras.

Autenticação: Cookie de sessão do console (CONSOLE_SENHA)

Corpo JSON

Campo | Tipo | Obrig. | Padrão
n_ordens | integer | não | 40
dias | integer | não | 7

### GET /console/prevoo

Página do pré-voo. Tela própria, e não mais um painel no console.

Autenticação: Cookie de sessão do console (CONSOLE_SENHA)

### GET /console/api/prevoo

O relatório, item a item. Nunca levanta por causa de um serviço fora.

Autenticação: Cookie de sessão do console (CONSOLE_SENHA)

## WebSocket

### WS /ws

Snapshot na conexão e, daí em diante, o que _broadcast_estado publicar. O payload de cada mensagem é o mesmo de GET /estado.

Autenticação: Nenhuma

# 3. Dispenser Adapter

Tradutor REST ↔ serial das duas placas do dispenser (mecanismos e 8 telas TFT). Hoje também carrega os comandos da porta NR-12.

Porta: 8100

Onde roda: Host Windows (serial) ou container com profile simulado

Tecnologia: FastAPI

Base URL: http://localhost:8100

Swagger: http://localhost:8100/docs

Método | Rota | Grupo
GET | /ping | Saúde e diagnóstico
GET | /health | Saúde e diagnóstico
POST | /comandos/carregar | Comandos
POST | /comandos/dispensar | Comandos
POST | /comandos/limpar | Comandos
POST | /comandos/parar | Comandos
POST | /comandos/estado-celula | Comandos
POST | /eventos | Eventos (subida ao central)
POST | /comandos/porta/liberar | Porta NR-12
POST | /comandos/porta/negar | Porta NR-12
POST | /comandos/porta/estado | Porta NR-12

## Saúde e diagnóstico

### GET /ping

Liveness: o processo está de pé. Usado como healthcheck; não consulta hardware nem outros serviços.

Autenticação: Nenhuma

Respostas

Código | Significado
200 | Sucesso.

### GET /health

Diagnóstico: conectividade com o central e com a ponta de baixo.

Autenticação: Nenhuma

Respostas

Código | Significado
200 | Sucesso.

## Comandos

### POST /comandos/carregar

Carrega um slot com medicamento e quantidade para a OS. A confirmação chega como evento carregado.

Autenticação: Nenhuma

Corpo JSON (ComandoCarregarReq)

Campo | Tipo | Obrig. | Padrão
dispenser_id | integer | sim
medicamento | string | sim
sku | string | não
categoria | string | não
quantidade | integer | sim
os_id | string | sim

Respostas

Código | Significado
200 | Sucesso.
422 | Corpo ou parâmetros inválidos (validação do FastAPI).

### POST /comandos/dispensar

Solta N unidades do slot na caixa de coleta. Aceita injetar_falha (repassado cru). O resultado chega como dispensado.

Autenticação: Nenhuma

Corpo JSON (ComandoDispensarReq)

Campo | Tipo | Obrig. | Padrão
dispenser_id | integer | sim
os_id | string | sim
injetar_falha | string | null | não
quantidade | integer | null | não

Respostas

Código | Significado
200 | Sucesso.
422 | Corpo ou parâmetros inválidos (validação do FastAPI).

### POST /comandos/limpar

Esvazia/libera o slot. A confirmação chega como limpeza_ok.

Autenticação: Nenhuma

Corpo JSON (ComandoLimparReq)

Campo | Tipo | Obrig. | Padrão
dispenser_id | integer | sim
solicitado_por | string | não | "sistema"

Respostas

Código | Significado
200 | Sucesso.
422 | Corpo ou parâmetros inválidos (validação do FastAPI).

### POST /comandos/parar

A dispensa em curso termina a unidade atual e para (porta NR-12).

Autenticação: Nenhuma

Corpo JSON (ComandoPararReq)

Campo | Tipo | Obrig. | Padrão
motivo | string | não | "porta_aberta"

Respostas

Código | Significado
200 | Sucesso.
422 | Corpo ou parâmetros inválidos (validação do FastAPI).

### POST /comandos/estado-celula

estado_celula vai SÓ para a placa das telas.

Autenticação: Nenhuma

Corpo JSON (EstadoCelulaReq)

Campo | Tipo | Obrig. | Padrão
trava_ativa | boolean | sim
trava_slot_id | integer | null | não
os_id | string | não
trava_resumo | string | não
pausa_porta | boolean | null | não
pausa_resumo | string | não

Respostas

Código | Significado
200 | Sucesso.
422 | Corpo ou parâmetros inválidos (validação do FastAPI).

## Eventos (subida ao central)

### POST /eventos

Recebe eventos normalizados do dispenser-simulator e os repassa ao Central.

Autenticação: Nenhuma

Corpo JSON (EventoReq)

Campo | Tipo | Obrig. | Padrão
tipo | string | sim
dispenser_id | integer | null | não
os_id | string | null | não

Aceita campos adicionais, repassados sem interpretação.

Respostas

Código | Significado
200 | Sucesso.
422 | Corpo ou parâmetros inválidos (validação do FastAPI).

## Porta NR-12

### POST /comandos/porta/liberar

Autoriza a abertura da porta NR-12 (acende o LED "pode abrir"). Enviado pelo central depois de confirmar a parada da máquina.

Autenticação: Nenhuma

Corpo JSON (PortaLiberarReq)

Campo | Tipo | Obrig. | Padrão
janela_ms | integer | sim

Respostas

Código | Significado
200 | Sucesso.
422 | Corpo ou parâmetros inválidos (validação do FastAPI).

### POST /comandos/porta/negar

Nega o pedido de acesso da porta NR-12 (máquina não confirmou a parada).

Autenticação: Nenhuma

Corpo JSON (PortaNegarReq)

Campo | Tipo | Obrig. | Padrão
motivo | string | sim

Respostas

Código | Significado
200 | Sucesso.
422 | Corpo ou parâmetros inválidos (validação do FastAPI).

### POST /comandos/porta/estado

Pede à placa da porta que publique o estado atual (estado).

Autenticação: Nenhuma

Respostas

Código | Significado
200 | Sucesso.

# 4. CNC Adapter

Tradutor REST ↔ serial da mesa CNC.

Porta: 8101

Onde roda: Host Windows (serial) ou container com profile simulado

Tecnologia: FastAPI

Base URL: http://localhost:8101

Swagger: http://localhost:8101/docs

Método | Rota | Grupo
GET | /ping | Saúde e diagnóstico
GET | /health | Saúde e diagnóstico
POST | /comandos/mover | Comandos
POST | /comandos/estado-celula | Comandos
POST | /comandos/parar | Comandos
POST | /comandos/centro | Comandos
POST | /comandos/homing | Comandos
POST | /eventos | Eventos (subida ao central)

## Saúde e diagnóstico

### GET /ping

Liveness: o processo está de pé. Usado como healthcheck; não consulta hardware nem outros serviços.

Autenticação: Nenhuma

Respostas

Código | Significado
200 | Sucesso.

### GET /health

Diagnóstico: conectividade com o central e com a ponta de baixo.

Autenticação: Nenhuma

Respostas

Código | Significado
200 | Sucesso.

## Comandos

### POST /comandos/mover

Manda a mesa ao waypoint do dispenser informado (gravado na placa). Responde com o ACK; a chegada vem depois como evento posicionado.

Autenticação: Nenhuma

Corpo JSON (ComandoMoverReq)

Campo | Tipo | Obrig. | Padrão
dispenser_alvo | integer | sim
os_id | string | sim
receita | string | sim
ciclo_atual | integer | não | 0
total_ciclos | integer | não | 0
posicao_x | number | null | não
posicao_y | number | null | não

Respostas

Código | Significado
200 | Sucesso.
422 | Corpo ou parâmetros inválidos (validação do FastAPI).

### POST /comandos/estado-celula

A trava do Triple Check chegando à mesa.

Autenticação: Nenhuma

Corpo JSON (EstadoCelulaReq)

Campo | Tipo | Obrig. | Padrão
trava_ativa | boolean | sim
trava_slot_id | integer | null | não
os_id | string | não
trava_resumo | string | não

Respostas

Código | Significado
200 | Sucesso.
422 | Corpo ou parâmetros inválidos (validação do FastAPI).

### POST /comandos/parar

A mesa para ONDE ESTÁ (porta NR-12) — sem ir ao HOME.

Autenticação: Nenhuma

Corpo JSON (ComandoPararReq)

Campo | Tipo | Obrig. | Padrão
motivo | string | não | "porta_aberta"

Respostas

Código | Significado
200 | Sucesso.
422 | Corpo ou parâmetros inválidos (validação do FastAPI).

### POST /comandos/centro

A caixa conferida vai ao centro operacional — o fim da OS.

Autenticação: Nenhuma

Corpo JSON (ComandoCentroReq)

Campo | Tipo | Obrig. | Padrão
os_id | string | sim

Respostas

Código | Significado
200 | Sucesso.
422 | Corpo ou parâmetros inválidos (validação do FastAPI).

### POST /comandos/homing

Manda a mesa ao HOME. A conclusão chega como evento concluido.

Autenticação: Nenhuma

Corpo JSON (ComandoHomingReq)

Campo | Tipo | Obrig. | Padrão
os_id | string | sim
posicao_x | number | null | não
posicao_y | number | null | não

Respostas

Código | Significado
200 | Sucesso.
422 | Corpo ou parâmetros inválidos (validação do FastAPI).

## Eventos (subida ao central)

### POST /eventos

Recebe eventos do cnc-simulator e repassa ao Central.

Autenticação: Nenhuma

Corpo JSON (EventoReq)

Campo | Tipo | Obrig. | Padrão
tipo | string | sim
os_id | string | null | não
dispenser_alvo | integer | null | não

Aceita campos adicionais, repassados sem interpretação.

Respostas

Código | Significado
200 | Sucesso.
422 | Corpo ou parâmetros inválidos (validação do FastAPI).

# 5. Vision Adapter

Ponte entre o central e a visão: aciona a estação da mesa, lê o veredito das estações dos dispensers e serve o catálogo da OS corrente a elas.

Porta: 8102

Onde roda: Container Docker

Tecnologia: FastAPI

Base URL: http://localhost:8102

Swagger: http://localhost:8102/docs

Método | Rota | Grupo
GET | /ping | Saúde e diagnóstico
GET | /health | Saúde e diagnóstico
POST | /comandos/capturar/dispenser | Comandos
POST | /comandos/capturar/mesa | Comandos
GET | /api/visao/catalogo | Catálogo e estoque das estações
GET | /estacoes/{lado}/api/visao/catalogo | Catálogo e estoque das estações
POST | /estacoes/{lado}/api/visao/estoque | Catálogo e estoque das estações
POST | /api/visao/estoque | Catálogo e estoque das estações
POST | /eventos | Eventos (subida ao central)

## Saúde e diagnóstico

### GET /ping

Liveness: o processo está de pé. Usado como healthcheck; não consulta hardware nem outros serviços.

Autenticação: Nenhuma

Respostas

Código | Significado
200 | Sucesso.

### GET /health

Verifica conectividade com vision-simulator e central-computer — e, com a fonte dos dispensers na estação real, com as duas estações.

Autenticação: Nenhuma

Respostas

Código | Significado
200 | Sucesso.

## Comandos

### POST /comandos/capturar/dispenser

Dispara captura da câmera de dispenser que cobre o slot especificado. Valida QR Code / DataMatrix / Código de Barras do produto carregado.

Autenticação: Nenhuma

Corpo JSON (CapturarDispenserReq)

Campo | Tipo | Obrig. | Padrão
slot_id | integer | sim
os_id | string | sim
sku_esperado | string | não
medicamento_esperado | string | não
quantidade_esperada | integer | não | 0
injetar_falha | string | null | não

Respostas

Código | Significado
200 | Sucesso.
422 | Corpo ou parâmetros inválidos (validação do FastAPI).

### POST /comandos/capturar/mesa

Dispara captura da câmera da mesa após dispensa no slot especificado. Detecta presença, quantidade e posição dos produtos na mesa.

Autenticação: Nenhuma

Corpo JSON (CapturarMesaReq)

Campo | Tipo | Obrig. | Padrão
slot_id | integer | sim
os_id | string | sim
quantidade_esperada | integer | não | 0
posicao_x | number | não | 0.0
posicao_y | number | não | 0.0
slots_cobertos | array de integer | null | não
quantidade_slot | integer | null | não
etapa | string | null | não
injetar_falha | string | null | não

Respostas

Código | Significado
200 | Sucesso.
422 | Corpo ou parâmetros inválidos (validação do FastAPI).

## Catálogo e estoque das estações

### GET /api/visao/catalogo

O catálogo da OS corrente, no formato de Catalogo.de_itens da estação.

Autenticação: Nenhuma

Respostas

Código | Significado
200 | Sucesso.

### GET /estacoes/{lado}/api/visao/catalogo

A mesma resposta, registrando QUAL estação buscou e quando.

Autenticação: Nenhuma

Parâmetros

Nome | Em | Tipo | Obrig. | Padrão
lado | caminho | string | sim

Respostas

Código | Significado
200 | Sucesso.
422 | Corpo ou parâmetros inválidos (validação do FastAPI).

### POST /estacoes/{lado}/api/visao/estoque

Mesmo papel de POST /api/visao/estoque (aceita e descarta), registrando o lado da estação.

Autenticação: Nenhuma

Parâmetros

Nome | Em | Tipo | Obrig. | Padrão
lado | caminho | string | sim

Respostas

Código | Significado
200 | Sucesso.
422 | Corpo ou parâmetros inválidos (validação do FastAPI).

### POST /api/visao/estoque

Aceita e descarta o estoque medido pela estação.

Autenticação: Nenhuma

Respostas

Código | Significado
200 | Sucesso.

## Eventos (subida ao central)

### POST /eventos

Recebe resultado de captura do vision-simulator e encaminha ao Central. O adapter não interpreta o resultado — repassa integralmente.

Autenticação: Nenhuma

Corpo JSON (EventoVisionReq)

Campo | Tipo | Obrig. | Padrão
tipo | string | sim
camera | string | sim
slot_id | integer | null | não
os_id | string | null | não

Aceita campos adicionais, repassados sem interpretação.

Respostas

Código | Significado
200 | Sucesso.
422 | Corpo ou parâmetros inválidos (validação do FastAPI).

# 6. Weight Adapter

Tradutor REST ↔ serial da balança HX711, com comandos de bancada (calibração, tara, contagem).

Porta: 8103

Onde roda: Host Windows (serial) ou container com profile simulado

Tecnologia: FastAPI

Base URL: http://localhost:8103

Swagger: http://localhost:8103/docs

Método | Rota | Grupo
GET | /ping | Saúde e diagnóstico
GET | /health | Saúde e diagnóstico
POST | /comandos/tara | Comandos
POST | /comandos/pesar | Comandos
POST | /eventos | Eventos (subida ao central)
GET | /balanca | Bancada (calibração da balança)
POST | /bancada/peso-unitario | Bancada (calibração da balança)
POST | /bancada/tara-recipiente | Bancada (calibração da balança)
POST | /bancada/tara-canais | Bancada (calibração da balança)
POST | /bancada/contar | Bancada (calibração da balança)
POST | /bancada/config | Bancada (calibração da balança)
POST | /bancada/stream | Bancada (calibração da balança)

## Saúde e diagnóstico

### GET /ping

Liveness: o processo está de pé. Usado como healthcheck; não consulta hardware nem outros serviços.

Autenticação: Nenhuma

Respostas

Código | Significado
200 | Sucesso.

### GET /health

Diagnóstico: conectividade com o central e com a ponta de baixo.

Autenticação: Nenhuma

Respostas

Código | Significado
200 | Sucesso.

## Comandos

### POST /comandos/tara

Zera a balança antes de uma OS.

Autenticação: Nenhuma

Corpo JSON (TaraReq)

Campo | Tipo | Obrig. | Padrão
os_id | string | não

Respostas

Código | Significado
200 | Sucesso.
422 | Corpo ou parâmetros inválidos (validação do FastAPI).

### POST /comandos/pesar

Solicita leitura de peso após dispensa no slot especificado.

Autenticação: Nenhuma

Corpo JSON (PesarReq)

Campo | Tipo | Obrig. | Padrão
os_id | string | sim
slot_id | integer | sim
quantidade_esperada | integer | sim
quantidade_real | integer | null | não
peso_unitario_g | number | sim
injetar_falha | string | null | não

Respostas

Código | Significado
200 | Sucesso.
422 | Corpo ou parâmetros inválidos (validação do FastAPI).

## Eventos (subida ao central)

### POST /eventos

Recebe resultado de pesagem do weight-simulator e encaminha ao Central.

Autenticação: Nenhuma

Corpo JSON (EventoReq)

Campo | Tipo | Obrig. | Padrão
tipo | string | sim
os_id | string | null | não
slot_id | integer | null | não

Aceita campos adicionais, repassados sem interpretação.

Respostas

Código | Significado
200 | Sucesso.
422 | Corpo ou parâmetros inválidos (validação do FastAPI).

## Bancada (calibração da balança)

### GET /balanca

Último de cada evento de bancada, como a placa o mandou.

Autenticação: Nenhuma

Respostas

Código | Significado
200 | Sucesso.

### POST /bancada/peso-unitario

Define o peso de UMA unidade, em gramas, e grava na NVS da placa.

Autenticação: Nenhuma

Corpo JSON (PesoUnitarioReq)

Campo | Tipo | Obrig. | Padrão
valor_g | number | sim

Respostas

Código | Significado
200 | Sucesso.
422 | Corpo ou parâmetros inválidos (validação do FastAPI).

### POST /bancada/tara-recipiente

Mede o pote VAZIO e o desconta de toda contagem seguinte.

Autenticação: Nenhuma

Respostas

Código | Significado
200 | Sucesso.

### POST /bancada/tara-canais

Zera os offsets do HX711 — é CALIBRAÇÃO, e vai para a NVS.

Autenticação: Nenhuma

Respostas

Código | Significado
200 | Sucesso.

### POST /bancada/contar

Espera a mesa estabilizar e conta por peso. Recusado sem peso unitário.

Autenticação: Nenhuma

Respostas

Código | Significado
200 | Sucesso.

### POST /bancada/config

Pede à placa que publique a config gravada — ela volta como cfg.

Autenticação: Nenhuma

Respostas

Código | Significado
200 | Sucesso.

### POST /bancada/stream

Liga/desliga o stream periódico de peso (5 Hz).

Autenticação: Nenhuma

Corpo JSON (StreamReq)

Campo | Tipo | Obrig. | Padrão
on | boolean | não | true

Respostas

Código | Significado
200 | Sucesso.
422 | Corpo ou parâmetros inválidos (validação do FastAPI).

# 7. CNC Simulator

Duplo da mesa CNC para demonstração e testes.

Porta: 8200

Onde roda: Container (profile simulado)

Tecnologia: FastAPI

Base URL: http://localhost:8200

Swagger: http://localhost:8200/docs

Método | Rota | Grupo
GET | /ping | Saúde e diagnóstico
GET | /status | Saúde e diagnóstico
POST | /executar/estado-celula | Comandos
POST | /executar/mover | Comandos
POST | /executar/centro | Comandos
POST | /executar/parar | Comandos
POST | /executar/homing | Comandos

## Saúde e diagnóstico

### GET /ping

Liveness: o processo está de pé. Usado como healthcheck; não consulta hardware nem outros serviços.

Autenticação: Nenhuma

Respostas

Código | Significado
200 | Sucesso.

### GET /status

Estado interno da CNC simulada (posição, alvo, homing, movimento).

Autenticação: Nenhuma

Respostas

Código | Significado
200 | Sucesso.

## Comandos

### POST /executar/estado-celula

Guarda o estado e age só na TRANSIÇÃO, como o firmware.

Autenticação: Nenhuma

Corpo JSON (EstadoCelulaReq)

Campo | Tipo | Obrig. | Padrão
trava_ativa | boolean | sim
trava_slot_id | integer | null | não
os_id | string | não
trava_resumo | string | não

Respostas

Código | Significado
200 | Sucesso.
422 | Corpo ou parâmetros inválidos (validação do FastAPI).

### POST /executar/mover

Simula o movimento até o dispenser e emite movendo/posicionado ao adapter.

Autenticação: Nenhuma

Corpo JSON (MoverReq)

Campo | Tipo | Obrig. | Padrão
dispenser_alvo | integer | sim
os_id | string | sim
receita | string | sim
ciclo_atual | integer | não | 0
total_ciclos | integer | não | 0

Respostas

Código | Significado
200 | Sucesso.
422 | Corpo ou parâmetros inválidos (validação do FastAPI).

### POST /executar/centro

Leva a caixa conferida ao centro — as regras do mover, como no firmware.

Autenticação: Nenhuma

Corpo JSON (CentroReq)

Campo | Tipo | Obrig. | Padrão
os_id | string | sim

Respostas

Código | Significado
200 | Sucesso.
422 | Corpo ou parâmetros inválidos (validação do FastAPI).

### POST /executar/parar

Para o movimento em curso ONDE ESTÁ, sem homing (porta NR-12).

Autenticação: Nenhuma

Corpo JSON (PararReq)

Campo | Tipo | Obrig. | Padrão
motivo | string | não | "porta_aberta"

Respostas

Código | Significado
200 | Sucesso.
422 | Corpo ou parâmetros inválidos (validação do FastAPI).

### POST /executar/homing

Simula o homing e emite concluido.

Autenticação: Nenhuma

Corpo JSON (HomingReq)

Campo | Tipo | Obrig. | Padrão
os_id | string | sim
posicao_x | number | null | não
posicao_y | number | null | não

Respostas

Código | Significado
200 | Sucesso.
422 | Corpo ou parâmetros inválidos (validação do FastAPI).

# 8. Dispenser Simulator

Duplo dos 8 dispensers.

Porta: 8201

Onde roda: Container (profile simulado)

Tecnologia: FastAPI

Base URL: http://localhost:8201

Swagger: http://localhost:8201/docs

Método | Rota | Grupo
GET | /ping | Saúde e diagnóstico
GET | /status | Saúde e diagnóstico
GET | /status/{slot_id} | Saúde e diagnóstico
POST | /executar/carregar | Comandos
POST | /executar/dispensar | Comandos
POST | /executar/parar | Comandos
POST | /executar/limpar | Comandos
POST | /executar/estado-celula | Comandos

## Saúde e diagnóstico

### GET /ping

Liveness: o processo está de pé. Usado como healthcheck; não consulta hardware nem outros serviços.

Autenticação: Nenhuma

Respostas

Código | Significado
200 | Sucesso.

### GET /status

Estado de todos os slots simulados.

Autenticação: Nenhuma

Respostas

Código | Significado
200 | Sucesso.

### GET /status/{slot_id}

Estado de um slot simulado.

Autenticação: Nenhuma

Parâmetros

Nome | Em | Tipo | Obrig. | Padrão
slot_id | caminho | integer | sim

Respostas

Código | Significado
200 | Sucesso.
422 | Corpo ou parâmetros inválidos (validação do FastAPI).

## Comandos

### POST /executar/carregar

Simula o carregamento do slot e emite carregado.

Autenticação: Nenhuma

Corpo JSON (CarregarReq)

Campo | Tipo | Obrig. | Padrão
dispenser_id | integer | sim
medicamento | string | sim
sku | string | não
categoria | string | não
quantidade | integer | sim
os_id | string | sim

Respostas

Código | Significado
200 | Sucesso.
422 | Corpo ou parâmetros inválidos (validação do FastAPI).

### POST /executar/dispensar

Simula a dispensa (com erro mecânico sorteado ou injetado) e emite dispensado.

Autenticação: Nenhuma

Corpo JSON (DispensarReq)

Campo | Tipo | Obrig. | Padrão
dispenser_id | integer | sim
os_id | string | sim
injetar_falha | string | null | não
quantidade | integer | null | não

Respostas

Código | Significado
200 | Sucesso.
422 | Corpo ou parâmetros inválidos (validação do FastAPI).

### POST /executar/parar

Para a dispensa em curso, se houver: termina a unidade atual e para.

Autenticação: Nenhuma

Corpo JSON (PararReq)

Campo | Tipo | Obrig. | Padrão
motivo | string | não | "porta_aberta"

Respostas

Código | Significado
200 | Sucesso.
422 | Corpo ou parâmetros inválidos (validação do FastAPI).

### POST /executar/limpar

Simula a limpeza do slot e emite limpeza_ok; recusa (409) slot em operação.

Autenticação: Nenhuma

Corpo JSON (LimparReq)

Campo | Tipo | Obrig. | Padrão
dispenser_id | integer | sim
solicitado_por | string | não | "sistema"

Respostas

Código | Significado
200 | Sucesso.
422 | Corpo ou parâmetros inválidos (validação do FastAPI).

### POST /executar/estado-celula

Só loga — ver EstadoCelulaReq. Nenhum evento sai daqui: o estado da célula é para pintar tela, e este simulador não tem nenhuma.

Autenticação: Nenhuma

Corpo JSON (EstadoCelulaReq)

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

Respostas

Código | Significado
200 | Sucesso.
422 | Corpo ou parâmetros inválidos (validação do FastAPI).

# 9. Vision Simulator

Duplo das três câmeras; rollback das estações reais.

Porta: 8202

Onde roda: Container Docker

Tecnologia: FastAPI

Base URL: http://localhost:8202

Swagger: http://localhost:8202/docs

Método | Rota | Grupo
GET | /ping | Saúde e diagnóstico
GET | /status | Saúde e diagnóstico
POST | /executar/capturar/dispenser | Comandos
POST | /executar/capturar/mesa | Comandos

## Saúde e diagnóstico

### GET /ping

Liveness: o processo está de pé. Usado como healthcheck; não consulta hardware nem outros serviços.

Autenticação: Nenhuma

Respostas

Código | Significado
200 | Sucesso.

### GET /status

Estado interno das câmeras simuladas.

Autenticação: Nenhuma

Respostas

Código | Significado
200 | Sucesso.

## Comandos

### POST /executar/capturar/dispenser

Inicia captura assíncrona da câmera de dispenser do lado do slot. O resultado é enviado via POST /eventos → adapter → central.

Autenticação: Nenhuma

Corpo JSON (CapturarDispenserReq)

Campo | Tipo | Obrig. | Padrão
slot_id | integer | sim
os_id | string | sim
sku_esperado | string | não
medicamento_esperado | string | não
quantidade_esperada | integer | não | 0
injetar_falha | string | null | não

Respostas

Código | Significado
200 | Sucesso.
422 | Corpo ou parâmetros inválidos (validação do FastAPI).

### POST /executar/capturar/mesa

Inicia captura assíncrona da câmera da mesa (a da balança). O resultado é enviado via POST /eventos → adapter → central.

Autenticação: Nenhuma

Corpo JSON (CapturarMesaReq)

Campo | Tipo | Obrig. | Padrão
slot_id | integer | sim
os_id | string | sim
quantidade_esperada | integer | não | 0
posicao_x | number | não | 0.0
posicao_y | number | não | 0.0
injetar_falha | string | null | não

Respostas

Código | Significado
200 | Sucesso.
422 | Corpo ou parâmetros inválidos (validação do FastAPI).

# 10. Weight Simulator

Duplo da balança HX711.

Porta: 8203

Onde roda: Container (profile simulado / balanca-simulada)

Tecnologia: FastAPI

Base URL: http://localhost:8203

Swagger: http://localhost:8203/docs

Método | Rota | Grupo
GET | /ping | Saúde e diagnóstico
GET | /leitura | Saúde e diagnóstico
POST | /reset | Saúde e diagnóstico
POST | /executar/tara | Comandos
POST | /executar/pesar | Comandos

## Saúde e diagnóstico

### GET /ping

Liveness: o processo está de pé. Usado como healthcheck; não consulta hardware nem outros serviços.

Autenticação: Nenhuma

Respostas

Código | Significado
200 | Sucesso.

### GET /leitura

Retorna leitura bruta e líquida atuais (para debug).

Autenticação: Nenhuma

Respostas

Código | Significado
200 | Sucesso.

### POST /reset

Reseta o estado interno da balança (usado entre testes). Não exposto em produção.

Autenticação: Nenhuma

Respostas

Código | Significado
200 | Sucesso.

## Comandos

### POST /executar/tara

Zera a balança (offset de tara). Deve ser chamado antes de cada OS.

Autenticação: Nenhuma

Corpo JSON (TaraReq)

Campo | Tipo | Obrig. | Padrão
os_id | string | não

Respostas

Código | Significado
200 | Sucesso.
422 | Corpo ou parâmetros inválidos (validação do FastAPI).

### POST /executar/pesar

Captura leitura de peso após dispensa de um slot.

Autenticação: Nenhuma

Corpo JSON (PesarReq)

Campo | Tipo | Obrig. | Padrão
os_id | string | sim
slot_id | integer | sim
quantidade_esperada | integer | sim
quantidade_real | integer | null | não
peso_unitario_g | number | sim
injetar_falha | string | null | não

Respostas

Código | Significado
200 | Sucesso.
422 | Corpo ou parâmetros inválidos (validação do FastAPI).

# 11. Estação de visão da mesa (visao_mesa)

Conta as caixinhas na caixa de coleta. Fala o mesmo contrato do vision-simulator.

Porta: 8212

Onde roda: Host Windows (dona da webcam)

Tecnologia: FastAPI

Base URL: http://localhost:8212

Swagger: http://localhost:8212/docs

Método | Rota | Grupo
GET | /ping | Saúde e diagnóstico
GET | /status | Saúde e diagnóstico
POST | /executar/capturar/mesa | Comandos
POST | /executar/capturar/dispenser | Comandos

## Saúde e diagnóstico

### GET /ping

Liveness: o processo está de pé. Usado como healthcheck; não consulta hardware nem outros serviços.

Autenticação: Nenhuma

Respostas

Código | Significado
200 | Sucesso.

### GET /status

Estado da estação: câmera pronta, OS conhecidas no acumulado, última captura.

Autenticação: Nenhuma

Respostas

Código | Significado
200 | Sucesso.

## Comandos

### POST /executar/capturar/mesa

Fotografa a caixa de coleta e conta as caixinhas. Responde na hora; o resultado (leitura_mesa_*) vai por POST ao vision-adapter.

Autenticação: Nenhuma

Corpo JSON (ComandoCaptura)

Campo | Tipo | Obrig. | Padrão
slot_id | integer | sim
os_id | string | sim
quantidade_esperada | integer | não | 0
posicao_x | number | null | não
posicao_y | number | null | não
injetar_falha | string | null | não

Aceita campos adicionais, repassados sem interpretação.

Respostas

Código | Significado
200 | Sucesso.
422 | Corpo ou parâmetros inválidos (validação do FastAPI).

### POST /executar/capturar/dispenser

Mantida por compatibilidade de contrato com o vision-simulator: esta estação não lê dispensers.

Autenticação: Nenhuma

Respostas

Código | Significado
200 | Sucesso.

# 12. Estações de visão dos dispensers (visao)

Julgam continuamente cada zona contra o catálogo que buscam no vision-adapter e publicam o veredito.

Porta: 8301 (esq, D1–D4) / 8302 (dir, D5–D8)

Onde roda: Host Windows (donas das webcams)

Tecnologia: http.server (biblioteca padrão)

Método | Rota | Grupo
GET | / | Endpoints
GET | /api/estado | Endpoints
GET | /api/eventos | Endpoints
GET | /api/resumo | Endpoints
GET | /api/integridade | Endpoints
GET | /api/saude | Endpoints

## Endpoints

### GET /

Dashboard HTML da estação.

Autenticação: Nenhuma

### GET /api/estado

Veredito atual de cada zona/dispenser (é o que o vision-adapter lê).

Autenticação: Nenhuma

### GET /api/eventos

Eventos registrados. Query: limite (100), tipo, dispenser, criticos=1.

Autenticação: Nenhuma

### GET /api/resumo

Resumo das últimas N horas. Query: horas (24).

Autenticação: Nenhuma

### GET /api/integridade

Verificação da trilha de auditoria de eventos.

Autenticação: Nenhuma

### GET /api/saude

Liveness/readiness da estação.

Autenticação: Nenhuma

# 13. Painel de bancada (painel_operador)

Painel do operador: espelha ordens e estoque do central (só leitura, exceto liberar a trava), gerencia lotes/FEFO e serve o display de 7" por serial.

Porta: 5000

Onde roda: Host Windows da bancada (dono da serial do display 7")

Tecnologia: Flask + SQLite (waitress)

Base URL: http://localhost:5000

Método | Rota | Grupo
GET / POST | /login | Autenticação
GET / POST | /trocar-pin | Autenticação
GET | /logout | Autenticação
GET | / | Páginas
GET | /ordens | Ordens
GET | /ordens/{id}/detalhe | Ordens
GET / POST | /ordens/nova | Ordens
GET / POST | /ordens/{id}/editar | Ordens
POST | /ordens/{id}/excluir | Ordens
POST | /ordens/{id}/status/{status} | Ordens
POST | /trava/liberar | Triple Check
GET | /medicamentos | Medicamentos e lotes
POST | /medicamentos/novo | Medicamentos e lotes
POST | /medicamentos/{id}/editar | Medicamentos e lotes
POST | /medicamentos/{id}/excluir | Medicamentos e lotes
POST | /medicamentos/{id}/reativar | Medicamentos e lotes
POST | /medicamentos/{id}/lotes/novo | Medicamentos e lotes
GET / POST | /lotes/entrada | Medicamentos e lotes
POST | /lotes/{id}/bloquear | Medicamentos e lotes
POST | /lotes/{id}/baixa | Medicamentos e lotes
GET | /rastreabilidade | Medicamentos e lotes
GET | /admin/desvios | Desvios
POST | /admin/desvios/{id}/atualizar | Desvios
GET | /visao | Visão
POST | /visao/mapeamento | Visão
GET | /catalogo | Catálogo
POST | /catalogo/novo | Catálogo
POST | /catalogo/{id}/excluir | Catálogo
GET | /clientes | Clientes
POST | /clientes/novo | Clientes
POST | /clientes/{id}/editar | Clientes
POST | /clientes/{id}/excluir | Clientes
GET | /relatorio | Relatórios e KPIs
GET | /relatorio/qrcode.png | Relatórios e KPIs
GET | /kpis | Relatórios e KPIs
GET | /admin | Administração
GET | /admin/operadores | Administração
POST | /admin/operadores/novo | Administração
POST | /admin/operadores/{id}/editar | Administração
POST | /admin/operadores/{id}/excluir | Administração
GET | /admin/historico | Administração
POST | /admin/historico/limpar | Administração
POST | /api/desvios | API para máquinas (/api/*)
POST | /api/visao/estoque | API para máquinas (/api/*)
GET | /api/visao/catalogo | API para máquinas (/api/*)
GET | /api/visao/movimentos | API para máquinas (/api/*)
GET | /api/ordens | API para máquinas (/api/*)
POST | /api/ordens | API para máquinas (/api/*)
PUT | /api/ordens/{id}/status | API para máquinas (/api/*)
GET | /api/resumo | API para máquinas (/api/*)
PUT | /api/dispensers/sync | API para máquinas (/api/*)
GET | /api/medicamentos | API para máquinas (/api/*)
GET | /api/dispensers | API para máquinas (/api/*)
PUT | /api/dispensers/{slot}/medicamento | API para máquinas (/api/*)
GET | /api/catalogo | API para máquinas (/api/*)
POST | /api/historico | API para máquinas (/api/*)
GET | /api/historico | API para máquinas (/api/*)

## Autenticação

### GET / POST /login

Login web por nome + PIN.

Autenticação: Nenhuma

### GET / POST /trocar-pin

Troca obrigatória do PIN de fábrica no primeiro acesso.

Autenticação: Sessão web (login + PIN)

### GET /logout

Encerra a sessão web.

Autenticação: Nenhuma

## Páginas

### GET /

Página inicial: resumo das ordens, estoque e alertas.

Autenticação: Sessão web (login + PIN)

## Ordens

### GET /ordens

Lista de ordens (locais e espelhadas do central), com filtro por status.

Autenticação: Sessão web (login + PIN) — permissão ordens_ver

### GET /ordens/{id}/detalhe

Rastreamento completo de uma ordem: linha do tempo (quem fez o que e quando), lotes consumidos por item (genealogia) e desvios relacionados — tudo num só lugar, seja a ação originada do app web ou do display.

Autenticação: Sessão web (login + PIN) — permissão ordens_ver

### GET / POST /ordens/nova

Cria ordem LOCAL (o central a ignora), com baixa FEFO.

Autenticação: Sessão web (login + PIN) — permissão ordens_criar

### GET / POST /ordens/{id}/editar

Edita ordem local.

Autenticação: Sessão web (login + PIN) — permissão ordens_editar

### POST /ordens/{id}/excluir

Exclui ordem local.

Autenticação: Sessão web (login + PIN) — permissão ordens_excluir; CSRF

### POST /ordens/{id}/status/{status}

Muda o status de ordem local (vocabulário fechado; ordem do central é só-leitura).

Autenticação: Sessão web (login + PIN) — permissão ordens_status

## Triple Check

### POST /trava/liberar

Libera a trava do Triple Check no central, em nome de quem está logado.

Autenticação: Sessão web (login + PIN) — permissão trava_liberar; CSRF

## Medicamentos e lotes

### GET /medicamentos

Cadastro de medicamentos e saldo.

Autenticação: Sessão web (login + PIN) — permissão dispensers_ver

### POST /medicamentos/novo

Cadastra medicamento.

Autenticação: Sessão web (login + PIN) — permissão dispensers_editar

### POST /medicamentos/{id}/editar

Edita medicamento.

Autenticação: Sessão web (login + PIN) — permissão dispensers_editar

### POST /medicamentos/{id}/excluir

Retira o medicamento do catalogo. DELETE so quando nao ha o que perder.

Autenticação: Sessão web (login + PIN) — permissão dispensers_editar; CSRF

### POST /medicamentos/{id}/reativar

Volta o medicamento ao catalogo.

Autenticação: Sessão web (login + PIN) — permissão dispensers_editar

### POST /medicamentos/{id}/lotes/novo

Cadastra lote de um medicamento.

Autenticação: Sessão web (login + PIN) — permissão lotes_editar

### GET / POST /lotes/entrada

Entrada de lote (formulário).

Autenticação: Sessão web (login + PIN) — permissão lotes_editar

### POST /lotes/{id}/bloquear

Bloqueia/desbloqueia lote (sai do saldo dispensável).

Autenticação: Sessão web (login + PIN) — permissão lotes_editar

### POST /lotes/{id}/baixa

Baixa manual de lote: vencido, avariado, perda etc. Remove o saldo do lote (e do agregado do medicamento) sem passar por consumo de ordem — completa a rastreabilidade cobrindo saidas que nao sao dispensacao.

Autenticação: Sessão web (login + PIN) — permissão lotes_editar

### GET /rastreabilidade

Consulta de genealogia: qual lote saiu em qual ordem.

Autenticação: Sessão web (login + PIN) — permissão lotes_ver

## Desvios

### GET /admin/desvios

Lista de desvios de qualidade.

Autenticação: Sessão web (login + PIN) — permissão desvios_ver

### POST /admin/desvios/{id}/atualizar

Atualiza o status de um desvio.

Autenticação: Sessão web (login + PIN) — permissão desvios_editar

## Visão

### GET /visao

Página da estação de visão do painel.

Autenticação: Sessão web (login + PIN) — permissão visao_ver

### POST /visao/mapeamento

Salva o mapeamento zona → medicamento da estação.

Autenticação: Sessão web (login + PIN) — permissão visao_editar

## Catálogo

### GET /catalogo

Página do catálogo.

Autenticação: Sessão web (login + PIN) — permissão catalogo_ver

### POST /catalogo/novo

Adiciona item ao catálogo.

Autenticação: Sessão web (login + PIN) — permissão catalogo_editar

### POST /catalogo/{id}/excluir

Remove item do catálogo.

Autenticação: Sessão web (login + PIN) — permissão catalogo_editar

## Clientes

### GET /clientes

Lista de clientes/destinos.

Autenticação: Sessão web (login + PIN) — permissão clientes_ver

### POST /clientes/novo

Cadastra cliente.

Autenticação: Sessão web (login + PIN) — permissão clientes_editar

### POST /clientes/{id}/editar

Edita cliente.

Autenticação: Sessão web (login + PIN) — permissão clientes_editar

### POST /clientes/{id}/excluir

Exclui cliente.

Autenticação: Sessão web (login + PIN) — permissão clientes_editar

## Relatórios e KPIs

### GET /relatorio

Relatório de ordens e estoque.

Autenticação: Sessão web (login + PIN) — permissão relatorio_ver

### GET /relatorio/qrcode.png

QR Code PNG que aponta para o relatório.

Autenticação: Nenhuma

### GET /kpis

Indicadores (SLA, volume, rupturas).

Autenticação: Sessão web (login + PIN) — permissão kpis_ver

## Administração

### GET /admin

Área administrativa.

Autenticação: Sessão web (login + PIN)

### GET /admin/operadores

Lista de operadores e perfis.

Autenticação: Sessão web (login + PIN) — permissão operadores_ver

### POST /admin/operadores/novo

Cria operador (PIN guardado como hash).

Autenticação: Sessão web (login + PIN) — permissão operadores_editar

### POST /admin/operadores/{id}/editar

Edita operador.

Autenticação: Sessão web (login + PIN) — permissão operadores_editar

### POST /admin/operadores/{id}/excluir

Exclui/desativa operador.

Autenticação: Sessão web (login + PIN) — permissão operadores_editar

### GET /admin/historico

Audit log.

Autenticação: Sessão web (login + PIN) — permissão historico_ver

### POST /admin/historico/limpar

Limpa o audit log.

Autenticação: Sessão web (login + PIN) — permissão historico_limpar; CSRF

## API para máquinas (/api/*)

### POST /api/desvios

Registra desvio via API.

Autenticação: Header X-API-Token (APSEN_API_TOKEN)

### POST /api/visao/estoque

Recebe o nível medido pela câmera e o transforma em estoque + validação.

Autenticação: Header X-API-Token (APSEN_API_TOKEN)

### GET /api/visao/catalogo

Diz à estação de visão o que ela deve esperar em cada zona da câmera.

Autenticação: Header X-API-Token (APSEN_API_TOKEN)

### GET /api/visao/movimentos

Movimentos de estoque detectados pela estação de visão.

Autenticação: Header X-API-Token (APSEN_API_TOKEN)

### GET /api/ordens

Fila de ordens (Pendente e Em Processo).

Autenticação: Header X-API-Token (APSEN_API_TOKEN)

### POST /api/ordens

Cria ordem local via API.

Autenticação: Header X-API-Token (APSEN_API_TOKEN)

### PUT /api/ordens/{id}/status

Atualiza status de ordem local via API.

Autenticação: Header X-API-Token (APSEN_API_TOKEN)

### GET /api/resumo

Contadores por status.

Autenticação: Header X-API-Token (APSEN_API_TOKEN)

### PUT /api/dispensers/sync

Sincroniza o estoque dos dispensers (recusa slot espelhado do central).

Autenticação: Header X-API-Token (APSEN_API_TOKEN)

### GET /api/medicamentos

Catálogo de medicamentos em JSON.

Autenticação: Header X-API-Token (APSEN_API_TOKEN)

### GET /api/dispensers

Estado dos 8 dispensers (espelho do central quando ativo).

Autenticação: Header X-API-Token (APSEN_API_TOKEN)

### PUT /api/dispensers/{slot}/medicamento

Troca o medicamento de um slot (recusa slot espelhado).

Autenticação: Header X-API-Token (APSEN_API_TOKEN)

### GET /api/catalogo

Catálogo em JSON.

Autenticação: Header X-API-Token (APSEN_API_TOKEN)

### POST /api/historico

Grava entrada no audit log via API.

Autenticação: Header X-API-Token (APSEN_API_TOKEN)

### GET /api/historico

Lê o audit log via API.

Autenticação: Header X-API-Token (APSEN_API_TOKEN)

# 14. Observações sobre o estado atual

Porta NR-12: hoje os comandos da porta (/comandos/porta/liberar, /negar e /estado) estão no dispenser-adapter. A mudança para um porta-adapter próprio (porta 8104, USB dedicada) está planejada em TASKS_PORTA_USB.md e ainda não existe no código; quando entrar, estas três rotas mudam de serviço.

Corpos de resposta: a maior parte das rotas do central não declara response_model, então o Swagger mostra o exemplo de resposta vazio. Os códigos de erro listados aqui são os que o código realmente devolve.

WebSocket: OpenAPI não descreve WebSocket; o WS /ws do central está documentado na seção do central.

APSEN — Referência de APIs
