jdszza/valoryapsen/fluxograma_sistema_apsen.png

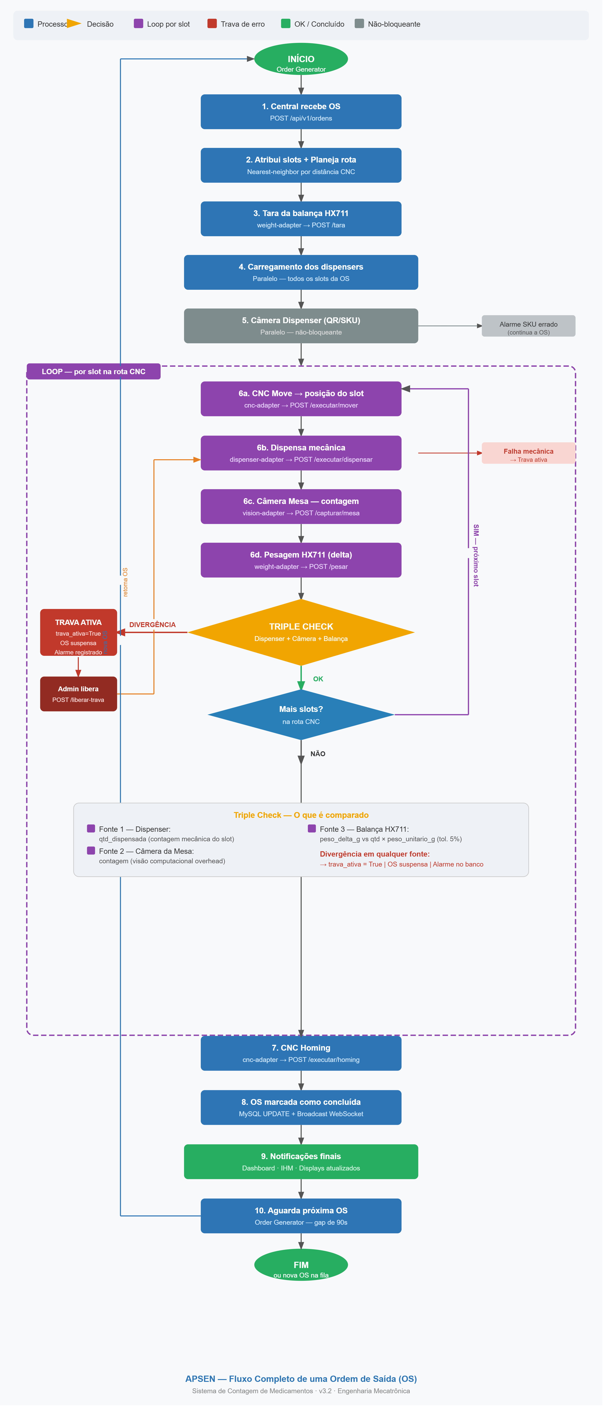
fluxograma_sistema_apsen.png
