jdszza/valoryapsen/vision/visao/tests/cena.png

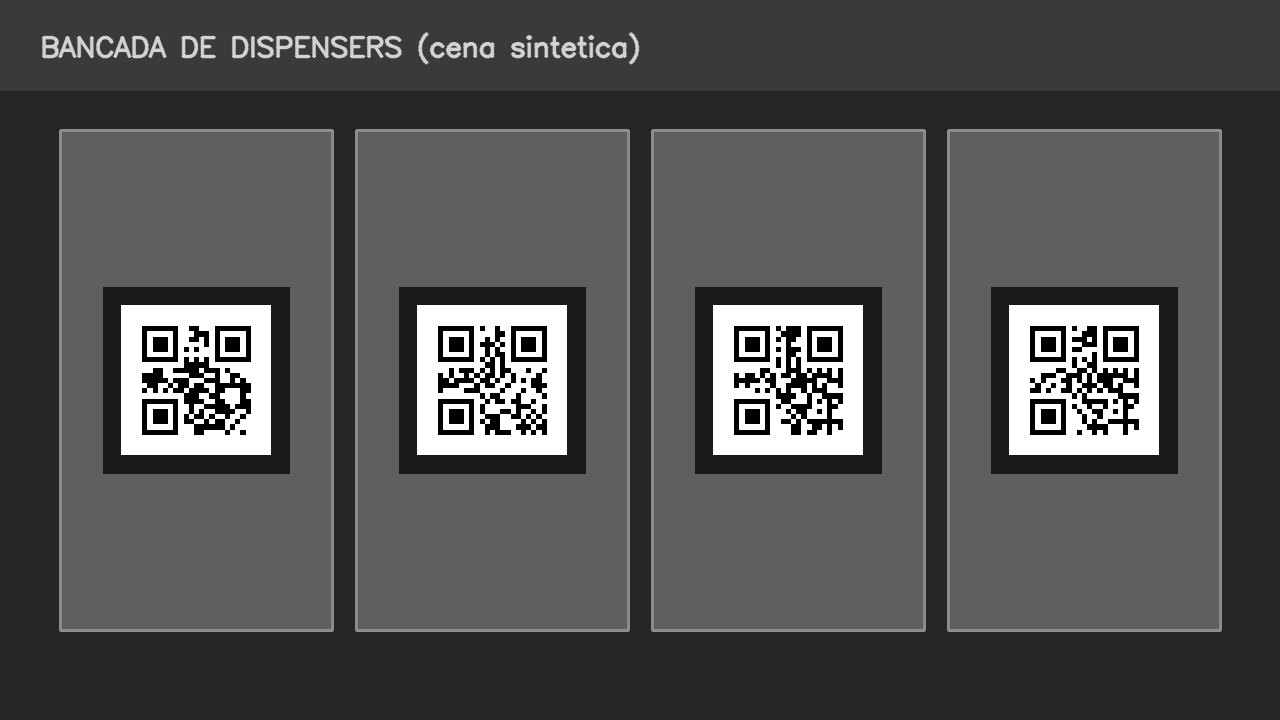
vision/visao/tests/cena.png
