jdszza/valoryapsen/dispenser-adapter/main.py

"""
APSEN - Dispenser Adapter v1.1
Bridge bidirecional entre o Computador Central e os 8 dispensers.

Fluxo entrada (← Central):
  POST /comandos/carregar   → `carregar`  nos dispensers
  POST /comandos/dispensar  → `dispensar` nos dispensers
  POST /comandos/limpar     → `limpar`    nos dispensers

Fluxo saída (← dispensers):
  POST /eventos             → normaliza e encaminha para central-computer POST /api/v1/eventos/dispenser

Os dispensers atendem por DOIS transportes, e quem escolhe é
`DISPENSER_TRANSPORTE`:

  "http"   (default) — o `dispenser-simulator`, como sempre. É o que roda no
                       Docker, no CI e em qualquer máquina sem hardware.
  "serial" — o firmware dos 8 dispensers, por UMA porta USB
             (`DISPENSER_SERIAL_URL`). Ver `docs/PROTOCOLO_SERIAL.md` e
             `serial_link.py`.

A perna de CIMA não sabe qual dos dois está embaixo: os endpoints, os modelos
Pydantic, o payload do evento e o `_post_central` são os mesmos nos dois casos.
É o que permite trocar o simulador por firmware sem tocar no central.

Há uma SEGUNDA placa, numa SEGUNDA porta, e o dono das duas é este adapter:
as 8 telas TFT (`dispenser_tft`, `DISPENSER_TFT_TRANSPORTE`). Acionar os 8
mecanismos, desenhar 8 telas e manter a serial não cabe num ESP só. Este
adapter já vê todo comando que desce e todo evento que sobe do slot — tudo que
as telas precisam mostrar —, então é ele quem as espelha:

  POST /comandos/estado-celula  → `estado_celula` na placa das telas (só nela)
  carregar/dispensar/limpar e os eventos carregado/dispensado/limpeza_ok/erro
                                → `slot` na placa das telas, na TRANSIÇÃO
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
