jdszza/valoryapsen/(commit log)

2026-06-23 fix bug router in ihm_web
    [app.py]
2026-06-24 fix bugs in simulators
    [app.py, database.py, main.py]
2026-06-25 refatoramento completo para remover mqtt e atualizar fluxo do sistema
2026-06-25 add simulador de peso e exportacao csv
2026-08-14 fix: corrige escopo de global em _do_pesar do weight-simulator
    _do_pesar() declarava `global _peso_anterior_g` dentro do bloco `with _lock:`
    sem incluir `_peso_mesa_g`, que e atribuido com `+=` logo abaixo. Python
    tratava o nome como local e toda pesagem estourava UnboundLocalError dentro
    da thread de background: falha silenciosa, nenhum evento emitido, orquestrador
    saindo so por TIMEOUT_PESO (15s por slot) e a balanca nunca participando do
    Triple Check.
    - _do_pesar(): declaracao global movida para o topo da funcao, fora do lock,
    incluindo _peso_mesa_g.
    - _do_tara(): mesmo padrao aplicado (a declaracao estava dentro do lock).
    Nao inclui _peso_mesa_g, que ali e apenas lido.
    - reset_estad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
    [test_weight_simulator.py]
2026-08-14 fix: destrava a limpeza de dispenser e o GET /status do simulador
    Dois bugs independentes no dispenser_simulator, ambos no mesmo arquivo.
    1) Botao "Limpar Dispenser" da IHM nunca funcionava depois da primeira OS.
    _do_dispensar() encerrava o slot com status="concluido" e deixava o os_id
    preso; _do_limpar() recusava a limpeza tanto por esse status quanto por
    `os_id is not None` — e era o unico caminho que zerava esses dois campos.
    Impasse permanente: o slot so sairia dali sendo limpo, e limpar era
    justamente o que estava bloqueado.
    - _do_dispensar(): estado terminal limpo (status="idle", os_id=None). O
    payload do evento "dispensado" ja usava o parametro os_id da func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
    [test_dispenser_simulator.py]
2026-08-17 fix bugs 5, 6 e 7
    [app.py, config.py, database.py, main.py, orchestrator.py, test_orchestrator.py, test_schema.py]
2026-08-22 task 1 - 8 dispensers;task 2 - 3 cameras
2026-08-30 features de 1 a 5
2026-09-12 tasks 6-11: apresentação, operação e painel de bancada
    Seis tasks do backlog, mais o painel de bancada e as correções de segurança
    P0/P1/P2 que ainda estavam fora do índice. 739 -> 951 testes.
    Tasks entregues
    ---------------
    6. MODO_APRESENTACAO e FATOR_VELOCIDADE globais, declarados uma vez no compose
    e lidos pelo central e pelos quatro simuladores. O modo zera toda
    probabilidade de falha aleatória (RUIDO_G incluído: σ=2g contra 100g
    esperados põe a tolerância de 5% a 2,5σ, e isso trava o Triple Check sem
    causa). O fator multiplica os tempos simulados, DIVIDE VEL_MM_S e escala os
    TIMEOUT_* por max(1, fator) — só para cima, porque acelerar não ganha nada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
2026-09-12 7 tasks: supervisor, telas TFT, aviso de trava e portas fixas no Windows
    Task 1 — Bugs soltos
    - ORDER BY prioridade DESC ordenava texto (Alta atrás de Baixa); trocado por
    CASE explícito (PRIORIDADES / _sql_ordem_prioridade).
    - peso_atual_g da telemetria da balança morria no handler; agora grava em
    leituras_sensores e publica em _estado["peso"] num campo próprio, sem tocar
    nos campos que o Triple Check lê.
    - Helper _ate() de tests/test_serial_link.py ganhou prazo configurável por
    APSEN_TESTE_ESPERA_S e mensagem que distingue "nunca aconteceu" de "demorou".
    Task 2 — Perfil Supervisor no central
    - Portão novo _get_supervisor_ou_admin (admin OU supervisor) para
    liberar-trav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
    [app.py, central_client.py, central_comandos.py, database.py, main.cpp, main.py, orchestrator.py, placa_dispenser_tft.py]
2026-10-13 add simulador de peso
2026-10-18 visao no homing e envio para o centro da mesa
2026-10-21 switch do triple check
2026-10-22 porta NR-12 em campo: nr12_oficial + receptor, porta-adapter só leitura
    A porta passou a ser duas ESPs (nr12_oficial + receptor_esp32) que falam
    texto e decidem a tag sozinhas. O porta-adapter agora só lê a USB do
    receptor (leitor_linhas.py) e traduz as linhas nos eventos de sempre
    (porta_texto.py); serial_link.py, ping/pong, ACK e heartbeat saíram.
    O central aceita autorizada_pela_porta (só para, não libera nem nega) e
    usa a fonte "porta" para abertura sem porta identificada.
    Cópias fiéis dos dois .ino com sha256 fixado; §10 do PROTOCOLO_SERIAL,
    porta/README, CLAUDE.md, README e DEPLOY_WINDOWS atualizados.
